nseiC/dds_waveform_generator/analog/simulation/pwl/LEIAME.txt

PWL dos 8 bits do DAC - DDS, seno de 1 kHz, 5 ciclos
=====================================================

Origem: simulação do VHDL do projeto (phase_accumulator + LUT, no GHDL), com
f = 1000 Hz, sel = "00" (seno, fpga/lut/sine_1024x8.mif) e clock do DDS de 10 MHz.
Os 50 001 códigos simulados são idênticos ao modelo do DDS:
    código[k] = seno[(k * FTW mod 2^32) >> 22]

    FTW = 429496            ->  f real = 999,9983 Hz
    1 amostra a cada 100 ns (10 MHz), 50 001 amostras = 5,0001 ms (5 ciclos)
    níveis 0 V e 3,3 V (LVTTL do GPIO da DE2-115), bordas de 2 ns
    código em offset binary: 128 = zero do sinal, faixa de 1 a 255

Arquivos
--------
    bit0.txt ... bit7.txt   PWL de cada bit, "tempo(s) tensão(V)" por linha
                            bit0 = LSB, bit7 = MSB
    dac_ideal.txt           referência: saída de um DAC ideal, 3,3 V * código / 256
    codigos.csv             código de 8 bits em cada amostra (t_s, codigo)

No LTspice
----------
    Fonte de tensão -> Advanced -> PWL File -> escolha o bitN.txt,
    ou escreva como valor da fonte:   PWL file=bit0.txt
    Salve o .asc nesta pasta: o caminho do arquivo é relativo ao esquemático.
    Simulação:   .tran 0 5m 0 50n   (passo máximo de 50 ns para ver os degraus)

Conferência
-----------
Com um R-2R ideal (R = 10 k, 2R = 20 k) ligado aos 8 bits, o LTspice 26 deu:
    máximo 3,287 V (código 255), mínimo 12,9 mV (código 1),
    diferença para dac_ideal.txt < 1 uV e frequência medida de 1000 Hz.
