nseiC/dds_waveform_generator/overleaf/preambulo/metadados.tex

%-----------------------------------------------------------------
% METADADOS DO TRABALHO
%-----------------------------------------------------------------

\author{Nicholas Seifert}
\title{Gerador de formas de onda por síntese digital direta em FPGA}
\engtitle{Direct digital synthesis waveform generator on FPGA}
\date{2026}
\advisor{André Luis Régis Monteiro, Prof.\ Dr.}
%---
% Deixe o comando \coadvisor comentado, caso não tenha co-orientador
\coadvisor{Márcio Rodrigues da Cunha, Prof.\ Dr.}
%---
% A DEFINIR: data da defesa
\approvaldate{A DEFINIR}
%---
% Membros da banca, titulação e instituição vinculada (A DEFINIR)
\boardst{MEMBRO DA BANCA A DEFINIR\\%
	Titulação\\%
	Instituição}
\boardnd{MEMBRO DA BANCA A DEFINIR\\%
	Titulação\\%
	Instituição}
\boardrd{MEMBRO DA BANCA A DEFINIR\\%
	Titulação\\%
	Instituição}
%---
