nseiC/dds_waveform_generator/overleaf/figuras/tb_dds_core_latencia.pdf

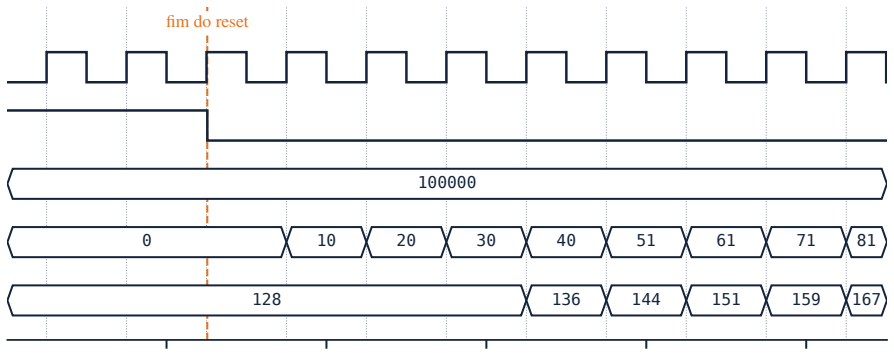
[picture p13: figure]
fim do reset

400 | 600 | 800 | 1000 | 1200

# tempo (ns)

## clk

## rst

## frequency

## endereço

## sample
