nseiC/dds_waveform_generator/overleaf/figuras/tb_DDS_pll.pdf

2000 | 2100 | 2200 | 2300 | 2400 | 2500 | 2600 | 2700
tempo (ns)

clk_50

clk10

led_locked

rst (interno)

dac | 80

PLL travado
