nseiC/dds_waveform_generator/overleaf/figuras/tb_reset_sync.pdf

200 | 400 | 600 | 800 | 1000 | 1200
tempo (ns)

clk

rst_in

chain

rst_out

111 | 110 | 100 | 000 | 111
rst_in cai | rst_in sobe
