nseiC/dds_waveform_generator/overleaf/main.tex

% TCC: Gerador de formas de onda por síntese digital direta em FPGA (Nicholas Seifert).
% Baseado no modelo canônico de TCC do curso de Engenharia Eletrônica da UTFPR campus Campo
% Mourão (prof. Osmar Tormena Júnior). Trechos em vermelho (\pendente) ainda dependem do autor.
%

%-----------------------------------------------------------------
% METADADOS PDF/A
%-----------------------------------------------------------------
\begin{filecontents*}{\jobname.xmpdata}
	\Author{Nicholas Seifert}
	\Title{Gerador de formas de onda por síntese digital direta em FPGA}
	\Language{pt-BR}
	\Keywords{síntese digital direta\sep FPGA\sep VHDL\sep gerador de funções\sep JTAG}
	\Publisher{RIUT}
	\Subject{Desenvolvimento de um gerador de formas de onda por síntese digital direta em FPGA, controlado por computador via Virtual JTAG, com placa analógica de saída.}
	\Copyright{Creative Commons}
	\CopyrightURL{https://creativecommons.org/licenses/by/4.0/deed.pt_BR}
	\Contributor{André Luis Régis Monteiro \sep Márcio Rodrigues da Cunha}
\end{filecontents*}

\documentclass[%
%---
% Escolha apenas uma das políticas de licenciamento
	by,				% licença CC-BY
%	by-sa,		% licença CC-BY-SA
%	by-nd,		% licença CC-BY-ND
%	by-nc,		% licença CC-BY-NC
%	by-nc-sa,	% licença CC-NC-SA
%	by-nc-nd,	% licença CC-BY-NC-ND
%---
%---
% Escolha apenas um formato de citação ABNT
%	alf	% citação (AUTOR, DATA), com referências em ordem alfabética
	num	% citação numérica, com referências na ordem de citação
%---
]{tcc-coele-cm}

%-----------------------------------------------------------------
% DADOS E CONFIGURAÇÕES PARTICULARES DO DOCUMENTO
%-----------------------------------------------------------------

\input{./preambulo/metadados}	% Metadados do trabalho
\input{./preambulo/preambulo}	% Pacotes adicionais e macros do autor

%-----------------------------------------------------------------
% ARQUIVO DE REFERÊNCIAS
%-----------------------------------------------------------------

\addbibresource{./postextual/refs.bib}

%-----------------------------------------------------------------
% INÍCIO DO DOCUMENTO
%-----------------------------------------------------------------

\begin{document}

%-----------------------------------------------------------------
% PARTE EXTERNA
%-----------------------------------------------------------------

\maketitle	% Capa

%-----------------------------------------------------------------
% PARTE INTERNA
%-----------------------------------------------------------------

%-----------------------------------------------------------------
% ELEMENTOS PRÉ-TEXTUAIS
%-----------------------------------------------------------------

\frontmatter
\maketitlepage		% Folha de rosto
\approval			% Folha de aprovação
\dedication			% Dedicatória (opcional)
\acknowledgment		% Agradecimentos (opcional)
\printepigraph		% Epígrafe (opcional)
\printabstract		% Resumo
\printengabstract	% Abstract
\printlof			% Lista de figuras (opcional)
\printlot			% Lista de tabelas (opcional)
\printloa			% Lista de acrônimos e siglas (opcional)
\printtoc			% Sumário

%-----------------------------------------------------------------
% ELEMENTOS TEXTUAIS
%-----------------------------------------------------------------

\mainmatter
\acresetall	% siglas por extenso de novo na primeira vez que aparecem no texto
\include{./textual/introducao}
\include{./textual/teoria}
\include{./textual/metodologia}
\include{./textual/resultados}
\include{./textual/conclusao}

%-----------------------------------------------------------------
% ELEMENTOS PÓS-TEXTUAIS
%-----------------------------------------------------------------

\backmatter
\printbibliography

%---
% Apêndices (opcional)
\appendix
\chapter{Organização do repositório}\label{ap:repositorio}
\input{./postextual/apendice}
\chapter{Visão RTL e simulação dos blocos menores}\label{ap:blocos}
\input{./postextual/apendice_blocos}
\chapter{Telas do osciloscópio}\label{ap:osciloscopio}
\input{./postextual/apendice_osciloscopio}
\chapter{Modelo SPICE do DAC0800}\label{ap:dac0800}
\input{./postextual/apendice_dac0800}
\chapter{Instrumentos utilizados}\label{ap:instrumentos}
\input{./postextual/apendice_instrumentos}
\chapter{Softwares utilizados}\label{ap:softwares}
\input{./postextual/apendice_softwares}
%---

%---
% Anexos (opcional)
%\attachment
%\chapter{Meu anexo}
%\input{./postextual/anexo}
%---

%-----------------------------------------------------------------
% FIM DO DOCUMENTO
%-----------------------------------------------------------------

\end{document}
