nseiC/dds_waveform_generator/overleaf/preambulo/preambulo.tex

%-----------------------------------------------------------------
% PACOTES DO AUTOR
%-----------------------------------------------------------------

\usepackage{multirow}	% célula em múltiplas linhas em uma tabela
\usepackage{listings}	% listagem de código (Apêndice D)
\lstset{basicstyle=\ttfamily\scriptsize, columns=fullflexible, keepspaces=true, breaklines=true,
	numbers=left, numberstyle=\tiny, xleftmargin=2em, framexleftmargin=2em, frame=tb,
	showstringspaces=false, upquote=true}

%-----------------------------------------------------------------
% DEFINIÇÕES DO AUTOR
%-----------------------------------------------------------------

% Trecho que ainda depende do autor (dados, ensaios em bancada): aparece em vermelho
% no PDF. Procure por \pendente antes da versão final.
\newcommand{\pendente}[1]{\textcolor{red}{[#1]}}

% Nomes de entidades, sinais e arquivos do projeto
\newcommand{\cod}[1]{\texttt{#1}}

% Epígrafe mais larga que o padrão do memoir (0,4), para os versos não quebrarem
\setlength{\epigraphwidth}{0.6\textwidth}

%-----------------------------------------------------------------
% DEFINIÇÕES DE SIGLAS, ACRÔNIMOS E ABREVIATURAS
%-----------------------------------------------------------------

\DeclareAcronym{csv}{%
	short=CSV,%
	long=Valores Separados por Vírgula,%
	foreign=\eng{Comma-Separated Values}%
}
\DeclareAcronym{dac}{%
	short=DAC,%
	long=Conversor Digital-Analógico,%
	foreign=\eng{Digital-to-Analog Converter}%
}
\DeclareAcronym{dds}{%
	short=DDS,%
	long=Síntese Digital Direta,%
	foreign=\eng{Direct Digital Synthesis}%
}
\DeclareAcronym{ecg}{%
	short=ECG,%
	long=Eletrocardiograma%
}
\DeclareAcronym{enob}{%
	short=ENOB,%
	long=Número Efetivo de Bits,%
	foreign=\eng{Effective Number of Bits}%
}
\DeclareAcronym{fft}{%
	short=FFT,%
	long=Transformada Rápida de Fourier,%
	foreign=\eng{Fast Fourier Transform}%
}
\DeclareAcronym{fpga}{%
	short=FPGA,%
	long=Arranjo de Portas Programável em Campo,%
	long-plural-form=Arranjos de Portas Programáveis em Campo,%
	foreign=\eng{Field-Programmable Gate Array}%
}
\DeclareAcronym{ftw}{%
	short=FTW,%
	long=Palavra de Sintonia de Frequência,%
	foreign=\eng{Frequency Tuning Word}%
}
\DeclareAcronym{gpio}{%
	short=GPIO,%
	long=Entrada e Saída de Uso Geral,%
	foreign=\eng{General-Purpose Input/Output}%
}
\DeclareAcronym{ip}{%
	short=IP,%
	long=Bloco de Propriedade Intelectual,%
	long-plural-form=Blocos de Propriedade Intelectual,%
	foreign=\eng{Intellectual Property}%
}
\DeclareAcronym{jtag}{%
	short=JTAG,%
	long=Grupo de Ação Conjunta de Teste,%
	foreign=\eng{Joint Test Action Group}%
}
\DeclareAcronym{le}{%
	short=LE,%
	long=Elemento Lógico,%
	long-plural-form=Elementos Lógicos,%
	foreign=\eng{Logic Element}%
}
\DeclareAcronym{lsb}{%
	short=LSB,%
	long=Bit Menos Significativo,%
	foreign=\eng{Least Significant Bit}%
}
\DeclareAcronym{lut}{%
	short=LUT,%
	long=Tabela de Consulta,%
	foreign=\eng{Look-Up Table}%
}
\DeclareAcronym{mif}{%
	short=MIF,%
	long=Arquivo de Inicialização de Memória,%
	foreign=\eng{Memory Initialization File}%
}
\DeclareAcronym{msb}{%
	short=MSB,%
	long=Bit Mais Significativo,%
	foreign=\eng{Most Significant Bit}%
}
\DeclareAcronym{pll}{%
	short=PLL,%
	long=Malha de Captura de Fase,%
	long-plural-form=Malhas de Captura de Fase,%
	foreign=\eng{Phase-Locked Loop}%
}
\DeclareAcronym{ram}{%
	short=RAM,%
	long=Memória de Acesso Aleatório,%
	long-plural-form=Memórias de Acesso Aleatório,%
	foreign=\eng{Random-Access Memory}%
}
\DeclareAcronym{rom}{%
	short=ROM,%
	long=Memória Somente de Leitura,%
	long-plural-form=Memórias Somente de Leitura,%
	foreign=\eng{Read-Only Memory}%
}
\DeclareAcronym{sdc}{%
	short=SDC,%
	long=Restrições de Projeto da Synopsys,%
	foreign=\eng{Synopsys Design Constraints}%
}
\DeclareAcronym{sfdr}{%
	short=SFDR,%
	long=Faixa Dinâmica Livre de Espúrios,%
	foreign=\eng{Spurious-Free Dynamic Range}%
}
\DeclareAcronym{sinad}{%
	short=SINAD,%
	long=Relação Sinal-Ruído e Distorção,%
	foreign=\eng{Signal-to-Noise and Distortion Ratio}%
}
\DeclareAcronym{snr}{%
	short=SNR,%
	long=Relação Sinal-Ruído,%
	foreign=\eng{Signal-to-Noise Ratio}%
}
\DeclareAcronym{tap}{%
	short=TAP,%
	long=Porta de Acesso de Teste,%
	foreign=\eng{Test Access Port}%
}
\DeclareAcronym{thd}{%
	short=THD,%
	long=Distorção Harmônica Total,%
	foreign=\eng{Total Harmonic Distortion}%
}
\DeclareAcronym{usb}{%
	short=USB,%
	long=Barramento Serial Universal,%
	foreign=\eng{Universal Serial Bus}%
}
\DeclareAcronym{utfpr}{%
	short=UTFPR-CM,%
	long=Universidade Tecnológica Federal do Paraná campus Campo Mourão%
}
\DeclareAcronym{vcd}{%
	short=VCD,%
	long=Arquivo de Mudança de Valores,%
	foreign=\eng{Value Change Dump}%
}
\DeclareAcronym{vhdl}{%
	short=VHDL,%
	long=Linguagem de Descrição de Hardware para Circuitos Integrados de Altíssima Velocidade,%
	foreign=\eng{VHSIC Hardware Description Language}%
}
\DeclareAcronym{zoh}{%
	short=ZOH,%
	long=Retentor de Ordem Zero,%
	foreign=\eng{Zero-Order Hold}%
}
