nseiC/dds_waveform_generator/overleaf/pretextual/agradecimentos.tex

Agradeço ao meu pai, exemplo de virtude em vida; à minha mãe, verdadeira guerreira apesar das dificuldades que a vida mostrou; à minha avó, pilar de sabedoria; ao corpo docente do DAELN-CM, pelo conhecimento compartilhado durante a graduação; ao prof.\ Dr.\ Lucas Ricken Garcia, pelo aconselhamento nas horas em que precisei; aos professores orientadores, pela oportunidade do projeto de ensino; ao prof.\ Dr.\ Francisco José Viglus, pela oportunidade de iniciação científica; e aos meus amigos, os verdadeiros, que não me julgaram diante das minhas dificuldades.
