nseiC/dds_waveform_generator/overleaf/pretextual/epigrafe.tex

% lista de epígrafes, o primeiro argumento é o texto, o segundo é a fonte
\qitem{Valeu a pena? Tudo vale a pena\\
Se a alma não é pequena.\\
Quem quer passar além do Bojador\\
Tem que passar além da dor.\\
Deus ao mar o perigo e o abismo deu,\\
Mas nele é que espelhou o céu.}%
{Fernando Pessoa, \enquote{Mar Português}, em \emph{Mensagem} (1934)}
