nseiC/dds_waveform_generator/overleaf/figuras/hierarquia.pdf

DDS | top-level: pinos da DE2-115
PLL | 50 MHz → 10 MHz (IP)
reset_sync | reset liberado em sincronia
jtag_interface | controle pelo PC
jtag | Virtual JTAG (IP)
jtag_control | lógica do controle
vjtag_dr | registrador DR (domínio do tck)
cmd_sync | travessia tck → 10 MHz
control_registers | frequência, forma, escrita na LUT
dds_core | núcleo do DDS (10 MHz)
phase_accumulator | acumulador de fase
frequency_translator | Hz → FTW
word_adder | FTW + fase
phase_register | registrador de 32 bits
truncator | fase(31..22)
LUT | fase → amplitude
sine/saw/sinc_LUT | ROMs 1024 × 8 (IP)
arbitrary_LUT | RAM de duas portas (IP)
out_mux | seleção da forma
output_register | amostra para o DAC
dac_clock | clock do DAC no GPIO[1]
