nseiC/dds_waveform_generator/overleaf/figuras/spice_fft.pdf

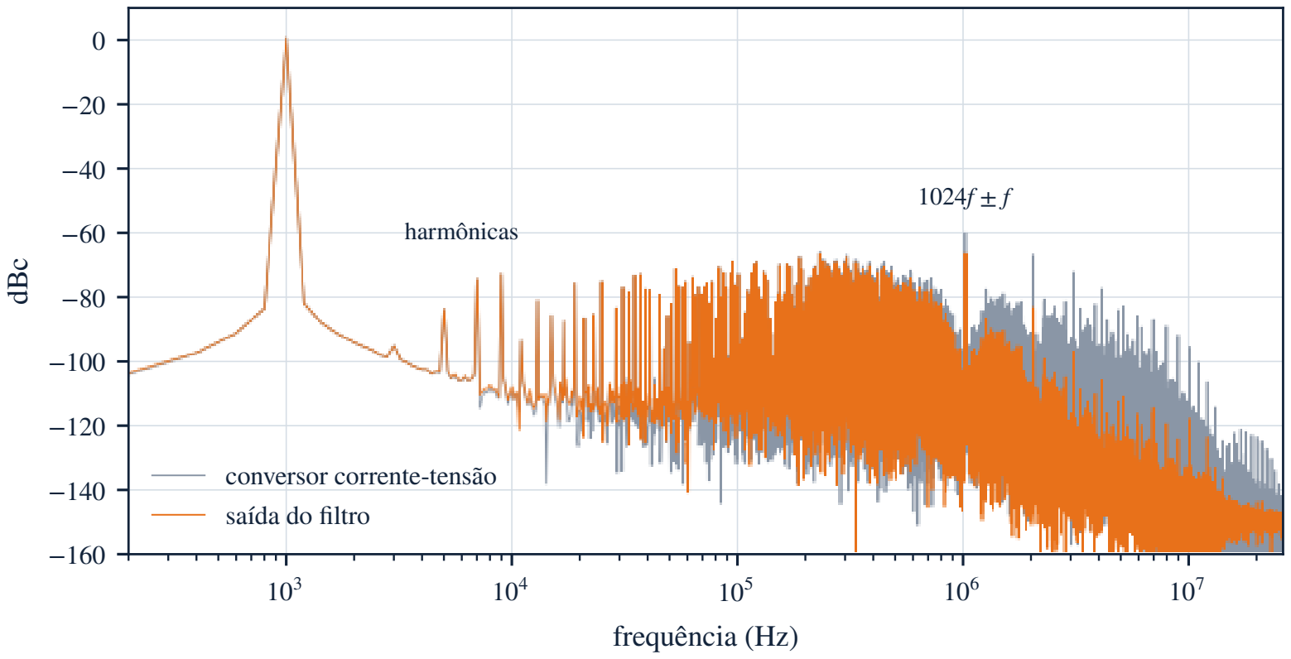
[picture p49: page 1]

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
frequência (Hz)

−160

−140

−120

−100

−80

−60

−40

−20

0

dBc

harmônicas

1024f ± f

conversor corrente-tensão
saída do filtro
