nseiC/dds_waveform_generator/overleaf/figuras/filtro.pdf

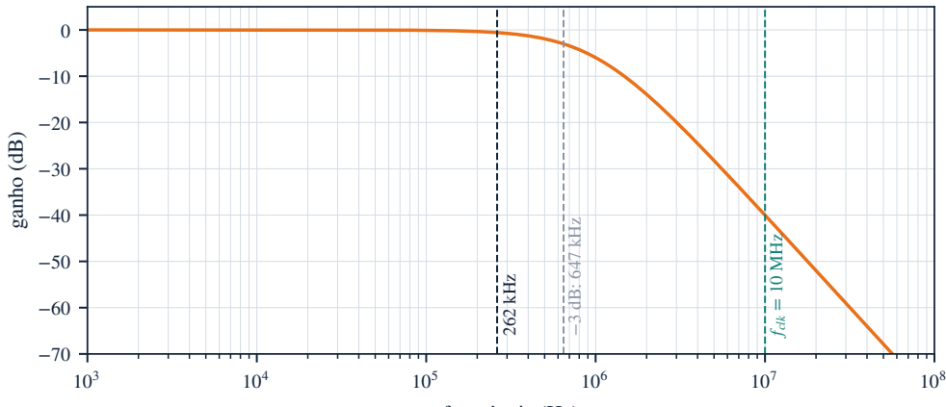
[picture p50: figure]
ganho (dB) −3 dB: 647 kHz 262 kHz; fclk = 10 MHz

8

# frequência (Hz)
