nseiC/dds_waveform_generator/overleaf/figuras/tb_cmd_sync.pdf

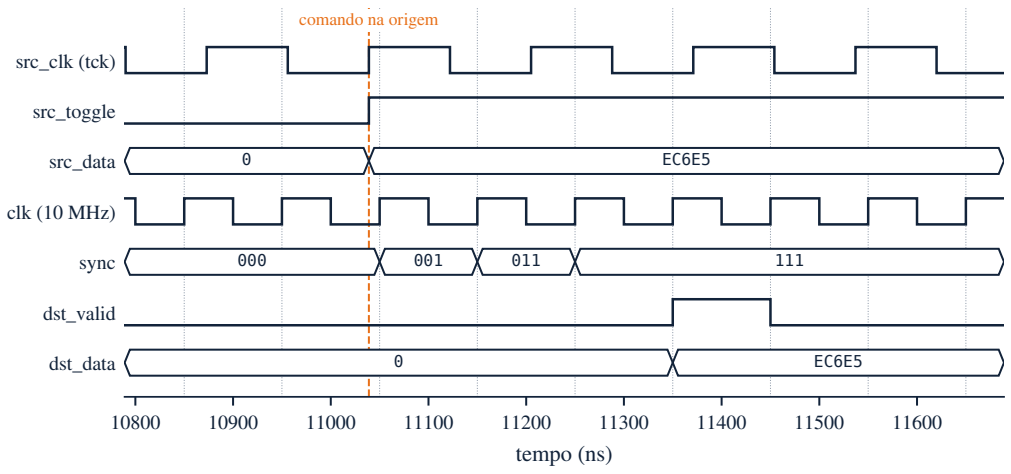
[picture p51: figure]
tempo (ns); src_clk (tck); src_toggle; src_data; clk (10 MHz); sync; dst_valid; dst_data; comando na origem
