nseiC/dds_waveform_generator/overleaf/figuras/tb_jtag_control.pdf

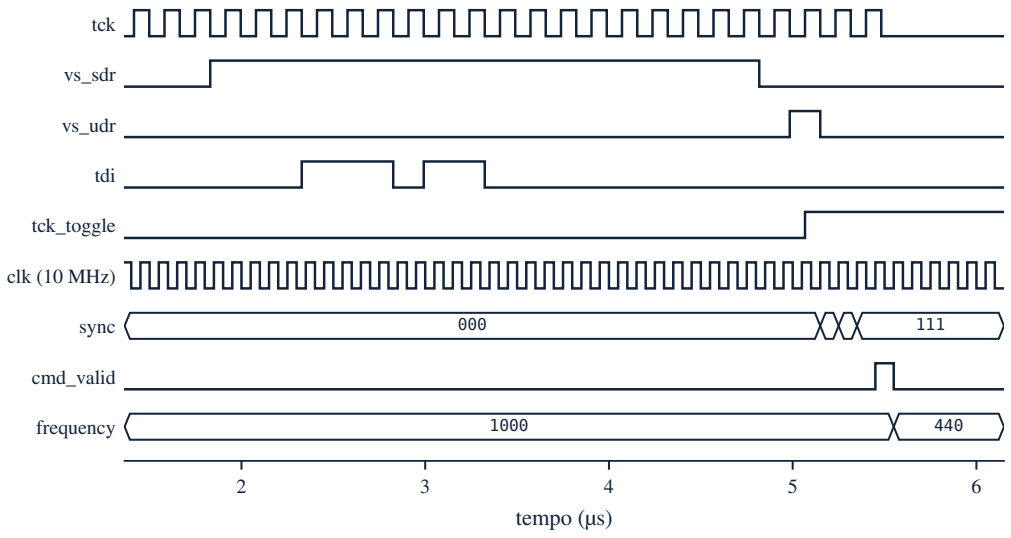
[picture p52: figure]
tempo (µs); tck; vs_sdr; vs_udr; tdi; tck_toggle; clk (10 MHz); sync; cmd_valid; frequency
