nseiC/dds_waveform_generator/overleaf/figuras/tb_LUT_latencia.pdf

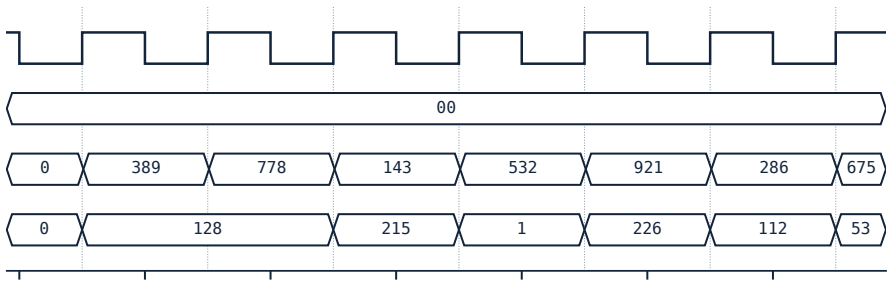
[picture p53: figure]

100 | 200 | 300 | 400 | 500 | 600 | 700

# tempo (ns)

## clk

## sel

## addr

## qOut
