nseiC/dds_waveform_generator/overleaf/figuras/tb_output_register.pdf

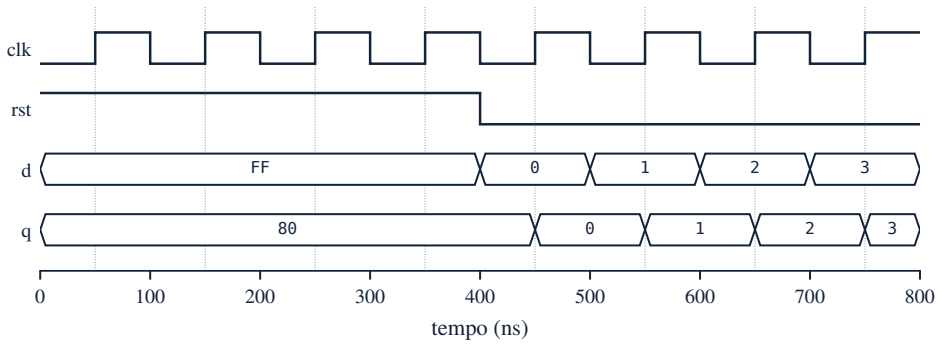
[picture p54: figure]
tempo (ns); clk; rst
