nseiC/dds_waveform_generator/overleaf/figuras/tb_phase_register.pdf

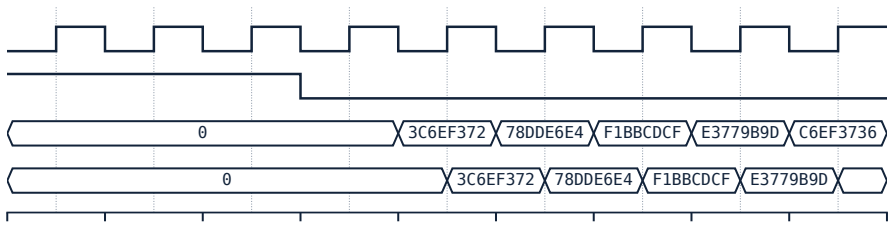
[picture p55: figure]
3C6EF372 78DDE6E4 F1BBCDCF E3779B9D C6EF3736; 78DDE6E4; F1BBCDCF

0 | 100 | 200 | 300 | 400 | 500 | 600 | 700 | 800 | 900

# tempo (ns)

## clk

## rst

## word

## wOut

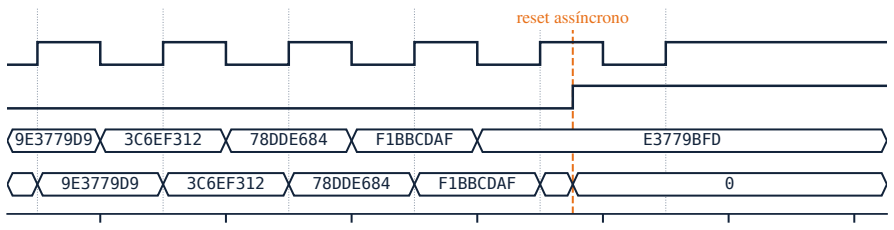
[picture p56: figure]
78DDE684; F1BBCDAF; E3779BFD; reset assíncrono

10000 | 10100 | 10200 | 10300 | 10400 | 10500 | 10600

# tempo (ns)

## clk rst word wOut
