nseiC/dds_waveform_generator/overleaf/figuras/tb_system_visao_geral.pdf

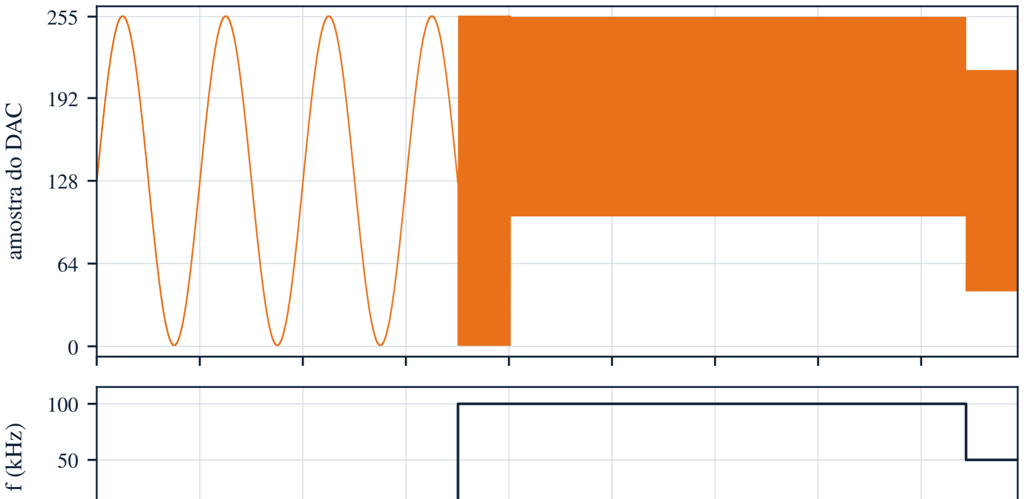
[picture p57: figure]
amostra do DAC; f (kHz)

0

0 | 1 | 2 | 3 | 4 | 5 | 6 | 7 | 8
tempo (ms)

JTAG

forma

1024 comandos de escrita na LUT

seno | sinc | arbitrária
