nseiC/dds_waveform_generator/overleaf/figuras/tb_word_adder.pdf

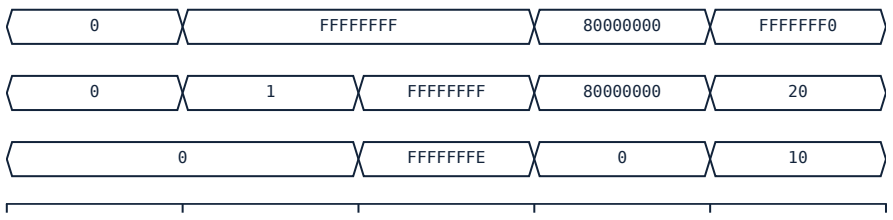
[picture p58: figure]
FFFFFFFF; FFFFFFF0; FFFFFFFE

0 | 1 | 2 | 3 | 4 | 5

# tempo (ns)

## ftw

## feedback

## wOut
