nseiC/dds_waveform_generator/overleaf/textual/resultados.tex

\chapter{Resultados e discussões}\label{cap:resultados}

Este capítulo apresenta os resultados da síntese do projeto digital no \ac{fpga}, da verificação por simulação, da simulação da placa analógica e dos ensaios em bancada, discutindo cada um.

\section{Síntese e análise de tempo}

O projeto foi compilado no Quartus Prime 18.1 Lite para o EP4CE115F29C7. A Tabela~\ref{tab:recursos} mostra os recursos usados. O gerador ocupa menos de 1\% dos elementos lógicos do \ac{fpga}. Os 32\,768~bits de memória correspondem às quatro tabelas de \(1024 \times 8\)~bits, e os quatro multiplicadores de \(9 \times 9\)~bits são os da conversão de frequência da Equação~(\ref{eq:ftw}). Os registradores de saída do barramento do \ac{dac} e o registrador de taxa dupla do seu clock foram efetivamente alocados nos elementos de entrada e saída, junto aos pinos.

\begin{table}
	\caption{Recursos do \acs{fpga} usados pelo projeto.}
	\label{tab:recursos}
	\begin{tabular}{l r r}\toprule
		Recurso & Usado & Disponível\\\midrule
		Elementos lógicos & 378 & 114\,480\\
		Registradores & 264 & ---\\
		Bits de memória & 32\,768 & 3\,981\,312\\
		Multiplicadores de \(9 \times 9\)~bits & 4 & 532\\
		\acp{pll} & 1 & 4\\
		Pinos & 14 & 529\\\bottomrule
	\end{tabular}
	\legend{Fonte~---~Autoria própria.}
\end{table}

A Tabela~\ref{tab:tempo} resume a análise de tempo, no modelo mais lento do dispositivo (1,2~V e 85~°C). O domínio de 10~MHz poderia operar a até 100,28~MHz, uma margem de dez vezes. O domínio do \ac{jtag} poderia operar a até 29,49~MHz, contra os 6~MHz máximos do USB-Blaster. Todas as folgas são positivas, e nenhum caminho ficou sem restrição de tempo.

\begin{table}
	\caption{Resultado da análise de tempo (modelo lento, 85~°C).}
	\label{tab:tempo}
	\begin{tabular}{l c c c}\toprule
		Domínio de clock & Frequência máxima & Folga de \eng{setup} & Folga de \eng{hold}\\\midrule
		10~MHz (\ac{pll}) & 100,28~MHz & 90,0~ns & 0,32~ns\\
		\cod{tck} (\ac{jtag}) & 29,49~MHz & 33,0~ns & 0,40~ns\\\bottomrule
	\end{tabular}
	\legend{Fonte~---~Autoria própria.}
\end{table}

A análise de metaestabilidade do Quartus identificou duas cadeias sincronizadoras de três registradores, a do \cod{cmd\_sync} e a do \cod{reset\_sync}, com tempo de acomodação disponível de pelo menos 293~ns, e estimou um tempo médio entre falhas típico superior a \(10^{9}\) anos para o projeto.

\section{Verificação do núcleo digital}

Os 16 \eng{testbenches} da Tabela~\ref{tab:testbenches} terminaram sem nenhum erro. A execução completa leva cerca de 2,5~min em um computador pessoal; os mais demorados são o \cod{tb\_frequency\_translator}, que percorre as \(2^{18}\) entradas, e o \cod{tb\_DDS}, que simula o modelo do \ac{pll}. As figuras de simulação desta seção e das seguintes foram desenhadas a partir dos sinais gravados nessas simulações. Antes de cada uma, uma figura mostra o bloco correspondente no RTL Viewer do Quartus, que desenha o circuito inferido a partir do \ac{vhdl}, depois da análise e elaboração do projeto. Os blocos menores, que não são discutidos aqui, têm a visão RTL e a simulação reunidas no Apêndice~\ref{ap:blocos}.

\subsection{Conversão de frequência}

No RTL, o conversor de frequência é um único multiplicador, \cod{Mult0}, entre a frequência de 18~bits e a constante \(K\) de 33~bits (\cod{33'h1ad7f29ac}), como mostra a Figura~\ref{fig:rtl_ftw}. Dos 51~bits do produto, os bits 50 a 24 formam a palavra de sintonia; o deslocamento da Equação~(\ref{eq:ftw}) não gera lógica.

\begin{figure}
	\caption{Visão RTL do conversor de frequência (\cod{frequency\_translator}).}
	\label{fig:rtl_ftw}
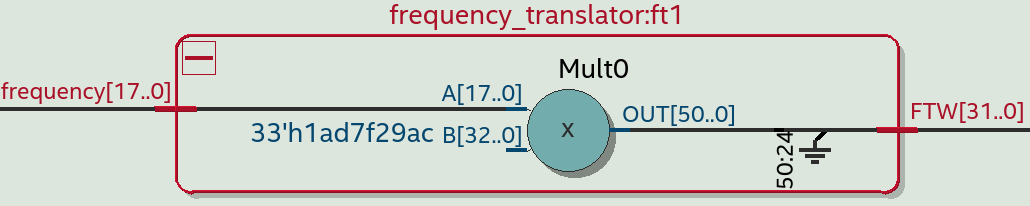
[picture p59: overleaf/figuras/rtl_frequency_translator.png]
	
	\legend{Fonte~---~Autoria própria.}
\end{figure}

O \eng{testbench} percorreu as \(2^{18}\) frequências possíveis, de 0 a 262\,143~Hz, e comparou a palavra de sintonia de cada uma com o valor exato \(f \cdot 2^{32}/f_{clk}\). Como a multiplicação descarta a parte fracionária, a palavra calculada fica sempre a menos de uma unidade do valor exato, como previsto no Capítulo~\ref{cap:metodologia}. O pior caso, em 2\,752~Hz, ficou 0,99986~\ac{lsb} abaixo. Uma unidade de \(M\) é o menor passo de frequência do gerador, 2,33~mHz: no relógio da Figura~\ref{fig:relogio_fase}, é uma marca a mais ou a menos no salto do ponteiro, entre os 4,3 bilhões do mostrador. No pior caso, portanto, a saída fica 2,3~mHz abaixo do pedido, menos de uma parte por milhão em 2\,752~Hz.

\subsection{Acumulador de fase}

A Figura~\ref{fig:rtl_acc} mostra o acumulador de fase no RTL: o conversor de frequência alimenta o somador, cuja saída é guardada no registrador de fase; a saída do registrador volta ao somador e segue para o truncador.

\begin{figure}
	\caption{Visão RTL do acumulador de fase (\cod{phase\_accumulator}).}
	\label{fig:rtl_acc}
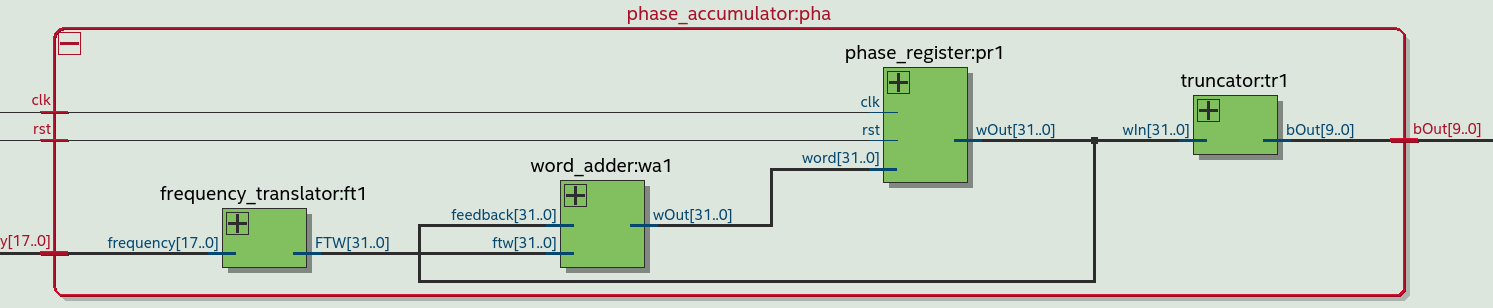
[picture p60: overleaf/figuras/rtl_phase_accumulator.png]
	
	\legend{Fonte~---~Autoria própria.}
\end{figure}

Para entender o que esse circuito faz, vale imaginar o acumulador como um relógio de um só ponteiro, com \(2^{32}\) marcas em volta do mostrador, cerca de 4,3 bilhões (Figura~\ref{fig:relogio_fase}). A cada clock, dez milhões de vezes por segundo, o ponteiro salta \(M\) marcas, e quando passa do topo continua a contagem do início, como um relógio de verdade. Cada volta completa é um período do sinal, e a frequência é o número de voltas por segundo. A tabela não enxerga as marcas uma a uma: o mostrador é dividido em 1024 setores, um por endereço, e a amostra só muda quando o ponteiro entra em outro setor. A roda de fase da Figura~\ref{fig:roda_fase} mostra a mesma ideia em escala reduzida.

\begin{figure}
	\caption{O acumulador de fase como um relógio de \(2^{32}\) marcas e 1024 setores, para três valores de \(M\). Ilustração fora de escala.}
	\label{fig:relogio_fase}
	
	\legend{Fonte~---~Autoria própria.}
\end{figure}

Com o menor salto possível, \(M = 1\), o ponteiro anda dez milhões de marcas por segundo, o que não chega a um grau, e leva 429,5~s, pouco mais de sete minutos, para dar uma volta. A frequência é de 2,33~mHz, o menor passo do gerador: cada unidade a mais em \(M\) acrescenta 2,33~mHz, e essa é a resolução \(\Delta f\). Para gerar 1~kHz, o ponteiro precisa dar uma volta a cada 10\,000 clocks, o que pede \(M = 2^{32}/10\,000 = 429\,496{,}7\). Como \(M\) é inteiro, o gerador usa 429\,496 e produz 999,9983~Hz, a 1,7~mHz do pedido, menos de um passo de resolução. Nesse caso, o ponteiro passa cerca de dez clocks em cada setor, e cada amostra da tabela se repete cerca de dez vezes. Na frequência máxima, de 262\,143~Hz, o salto é tão grande que a volta se completa em 38 clocks, e o ponteiro pula cerca de 27 setores de cada vez.

No \eng{testbench}, o endereço da tabela coincidiu com o do modelo de referência em todos os clocks, em 1~kHz e em trocas de frequência com o acumulador em operação. Em cada troca, o ponteiro continua do ponto em que estava e só passa a saltar com o novo \(M\). Por isso a troca de frequência não produz salto de fase. Com 0~Hz, o ponteiro fica parado.

\subsection{Tabelas de forma de onda}

A Figura~\ref{fig:rtl_lut} mostra a conversão de fase em amplitude no RTL: as três \acsp{rom} e a \acs{ram} recebem o mesmo endereço de leitura, a \acs{ram} tem também as entradas de escrita, e o multiplexador escolhe a saída pelo sinal \cod{sel}. As memórias aparecem como blocos fechados, pois são \acsp{ip}.

\begin{figure}
	\caption{Visão RTL das tabelas de forma de onda (\cod{LUT}).}
	\label{fig:rtl_lut}
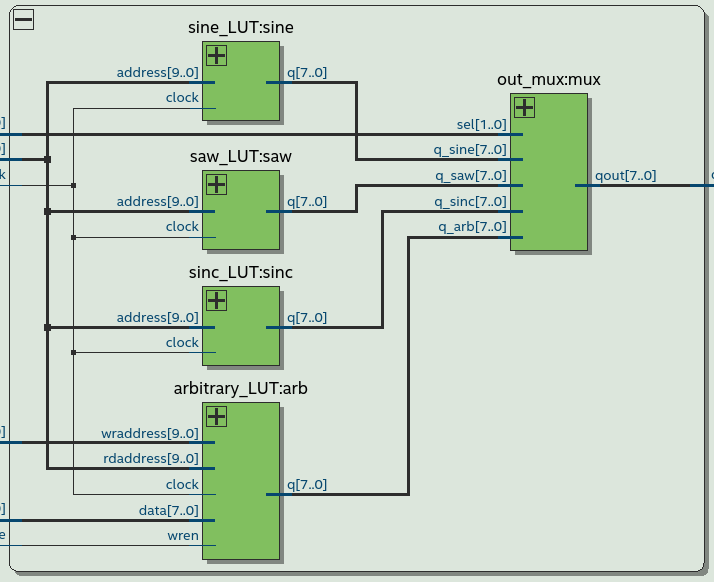
[picture p61: overleaf/figuras/rtl_LUT.png]
	
	\legend{Fonte~---~Autoria própria.}
\end{figure}

A Figura~\ref{fig:tb_lut} mostra, para cada memória, o valor lido em cada um dos 1024 endereços, percorridos em ordem embaralhada, sobre o conteúdo esperado dos arquivos \ac{mif}. As seis varreduras terminaram sem nenhuma diferença. A varredura (e) foi feita com a escrita de um novo padrão em toda a \ac{ram} ao mesmo tempo, e confirma que a escrita não perturba a leitura das outras tabelas; a varredura (f) confirma que a \ac{ram} devolve o padrão escrito, três períodos de uma senoide. A Figura~\ref{fig:tb_lut_lat} mostra a latência de dois clocks entre o endereço e a amostra.

\begin{figure}
	\caption{Leitura das quatro memórias, endereço a endereço, comparada com o conteúdo esperado.}
	\label{fig:tb_lut}
	
	\legend{Fonte~---~Autoria própria.}
\end{figure}

\begin{figure}
	\caption{Latência de dois clocks entre o endereço e a amostra nas memórias.}
	\label{fig:tb_lut_lat}
	
	\legend{Fonte~---~Autoria própria.}
\end{figure}

\subsection{Núcleo DDS}

A Figura~\ref{fig:rtl_core} mostra o núcleo no RTL, com os três blocos ligados em sequência: acumulador de fase, tabelas e registrador de saída.

\begin{figure}
	\caption{Visão RTL do núcleo \acs{dds} (\cod{dds\_core}).}
	\label{fig:rtl_core}
	
	\legend{Fonte~---~Autoria própria.}
\end{figure}

O \eng{testbench} do núcleo \cod{dds\_core} comparou 14\,034 amostras de saída com o modelo de referência, sem nenhuma diferença. A Figura~\ref{fig:tb_core} mostra trechos da saída em cada situação testada. Na Figura~\ref{fig:tb_core}(b), a frequência muda de 100~kHz para 262\,143~Hz no instante marcado pela linha tracejada, e o sinal continua sem descontinuidade. Na Figura~\ref{fig:tb_core}(f), a forma de onda é um dente de serra escrito na \ac{ram} enquanto o seno estava na saída.

\begin{figure}
	\caption{Saída do núcleo \acs{dds} para as quatro formas de onda, na troca de frequência e após a escrita da tabela arbitrária.}
	\label{fig:tb_core}
	
	\legend{Fonte~---~Autoria própria.}
\end{figure}

A Figura~\ref{fig:tb_core_lat} mostra a saída do \eng{reset} em 100~kHz. Durante o \eng{reset}, a amostra permanece em 128, o zero do sinal. Depois dele, o endereço avança 10 posições por clock (\(100~\text{kHz} \cdot 1024/10~\text{MHz} \approx 10{,}24\)), e cada endereço aparece na saída três clocks depois, como previsto.

\begin{figure}
	\caption{Saída do \eng{reset} no núcleo \acs{dds}: latência de três clocks entre o endereço e a amostra.}
	\label{fig:tb_core_lat}
	
	\legend{Fonte~---~Autoria própria.}
\end{figure}

\section{Verificação do controle pelo computador}

A Figura~\ref{fig:rtl_vjtag} mostra o \cod{vjtag\_dr} no RTL. À esquerda ficam o registrador de deslocamento \cod{dr}, de 18~bits, e o de \eng{bypass}, com os multiplexadores que escolhem entre carregar (Capture-DR) e deslocar (Shift-DR). À direita, os registradores do comando (\cod{ir\_reg}, \cod{data\_reg} e \cod{toggle}) são habilitados pela porta \cod{update}, que combina \cod{vs\_udr} com a comparação de \cod{ir\_in} com \cod{00} (\cod{Equal0}), de modo que a instrução de \eng{bypass} não gera comando. Os valores guardados para o Capture-DR (\cod{shadow}) foram inferidos como uma pequena memória síncrona, e o multiplexador \cod{tdo} escolhe entre o \eng{bypass} e o bit 0 de \cod{dr}.

\begin{figure}
	\caption{Visão RTL do registrador de dados do Virtual \acs{jtag} (\cod{vjtag\_dr}).}
	\label{fig:rtl_vjtag}
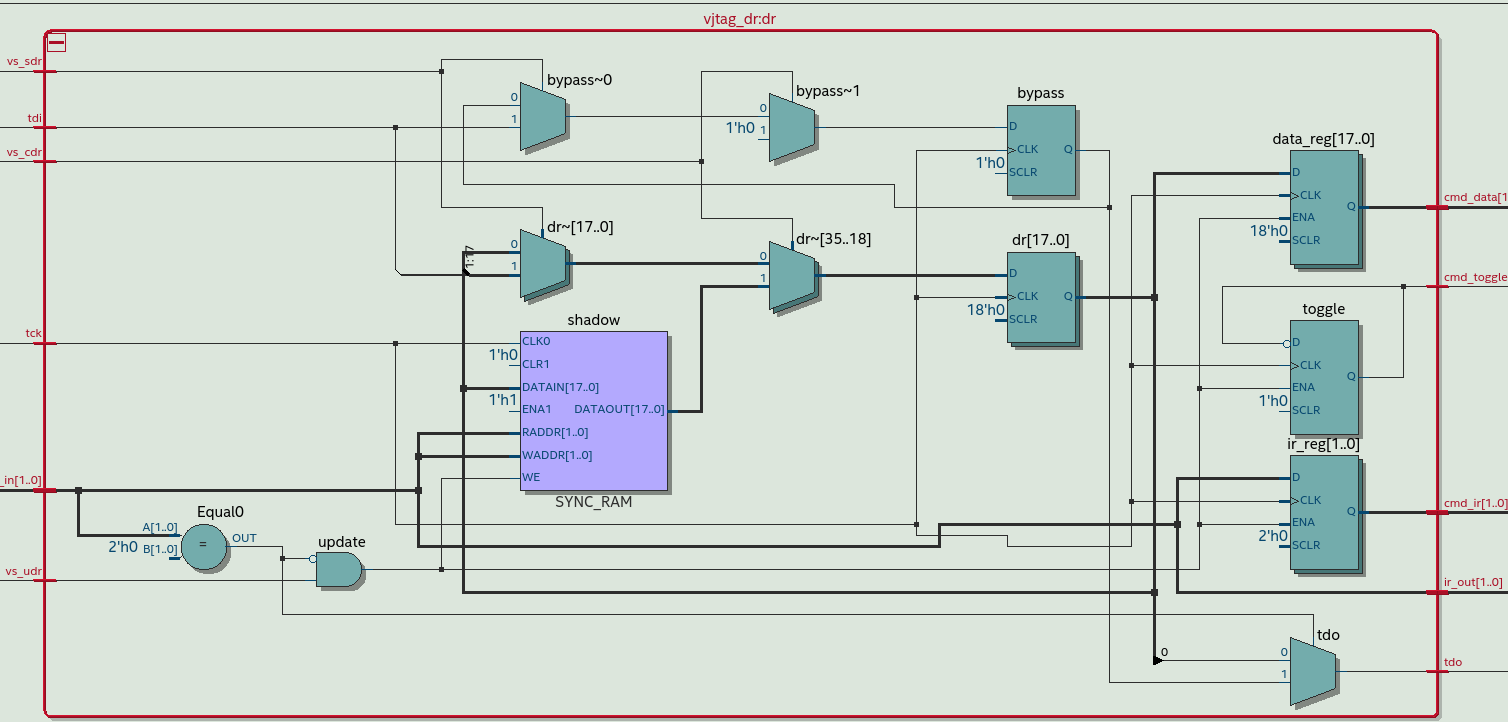
[picture p62: overleaf/figuras/rtl_vjtag_dr.png]
	
	\legend{Fonte~---~Autoria própria.}
\end{figure}

A Figura~\ref{fig:tb_vjtag} mostra dois comandos de frequência no bloco \cod{vjtag\_dr}. Em cada um, o Capture-DR é seguido de 18 ciclos de Shift-DR, em que os bits entram por \cod{tdi}, com o \ac{lsb} primeiro, e o registrador \cod{dr} se forma. No Update-DR, o valor é copiado para \cod{cmd\_data} e \cod{cmd\_toggle} muda de nível. Durante o segundo deslocamento, \cod{tdo} devolve o valor do primeiro comando (\cod{2A5A5}), carregado no Capture-DR, o que permite ler a configuração.

\begin{figure}
	\caption{Dois comandos de frequência no registrador de dados do Virtual \acs{jtag}.}
	\label{fig:tb_vjtag}
	
	\legend{Fonte~---~Autoria própria.}
\end{figure}

A Figura~\ref{fig:rtl_cmd_sync} mostra o \cod{cmd\_sync} no RTL: a cadeia de três \eng{flip-flops} do sincronizador (\cod{sync}), o registrador \cod{last}, que guarda o último nível visto, a comparação entre os dois e os registradores de saída \cod{valid} e \cod{data}.

\begin{figure}
	\caption{Visão RTL da passagem de comandos entre domínios de clock (\cod{cmd\_sync}).}
	\label{fig:rtl_cmd_sync}
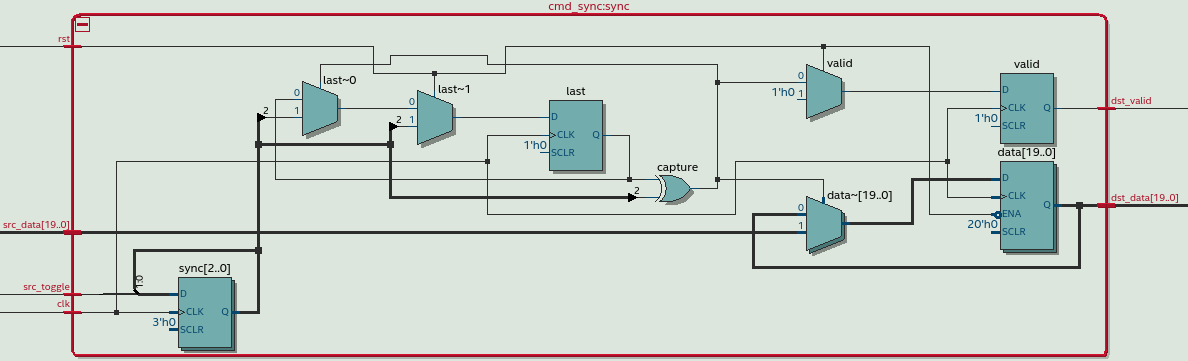
[picture p63: overleaf/figuras/rtl_cmd_sync.png]
	
	\legend{Fonte~---~Autoria própria.}
\end{figure}

A Figura~\ref{fig:tb_cmd_sync} mostra a passagem de um comando para o domínio de 10~MHz. A mudança de \cod{src\_toggle} percorre os três \eng{flip-flops} do sincronizador; quando chega ao último, o dado é copiado para \cod{dst\_data} e \cod{dst\_valid} pulsa por um clock. No \eng{testbench}, 300 comandos com dados e intervalos aleatórios, gerados por um clock de 6~MHz sem relação de fase com o de destino, foram entregues uma única vez, em ordem e com o dado correto, e um \eng{reset} no destino não repetiu nenhum comando.

\begin{figure}
	\caption{Passagem de um comando do domínio do \cod{tck} para o de 10~MHz.}
	\label{fig:tb_cmd_sync}
	
	\legend{Fonte~---~Autoria própria.}
\end{figure}

A Figura~\ref{fig:rtl_jtag} mostra o \cod{jtag\_control} no RTL, com os três blocos: \cod{vjtag\_dr}, \cod{cmd\_sync} e \cod{control\_registers}. O comando de 20~bits sai do \cod{vjtag\_dr}, atravessa o \cod{cmd\_sync} e é separado em instrução e dado na entrada dos registradores.

\begin{figure}
	\caption{Visão RTL do controle pelo computador (\cod{jtag\_control}).}
	\label{fig:rtl_jtag}
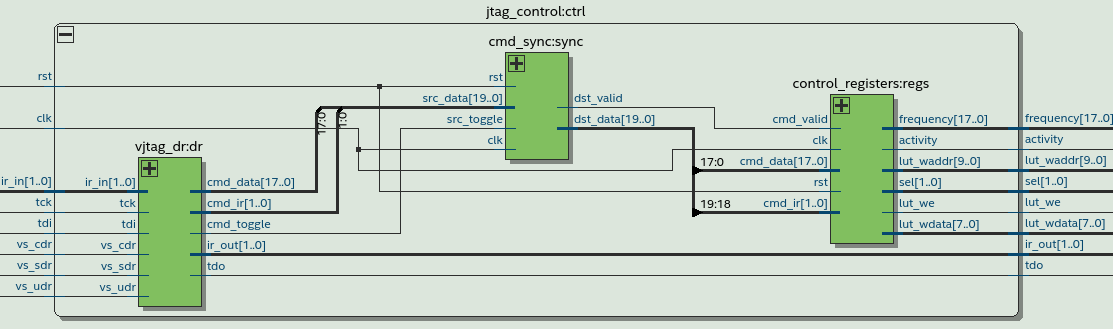
[picture p64: overleaf/figuras/rtl_jtag_control.png]
	
	\legend{Fonte~---~Autoria própria.}
\end{figure}

A Figura~\ref{fig:tb_jtag} mostra o caminho completo de um comando de 440~Hz no bloco \cod{jtag\_control}: do deslocamento no domínio do \cod{tck} até o registrador de frequência no domínio de 10~MHz. O registrador é atualizado 566~ns após o Update-DR, um tempo muito menor que o de um novo deslocamento. No mesmo \eng{testbench}, 64 escritas consecutivas na tabela geraram 64 pulsos de escrita, na ordem e com os endereços e dados corretos.

\begin{figure}
	\caption{Comando de frequência do registrador de dados do \acs{jtag} até o registrador de frequência.}
	\label{fig:tb_jtag}
	
	\legend{Fonte~---~Autoria própria.}
\end{figure}

\section{Verificação do sistema}

A Figura~\ref{fig:rtl_dds} mostra a entidade do topo no RTL. Ela contém apenas as ligações entre o \ac{pll}, o \cod{reset\_sync}, o \cod{jtag\_interface} e o \cod{dds\_core}, além da porta OU que combina o botão de \eng{reset} com a indicação de travamento do \ac{pll}.

\begin{figure}
	\caption{Visão RTL da entidade do topo (\cod{DDS}).}
	\label{fig:rtl_dds}
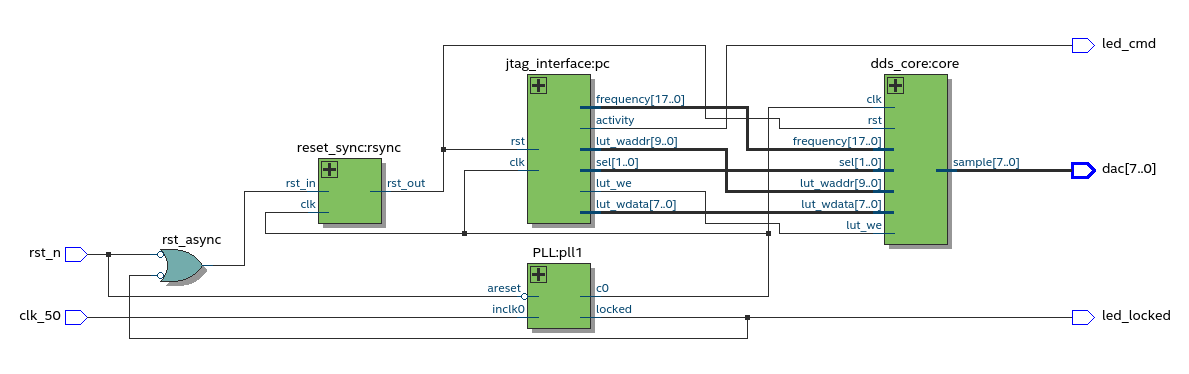
[picture p65: overleaf/figuras/rtl_DDS.png]
	
	\legend{Fonte~---~Autoria própria.}
\end{figure}

O \eng{testbench} \cod{tb\_system} reúne o controle e o núcleo e faz o papel do computador, enviando a mesma sequência de comandos que a interface gráfica enviaria. A Figura~\ref{fig:tb_sys} mostra a saída durante toda a simulação. Após o \eng{reset}, sem nenhum comando, o gerador produz o seno de 1~kHz. Em seguida, o computador pede 100~kHz e seno, depois sinc, envia uma tabela inteira, com 1024 escritas, e escolhe a forma arbitrária em 50~kHz. A Figura~\ref{fig:tb_sys_det}(a) mostra o momento em que o comando de frequência chega, e a Figura~\ref{fig:tb_sys_det}(b), a tabela enviada sendo reproduzida. Em cada trecho, cada amostra foi comparada com a tabela correspondente, e a frequência medida pelas voltas do endereço coincidiu com a pedida, dentro da tolerância de 0,1\% usada no \eng{testbench}.

\begin{figure}
	\caption{Saída do sistema durante a sequência de comandos do computador.}
	\label{fig:tb_sys}
	
	\legend{Fonte~---~Autoria própria.}
\end{figure}

\begin{figure}
	\caption{Detalhes da simulação do sistema: (a) chegada do comando de frequência; (b) tabela enviada pelo \acs{jtag} reproduzida na saída.}
	\label{fig:tb_sys_det}
	
	\legend{Fonte~---~Autoria própria.}
\end{figure}

Por fim, o \eng{testbench} \cod{tb\_DDS} simula a entidade do topo, com o \ac{pll} e as memórias pelos modelos da Intel. A Figura~\ref{fig:tb_pll} mostra o travamento do \ac{pll}: o clock de 10~MHz surge, o \eng{LED} de travamento acende e o \eng{reset} interno é liberado três clocks depois. Com o \ac{pll} travado, o \eng{testbench} também confere que o clock do \ac{dac} tem 10~MHz, que sua borda de subida ocorre com o clock interno em nível baixo e que os bits do \ac{dac} ficam estáveis de 45~ns antes a 45~ns depois de cada borda. A Figura~\ref{fig:tb_dds} mostra os pinos do \ac{dac}: o seno de 1~kHz após a liberação do botão e o retorno ao código 128 quando o botão é pressionado novamente. A frequência medida nos pinos ficou dentro de 1~Hz de 1~kHz, a tolerância usada no \eng{testbench}.

\begin{figure}
	\caption{Travamento do \acs{pll} e liberação do \eng{reset} interno na entidade do topo.}
	\label{fig:tb_pll}
	
	\legend{Fonte~---~Autoria própria.}
\end{figure}

\begin{figure}
	\caption{Código nos pinos do \acs{dac} na simulação da entidade do topo.}
	\label{fig:tb_dds}
	
	\legend{Fonte~---~Autoria própria.}
\end{figure}

\section{Simulação da placa analógica}\label{sec:spice}

A simulação no LTspice cobre 5~ms, ou cinco períodos do seno de 1~kHz produzido pelo \ac{vhdl}. A Figura~\ref{fig:spice_tempo}(a) mostra a tensão na saída do conversor corrente-tensão e na saída final, depois do ganho, do filtro e do \eng{buffer}; a inversão de fase entre as duas vem do amplificador inversor. A Tabela~\ref{tab:spice} compara os valores obtidos com os calculados no Capítulo~\ref{cap:metodologia}, e todos coincidem. A tensão correspondente ao código 128 não é exatamente zero: como \(I_{FS} = I_{REF} \cdot 255/256\), pela Equação~(\ref{eq:dac0800}), o código 128 dá \(I_{OUT} - \overline{I_{OUT}} = I_{REF}/256\), ou 7,81~mV na saída do conversor.

\begin{table}
	\caption{Valores obtidos na simulação do circuito analógico.}
	\label{tab:spice}
	\begin{tabular}{l c c}\toprule
		Grandeza & Simulado & Calculado\\\midrule
		Corrente de escala completa do \acs{dac} & 1,99~mA & 1,992~mA\\
		Excursão do conversor corrente-tensão & \(-1{,}976\) a \(+1{,}991\)~V & \(-1{,}977\) a \(+1{,}992\)~V\\
		Tensão do código 128 no conversor & 7,81~mV & 7,81~mV\\
		Ganho do estágio inversor & \(-1{,}19999\) & \(-1{,}2\)\\
		Excursão da saída & 4,760~V de pico a pico & 4,763~V de pico a pico\\
		Frequência & 1,000~kHz & 999,998~Hz\\
		Atraso do filtro em 1~kHz & 321~ns & 317~ns\\\bottomrule
	\end{tabular}
	\legend{Fonte~---~Autoria própria.}
\end{table}

A Figura~\ref{fig:spice_tempo}(b) mostra o efeito do filtro de reconstrução em uma subida do seno. Antes do filtro, a saída é uma escada: em 1~kHz, cada código dura cerca de 1~\(\mu\)s e cada degrau tem 18,75~mV, um \ac{lsb} multiplicado pelo ganho. Depois do filtro, as transições ficam suavizadas e atrasadas em 321~ns. Esse atraso concorda com o atraso de grupo de um filtro de segunda ordem em baixa frequência, \(1/(Q\,\omega_0) \approx 317\)~ns, e não depende da forma de onda.

\begin{figure}
	\caption{Simulação da placa analógica para o seno de 1~kHz: (a) saídas do conversor corrente-tensão e do circuito; (b) detalhe de uma subida, antes e depois do filtro.}
	\label{fig:spice_tempo}
	
	\legend{Fonte~---~Autoria própria.}
\end{figure}

A Figura~\ref{fig:spice_fft} mostra o espectro dos dois pontos, calculado pelo LTspice com resolução de 200~Hz e normalizado pela componente de 1~kHz. Aparecem três grupos de componentes, todos previstos no Capítulo~\ref{cap:teoria}:
\begin{description}
	\item[Harmônicas] --- principalmente ímpares, com a maior, a 9.ª, em \(-73{,}4\)~dBc, e distorção harmônica total, da 2.ª à 10.ª, de \(-70{,}9\)~dBc. Elas vêm da quantização em 8~bits: como o período tem exatamente 1024 amostras, o erro de quantização se repete a cada período e se concentra em harmônicas, em vez de se espalhar como ruído. O filtro não as altera, pois estão dentro da banda passante;
	\item[Imagens da tabela] --- em \(1024 f_{out} \pm f_{out}\) (1,023 e 1,025~MHz). Em 1~kHz, a saída é uma escada de 1024 degraus por período, atualizada a 1,024~MHz, e a Equação~(\ref{eq:zoh}) passa a valer com essa taxa no lugar de \(f_{clk}\). Essa é a maior componente indesejada: \(-60{,}5\)~dBc antes do filtro, em acordo com o limite de \(6{,}02\,P\) da Equação~(\ref{eq:sfdr}), e \(-67{,}0\)~dBc depois, pois o filtro atenua cerca de 6~dB em \(f_0\), como esperado para \(Q = 0{,}5\);
	\item[Imagens do clock] --- em \(f_{clk} \pm f_{out}\), em \(-96\)~dBc antes do filtro e \(-119\)~dBc depois, já próximas do piso numérico da simulação. Nesse ponto, a envoltória sinc da Equação~(\ref{eq:zoh}) vale cerca de \(f_{out}/f_{clk}\), ou \(-80\)~dB, e as transições do \acs{dac} e a banda limitada dos amplificadores atenuam um pouco mais.
\end{description}

\begin{figure}
	\caption{Espectro da simulação da placa analógica para o seno de 1~kHz, antes e depois do filtro de reconstrução.}
	\label{fig:spice_fft}
	
	\legend{Fonte~---~Autoria própria.}
\end{figure}

\section{Ensaios em bancada}\label{sec:bancada}

A Figura~\ref{fig:bancada} mostra a montagem de bancada: a DE2-115, a placa analógica ligada ao conector de expansão, as fontes de \(\pm15\)~V e +10~V e o osciloscópio. Uma medição preliminar da placa analógica, feita em 3 de setembro de 2026 com o código legado (Seção~\ref{sec:legado}), é mostrada na Figura~\ref{fig:medicao}: um seno de 100,0~Hz com 5,08~V de pico a pico.

\begin{figure}
	\caption{Montagem de bancada.}
	\label{fig:bancada}
	
	\legend{Fonte~---~Autoria própria.}
\end{figure}

\begin{figure}
	\caption{Medição preliminar na saída da placa analógica: seno de 100,0~Hz com 5,08~V de pico a pico.}
	\label{fig:medicao}
	
	\legend{Fonte~---~Autoria própria.}
\end{figure}

\subsection{Condições dos ensaios}

Os ensaios com o código final foram feitos em 5 de outubro de 2026, com a frequência e a forma de onda escolhidas pela interface gráfica. As medidas usaram um osciloscópio Tektronix TBS1102B, de 100~MHz, 2~GS/s e 8~bits, em modo de amostragem simples e com acoplamento AC. Em cada medida foram salvos a tela e os 2500 pontos do canal em um arquivo \ac{csv}; as formas de onda das figuras desta seção foram desenhadas a partir desses arquivos. As telas estão no Apêndice~\ref{ap:osciloscopio}, e os arquivos, na pasta \cod{analog/resultados/} do repositório.

Foram medidos dois pontos da placa:
\begin{description}
	\item[Saída] --- a saída do seguidor de tensão (U1D), onde antes ficava o estágio classe AB e que é hoje a saída do circuito, com o potenciômetro de ganho ajustado para cerca de 0,67~V de pico a pico;
	\item[Subtrator] --- a saída do amplificador de diferenças que converte as correntes do \acs{dac} em tensão (U1A), logo após o conversor.
\end{description}
Durante as medidas, o resistor de realimentação do subtrator (R6) tinha um capacitor de 460~pF em paralelo, acrescentado como teste para atenuar os picos de chaveamento do \acs{dac}. Ele põe um polo em 346~kHz nessa realimentação, sem efeito nas frequências medidas.

\subsection{Diagnóstico do barramento do \acs{dac}}

Nos primeiros ensaios, o seno apresentava um serrilhado que crescia com a frequência e se concentrava perto dos cruzamentos por zero. O mesmo efeito aparecia com o código legado, o que apontava para o \eng{hardware}. Para isolar a causa, foram criadas duas tabelas de teste, \cod{teste\_bits\_1a4.txt} e \cod{teste\_bits\_todos.txt} (em \cod{fpga/lut/}), carregadas na memória arbitrária pela interface gráfica. Cada trecho dessas tabelas alterna um único bit em torno do código 128, de modo que a saída mostra um pulso por bit, com altura proporcional ao peso do bit. Em um conversor correto, cada pulso tem o dobro da altura do anterior.

O pulso do bit~2 não apareceu. Com esse bit sem efeito, a saída percorre só quatro códigos a cada oito e depois salta, o que produz o serrilhado observado. Com o \acs{dac} fora do soquete, a linha desse bit não apresentava nível lógico, apenas o acoplamento das linhas vizinhas, o que indicou um circuito aberto entre o \ac{fpga} e a placa. A causa estava no cabo, junto ao pino 5 do conector de expansão (\acs{gpio}[4]), e foi corrigida.

As capturas a seguir foram feitas depois da correção. Para conferir, o desvio de cada amostra em relação ao seno ajustado foi agrupado pelo resto da divisão do código por oito: a diferença entre os códigos com o bit~2 em 1 e em 0 ficou abaixo de 0,1~\acs{lsb}, contra os 4~\acs{lsb} que o defeito produziria.

\subsection{Frequência e formas de onda}

A Tabela~\ref{tab:bancada} resume as medidas de seno nos dois pontos. A frequência gerada é a que o \ac{fpga} produz de fato, \(M f_{clk}/2^{32}\), com \(M\) calculado pela Equação~(\ref{eq:ftw}); a medida é a do contador do osciloscópio, de seis dígitos. A tabela traz também a amplitude de pico a pico, a \ac{sinad} e a \ac{thd}, calculadas a partir dos pontos de cada captura. Todas as medidas ficaram entre 0,7 e 12~ppm acima da frequência gerada, a maioria com cerca de 10~ppm. Esse desvio comum a todas as frequências é a diferença entre o oscilador de 50~MHz da DE2-115 e a base de tempo do osciloscópio, ambos com tolerância dessa ordem. A conversão de frequência, portanto, não acrescenta erro mensurável. Em 10~Hz o contador não mede, mas o ajuste de um seno aos pontos deu 9,99779~Hz, em acordo com os 9,99775~Hz previstos. Nessa frequência, o truncamento da palavra de sintonia, de até 2,33~mHz, fica visível: 225~ppm abaixo dos 10~Hz pedidos.

\begin{table}
	\caption{Medidas de seno em bancada, na saída e no subtrator.}
	\label{tab:bancada}
	\begin{tabular}{l r r r r r r}\toprule
		Ponto & Pedida & Gerada (Hz) & Medida (Hz) & \(V_{pp}\) (mV) & \acs{sinad} (dB) & \acs{thd} (dBc)\\\midrule
		Saída & 10~Hz & 9,99775 & --- & 549 & 35,6 & \(-50{,}4\)\\
		Saída & 100~Hz & 99,99843 & 99,9994 & 673 & 37,2 & \(-48{,}9\)\\
		Saída & 1~kHz & 999,99830 & 1\,000,01 & 677 & 34,1 & \(-43{,}0\)\\
		Saída & 10~kHz & 9\,999,9993 & 10\,000,1 & 667 & 15,6 & \(-17{,}3\)\\
		Subtrator & 10~kHz & 9\,999,9993 & 10\,000,1 & 2\,118 & 32,3 & \(-46{,}8\)\\
		Subtrator & 20~kHz & 19\,999,9986 & 20\,000,2 & 2\,105 & 31,7 & \(-42{,}8\)\\
		Subtrator & 30~kHz & 29\,999,9979 & 30\,000,3 & 2\,100 & 17,0 & \(-17{,}2\)\\\bottomrule
	\end{tabular}
	\legend{Fonte~---~Autoria própria.}
\end{table}

A Figura~\ref{fig:bancada_senos} mostra os senos medidos na saída, com o seno ajustado a cada captura. Até 1~kHz, a medida se sobrepõe ao seno ajustado; em 10~kHz, aparece a distorção nos cruzamentos por zero, discutida adiante. A amplitude ficou constante de 100~Hz a 10~kHz. Em 10~Hz, a amplitude menor, de 549~mV, vem do acoplamento AC do osciloscópio, cujo corte fica perto de 10~Hz, e não do gerador.

\begin{figure}
	\caption{Senos medidos na saída da placa, com o seno ajustado a cada captura.}
	\label{fig:bancada_senos}
	
	\legend{Fonte~---~Autoria própria.}
\end{figure}

A \acs{sinad}, que compara a fundamental com todo o restante (harmônicas, ruído e quantização), ficou entre 34,1 e 37,2~dB até 1~kHz, o que corresponde a um \ac{enob} de 5,4 a 5,9~bits. Esse valor é limitado pela própria medida. Na escala de 100~mV/div, o conversor de 8~bits do osciloscópio tem degraus de 4~mV, e o seu erro de quantização, somado ao do \acs{dac}, cujo \acs{lsb} vale 2,65~mV nesse ponto, já limita a \acs{sinad} a cerca de 45~dB; o restante vem de ruído e da ondulação de 10~MHz. Pelo mesmo motivo, a \acs{thd} medida, de \(-43\) a \(-50\)~dBc, não permite confirmar os \(-70{,}9\)~dBc da simulação, o que exigiria um instrumento de maior resolução.

No subtrator, a amplitude foi de 2,1~V de pico a pico, cerca de metade dos 3,97~V calculados para a corrente de escala completa de 1,99~mA em 1~k\(\Omega\) (Tabela~\ref{tab:spice}). Os resistores da referência, R1 e R2, são de 5~k\(\Omega\), como na simulação, o que mantém \(I_{REF}\) em 2~mA.

A Figura~\ref{fig:bancada_formas} mostra as demais formas de onda em 100~Hz: a rampa, a função sinc e a forma arbitrária, com a tabela do \ac{ecg} que a memória carrega ao ligar. Essa tabela tem dois batimentos por período, e por isso o contador mediu 199,998~Hz. Na rampa e na sinc, o contador mediu 99,9985 e 99,9993~Hz, também a menos de 10~ppm da frequência gerada.

\begin{figure}
	\caption{Demais formas de onda medidas na saída da placa, em 100~Hz.}
	\label{fig:bancada_formas}
	
	\legend{Fonte~---~Autoria própria.}
\end{figure}

\subsection{Espectro}

A Figura~\ref{fig:bancada_fft} mostra os espectros calculados pelo osciloscópio na saída, com 1024 pontos e janela retangular, normalizados pela maior componente:
\begin{description}
	\item[Até 2,5~kHz] --- (a), o seno de 100~Hz amostrado a 5~kS/s: a fundamental e o espalhamento da janela retangular, que encobre as harmônicas;
	\item[Até 50~MHz] --- (b), o mesmo seno amostrado a 100~MS/s. A faixa inclui as imagens em torno de \(f_{clk}\), mas nenhuma componente passou de \(-45{,}6\)~dBc (em 1,46~MHz), e as demais ficaram abaixo de \(-46\)~dBc, perto do piso do instrumento. As imagens em \(f_{clk} \pm f_{out}\), que a simulação previu em \(-119\)~dBc, ficam abaixo desse piso;
	\item[Seno de 10~kHz a 2,5~kS/s] --- (c), abaixo da taxa de Nyquist. A fundamental aparece dobrada em 101~Hz, \(|10\,000 - 4 \cdot 2\,525|\), e as harmônicas da distorção discutida a seguir aparecem em 303, 505 e 606~Hz e acima. É o mesmo fenômeno das imagens do \acs{dds}, causado aqui pela amostragem do instrumento.
\end{description}

\begin{figure}
	\caption{Espectros da saída da placa calculados pelo osciloscópio: (a) seno de 100~Hz, até 2,5~kHz; (b) seno de 100~Hz, até 50~MHz; (c) seno de 10~kHz amostrado a 2,5~kS/s.}
	\label{fig:bancada_fft}
	
	\legend{Fonte~---~Autoria própria.}
\end{figure}

\subsection{Distorção no cruzamento por zero}

Em 10~kHz, a saída se afasta do seno perto de cada passagem pelo código 128, com desvios de até 92~\acs{lsb}, e volta a ele logo depois (Figura~\ref{fig:bancada_cruzamento}(a)). Longe dela, o desvio médio fica abaixo de 10~\acs{lsb}. Essa distorção leva a \acs{thd} da saída a \(-17{,}3\)~dBc. Em 1~kHz, ela aparece apenas como marcas estreitas nos cruzamentos (Figura~\ref{fig:osc_ab_seno_1kHz}) e pesa pouco: a perturbação dura alguns microssegundos, e a fração do período que ela ocupa cresce com a frequência.

No mesmo seno de 10~kHz, a saída do subtrator segue o seno ajustado com desvio médio abaixo de 1~\acs{lsb} em todas as faixas de código, e a sua \acs{thd} é de \(-46{,}8\)~dBc (Figura~\ref{fig:bancada_cruzamento}(b)). No subtrator, outra distorção aparece só em 30~kHz, perto do vale do seno (Figura~\ref{fig:bancada_cruzamento}(c)). A simulação da Seção~\ref{sec:spice} não mostra nenhuma das duas; ela usa amplificadores operacionais genéricos e um modelo do DAC0800 sem picos de chaveamento próprios (Apêndice~\ref{ap:dac0800}).

\begin{figure}
	\caption{Um período do seno, com a amplitude normalizada, na saída e no subtrator.}
	\label{fig:bancada_cruzamento}
	
	\legend{Fonte~---~Autoria própria.}
\end{figure}
