nseiC/dds_waveform_generator/fpga/lut/teste_bits_1a4.txt

128
128
128
128
128
128
128
128
128
128
128
128
128
128
128
128
128
128
128
128
128
128
128
128
128
128
128
128
128
128
128
128
128
128
128
128
128
128
128
128
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
