nseiC/dds_waveform_generator/analog/resultados/AB/fft_10kHz_subamostrado/fft_10kHz_subamostrado.csv

Record Length | 1.024000e+03 | 0.00000 | -54.56910
Sample Interval | 1.233033e+00 | 1.23303 | -56.56910
Trigger Point | -0.000000000000e+00 | 2.46607 | -46.96910
 |  | 3.69910 | -53.36910
 |  | 4.93213 | -59.76910
 |  | 6.16517 | -58.96910
Source | FFT | 7.39820 | -69.76910
Vertical Units | dB | 8.63123 | -66.56910
Vertical Scale | 1.000000e+01 | 9.86427 | -73.76910
Vertical Offset | 0.000000e+00 | 11.09730 | -70.56910
Horizontal Units | Hz | 12.33033 | -64.96910
Horizontal Scale | 1.262626e+02 | 13.56337 | -66.16910
Pt Fmt | Y | 14.79640 | -80.56910
Yzero | -4.096910e+01 | 16.02943 | -70.96910
Probe Atten | 1.000000e+00 | 17.26247 | -70.16910
Model Number | TBS1102B | 18.49550 | -72.56910
Serial Number | C032210 | 19.72854 | -68.56910
Firmware Version | FV:v4.06 | 20.96157 | -70.96910
 |  | 22.19460 | -68.56910
 |  | 23.42763 | -70.56910
 |  | 24.66066 | -69.36910
 |  | 25.89369 | -67.76910
 |  | 27.12672 | -67.76910
 |  | 28.35975 | -68.16910
 |  | 29.59278 | -66.96910
 |  | 30.82581 | -70.16910
 |  | 32.05884 | -68.96910
 |  | 33.29187 | -69.36910
 |  | 34.52490 | -66.16910
 |  | 35.75793 | -66.16910
 |  | 36.99096 | -66.56910
 |  | 38.22399 | -65.76910
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
