nseiC/dds_waveform_generator/analog/resultados/AB/fft_aliasing/fft_aliasing.csv

Record Length | 1.024000e+03 | 0.00000 | -12.16910
Sample Interval | 4.882812e+04 | 48828.12500 | -62.96910
Trigger Point | -0.000000000000e+00 | 97656.25000 | -63.76910
 |  | 146484.37500 | -65.76910
 |  | 195312.50000 | -68.16910
 |  | 244140.62500 | -66.56910
Source | FFT | 292968.75000 | -77.36910
Vertical Units | dB | 341796.87500 | -74.96910
Vertical Scale | 1.000000e+01 | 390625.00000 | -73.76910
Vertical Offset | 0.000000e+00 | 439453.12500 | -80.96910
Horizontal Units | Hz | 488281.25000 | -80.96910
Horizontal Scale | 5.000000e+06 | 537109.37500 | -80.56910
Pt Fmt | Y | 585937.50000 | -77.36910
Yzero | -4.096910e+01 | 634765.62500 | -77.36910
Probe Atten | 1.000000e+00 | 683593.75000 | -76.96910
Model Number | TBS1102B | 732421.87500 | -80.56910
Serial Number | C032210 | 781250.00000 | -80.96910
Firmware Version | FV:v4.06 | 830078.12500 | -80.96910
 |  | 878906.25000 | -74.96910
 |  | 927734.37500 | -65.76910
 |  | 976562.50000 | -80.96910
 |  | 1025390.62500 | -80.96910
 |  | 1074218.75000 | -80.96910
 |  | 1123046.87500 | -80.96910
 |  | 1171875.00000 | -80.56910
 |  | 1220703.12500 | -77.36910
 |  | 1269531.25000 | -80.96910
 |  | 1318359.37500 | -73.76910
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
