nseiC/dds_waveform_generator/analog/resultados/AB/fft_pico_harmonico/fft_pico_harmonico.csv

Record Length | 1.024000e+03 | 0.00000 | -59.76910
Sample Interval | 2.466067e+00 | 2.46607 | -52.56910
Trigger Point | -0.000000000000e+00 | 4.93213 | -52.16910
 |  | 7.39820 | -52.16910
 |  | 9.86427 | -52.56910
 |  | 12.33033 | -52.56910
Source | FFT | 14.79640 | -52.56910
Vertical Units | dB | 17.26247 | -51.76910
Vertical Scale | 1.000000e+01 | 19.72854 | -51.76910
Vertical Offset | 0.000000e+00 | 22.19460 | -51.76910
Horizontal Units | Hz | 24.66067 | -51.36910
Horizontal Scale | 2.525253e+02 | 27.12674 | -50.96910
Pt Fmt | Y | 29.59280 | -51.36910
Yzero | -4.096910e+01 | 32.05887 | -51.36910
Probe Atten | 1.000000e+00 | 34.52494 | -50.96910
Model Number | TBS1102B | 36.99100 | -50.56910
Serial Number | C032210 | 39.45707 | -49.76910
Firmware Version | FV:v4.06 | 41.92314 | -49.76910
 |  | 44.38921 | -49.76910
 |  | 46.85528 | -49.36910
 |  | 49.32135 | -48.56910
 |  | 51.78742 | -48.56910
 |  | 54.25349 | -48.16910
 |  | 56.71956 | -47.36910
 |  | 59.18563 | -46.96910
 |  | 61.65170 | -46.56910
 |  | 64.11777 | -46.16910
 |  | 66.58384 | -45.36910
 |  | 69.04991 | -44.56910
 |  | 71.51598 | -43.76910
 |  | 73.98205 | -42.96910
 |  | 76.44812 | -42.16910
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
