nseiC/dds_waveform_generator/analog/resultados/AB/seno_100Hz/seno_100Hz.csv

Record Length | 2.500000e+03 | -0.012700000000 | -0.25600
Sample Interval | 1.000000e-05 | -0.012690000000 | -0.25200
Trigger Point | 1.270000000000e+03 | -0.012680000000 | -0.25200
 |  | -0.012670000000 | -0.25200
 |  | -0.012660000000 | -0.24400
 |  | -0.012650000000 | -0.24400
Source | CH1 | -0.012640000000 | -0.24800
Vertical Units | V | -0.012630000000 | -0.24400
Vertical Scale | 1.000000e-01 | -0.012620000000 | -0.24000
Vertical Offset | -4.000000e-03 | -0.012610000000 | -0.24400
Horizontal Units | s | -0.012600000000 | -0.24000
Horizontal Scale | 2.500000e-03 | -0.012590000000 | -0.24400
Pt Fmt | Y | -0.012580000000 | -0.23600
Yzero | 0.000000e+00 | -0.012570000000 | -0.23600
Probe Atten | 1.000000e+00 | -0.012560000000 | -0.23600
Model Number | TBS1102B | -0.012550000000 | -0.23600
Serial Number | C032210 | -0.012540000000 | -0.22400
Firmware Version | FV:v4.06 | -0.012530000000 | -0.22800
 |  | -00.012520000000 | -0.23200
 |  | -00.012510000000 | -0.22800
 |  | -00.012500000000 | -0.22400
 |  | -00.012490000000 | -0.22400
 |  | -00.012480000000 | -0.22000
 |  | -00.012470000000 | -0.21200
 |  | -00.012460000000 | -0.21600
 |  | -00.012450000000 | -0.21600
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
