nseiC/dds_waveform_generator/analog/resultados/AB/seno_10Hz/seno_10Hz.csv

Record Length | 2.500000e+03 | -0.125200000000 | -0.12400
Sample Interval | 1.000000e-04 | -0.125100000000 | -0.12400
Trigger Point | 1.252000000000e+03 | -0.125000000000 | -0.12400
 |  | -0.124900000000 | -0.12000
 |  | -0.124800000000 | -0.11600
 |  | -0.124700000000 | -0.11600
Source | CH1 | -0.124600000000 | -0.11200
Vertical Units | V | -0.124500000000 | -0.11600
Vertical Scale | 1.000000e-01 | -0.124400000000 | -0.10800
Vertical Offset | -4.000000e-03 | -0.124300000000 | -0.10800
Horizontal Units | s | -0.124200000000 | -0.10800
Horizontal Scale | 2.500000e-02 | -0.124100000000 | -0.10400
Pt Fmt | Y | -0.124000000000 | -0.10000
Yzero | 0.000000e+00 | -0.123900000000 | -0.10400
Probe Atten | 1.000000e+00 | -0.123800000000 | -0.10400
Model Number | TBS1102B | -0.123700000000 | -0.09600
Serial Number | C032210 | -0.123600000000 | -0.09600
Firmware Version | FV:v4.06 | -0.123500000000 | -0.09200
 |  | -00.123400000000 | -0.09600
 |  | -00.123300000000 | -0.09600
 |  | -00.123200000000 | -0.09200
 |  | -00.123100000000 | -0.08800
 |  | -00.123000000000 | -0.08400
 |  | -00.122900000000 | -0.08400
 |  | -00.122800000000 | -0.08400
 |  | -00.122700000000 | -0.08400
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
