nseiC/dds_waveform_generator/analog/resultados/AB/seno_10kHz/seno_10kHz.csv

Record Length | 2.500000e+03 | -0.000450000000 | -0.24000
Sample Interval | 2.000000e-07 | -0.000449800000 | -0.24400
Trigger Point | 2.250000000000e+03 | -0.000449600000 | -0.24800
 |  | -0.000449400000 | -0.24400
 |  | -0.000449200000 | -0.24800
 |  | -0.000449000000 | -0.26000
Source | CH1 | -0.000448800000 | -0.25600
Vertical Units | V | -0.000448600000 | -0.26000
Vertical Scale | 1.000000e-01 | -0.000448400000 | -0.26000
Vertical Offset | -4.000000e-03 | -0.000448200000 | -0.26000
Horizontal Units | s | -0.000448000000 | -0.26000
Horizontal Scale | 5.000000e-05 | -0.000447800000 | -0.26800
Pt Fmt | Y | -0.000447600000 | -0.26800
Yzero | 0.000000e+00 | -0.000447400000 | -0.26800
Probe Atten | 1.000000e+00 | -0.000447200000 | -0.28000
Model Number | TBS1102B | -0.000447000000 | -0.28000
Serial Number | C032210 | -0.000446800000 | -0.28000
Firmware Version | FV:v4.06 | -0.000446600000 | -0.29200
 |  | -00.000446400000 | -0.28800
 |  | -00.000446200000 | -0.29200
 |  | -00.000446000000 | -0.29200
 |  | -00.000445800000 | -0.29600
 |  | -00.000445600000 | -0.28400
 |  | -00.000445400000 | -0.28800
 |  | -00.000445200000 | -0.30000
 |  | -00.000445000000 | -0.29600
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
