nseiC/dds_waveform_generator/analog/resultados/AB/seno_1kHz/seno_1kHz.csv

Record Length | 2.500000e+03 | -0.002700000000 | 0.13200
Sample Interval | 2.000000e-06 | -0.002698000000 | 0.13200
Trigger Point | 1.350000000000e+03 | -0.002696000000 | 0.13200
 |  | -0.002694000000 | 0.13200
 |  | -0.002692000000 | 0.12400
 |  | -0.002690000000 | 0.12400
Source | CH1 | -0.002688000000 | 0.11200
Vertical Units | V | -0.002686000000 | 0.10800
Vertical Scale | 1.000000e-01 | -0.002684000000 | 0.10800
Vertical Offset | -4.000000e-03 | -0.002682000000 | 0.10000
Horizontal Units | s | -0.002680000000 | 0.09600
Horizontal Scale | 5.000000e-04 | -0.002678000000 | 0.09200
Pt Fmt | Y | -0.002676000000 | 0.08800
Yzero | 0.000000e+00 | -0.002674000000 | 0.08800
Probe Atten | 1.000000e+00 | -0.002672000000 | 0.08400
Model Number | TBS1102B | -0.002670000000 | 0.07600
Serial Number | C032210 | -0.002668000000 | 0.07200
Firmware Version | FV:v4.06 | -0.002666000000 | 0.07200
 |  | -00.002664000000 | 0.06400
 |  | -00.002662000000 | 0.06000
 |  | -00.002660000000 | 0.05600
 |  | -00.002658000000 | 0.05200
 |  | -00.002656000000 | 0.04800
 |  | -00.002654000000 | 0.04800
 |  | -00.002652000000 | 0.04000
 |  | -00.002650000000 | 0.04000
 |  | -00.002648000000 | 0.04000
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
