nseiC/dds_waveform_generator/analog/resultados/AB/sinc_100Hz/sinc_100Hz.csv

Record Length | 2.500000e+03 | -0.012700000000 | 0.00000
Sample Interval | 1.000000e-05 | -0.012690000000 | 0.00400
Trigger Point | 1.270000000000e+03 | -0.012680000000 | 0.00800
 |  | -0.012670000000 | 0.00800
 |  | -0.012660000000 | 0.00800
 |  | -0.012650000000 | 0.00400
Source | CH1 | -0.012640000000 | 0.00800
Vertical Units | V | -0.012630000000 | 0.00800
Vertical Scale | 1.000000e-01 | -0.012620000000 | 0.00000
Vertical Offset | -4.000000e-03 | -0.012610000000 | 0.00800
Horizontal Units | s | -0.012600000000 | 0.00400
Horizontal Scale | 2.500000e-03 | -0.012590000000 | 0.00800
Pt Fmt | Y | -0.012580000000 | 0.00400
Yzero | 0.000000e+00 | -0.012570000000 | 0.00800
Probe Atten | 1.000000e+00 | -0.012560000000 | 0.00800
Model Number | TBS1102B | -0.012550000000 | 0.00800
Serial Number | C032210 | -0.012540000000 | 0.01200
Firmware Version | FV:v4.06 | -0.012530000000 | 0.00000
 |  | -00.012520000000 | 0.01200
 |  | -00.012510000000 | 0.00400
 |  | -00.012500000000 | 0.00400
 |  | -00.012490000000 | 0.00800
 |  | -00.012480000000 | 0.00000
 |  | -00.012470000000 | 0.00400
 |  | -00.012460000000 | 0.00400
 |  | -00.012450000000 | 0.00000
 |  | -00.012440000000 | 0.00000
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
