nseiC/dds_waveform_generator/analog/resultados/subtrator/seno_10kHz/seno_10kHz.csv

Record Length | 2.500000e+03 | -0.000450000000 | -0.24000
Sample Interval | 2.000000e-07 | -0.000449800000 | -0.26000
Trigger Point | 2.250000000000e+03 | -0.000449600000 | -0.28000
 |  | -0.000449400000 | -0.32000
 |  | -0.000449200000 | -0.32000
 |  | -0.000449000000 | -0.34000
Source | CH1 | -0.000448800000 | -0.34000
Vertical Units | V | -0.000448600000 | -0.34000
Vertical Scale | 5.000000e-01 | -0.000448400000 | -0.38000
Vertical Offset | -2.000000e-02 | -0.000448200000 | -0.40000
Horizontal Units | s | -0.000448000000 | -0.38000
Horizontal Scale | 5.000000e-05 | -0.000447800000 | -0.38000
Pt Fmt | Y | -0.000447600000 | -0.42000
Yzero | 0.000000e+00 | -0.000447400000 | -0.42000
Probe Atten | 1.000000e+00 | -0.000447200000 | -0.44000
Model Number | TBS1102B | -0.000447000000 | -0.44000
Serial Number | C032210 | -0.000446800000 | -0.48000
Firmware Version | FV:v4.06 | -0.000446600000 | -0.48000
 |  | -00.000446400000 | -0.50000
 |  | -00.000446200000 | -0.52000
 |  | -00.000446000000 | -0.52000
 |  | -00.000445800000 | -0.52000
 |  | -00.000445600000 | -0.54000
 |  | -00.000445400000 | -0.52000
 |  | -00.000445200000 | -0.54000
 |  | -00.000445000000 | -0.60000
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
