nseiC/dds_waveform_generator/analog/resultados/subtrator/seno_30kHz/seno_30kHz.csv

Record Length | 2.500000e+03 | -0.000225000000 | 1.00000
Sample Interval | 1.000000e-07 | -0.000224900000 | 1.00000
Trigger Point | 2.250000000000e+03 | -0.000224800000 | 1.02000
 |  | -0.000224700000 | 1.00000
 |  | -0.000224600000 | 0.96000
 |  | -0.000224500000 | 1.00000
Source | CH1 | -0.000224400000 | 0.96000
Vertical Units | V | -0.000224300000 | 0.98000
Vertical Scale | 5.000000e-01 | -0.000224200000 | 0.98000
Vertical Offset | -2.000000e-02 | -0.000224100000 | 0.98000
Horizontal Units | s | -0.000224000000 | 0.96000
Horizontal Scale | 2.500000e-05 | -0.000223900000 | 0.94000
Pt Fmt | Y | -0.000223800000 | 0.94000
Yzero | 0.000000e+00 | -0.000223700000 | 0.96000
Probe Atten | 1.000000e+00 | -0.000223600000 | 0.92000
Model Number | TBS1102B | -0.000223500000 | 0.92000
Serial Number | C032210 | -0.000223400000 | 0.92000
Firmware Version | FV:v4.06 | -0.000223300000 | 0.90000
 |  | -00.000223200000 | 0.84000
 |  | -00.000223100000 | 0.86000
 |  | -00.000223000000 | 0.86000
 |  | -00.000222900000 | 0.86000
 |  | -00.000222800000 | 0.84000
 |  | -00.000222700000 | 0.82000
 |  | -00.000222600000 | 0.84000
 |  | -00.000222500000 | 0.80000
 |  | -00.000222400000 | 0.80000
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
