nseiC/dds_waveform_generator/fpga/testbenches/figuras/tb_cmd_sync.png

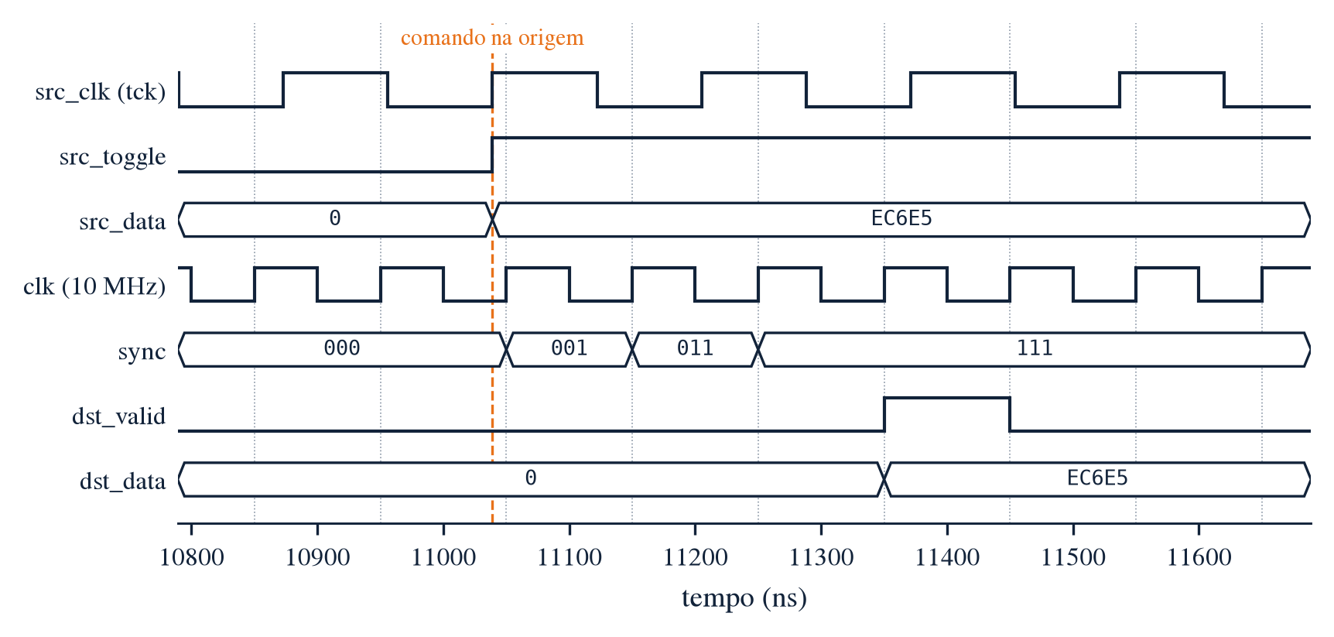
fpga/testbenches/figuras/tb_cmd_sync.png
