nseiC/dds_waveform_generator/fpga/testbenches/figuras/tb_control_registers.png

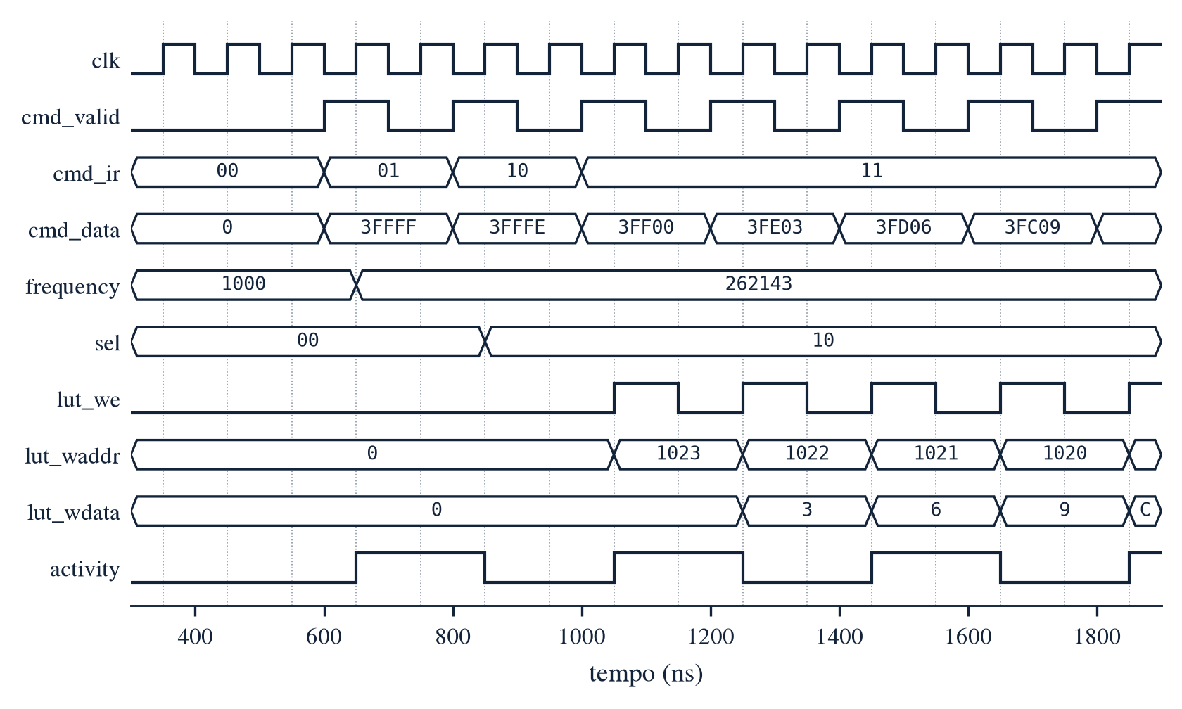
fpga/testbenches/figuras/tb_control_registers.png
