nseiC/dds_waveform_generator/fpga/testbenches/figuras/tb_dds_core_latencia.png

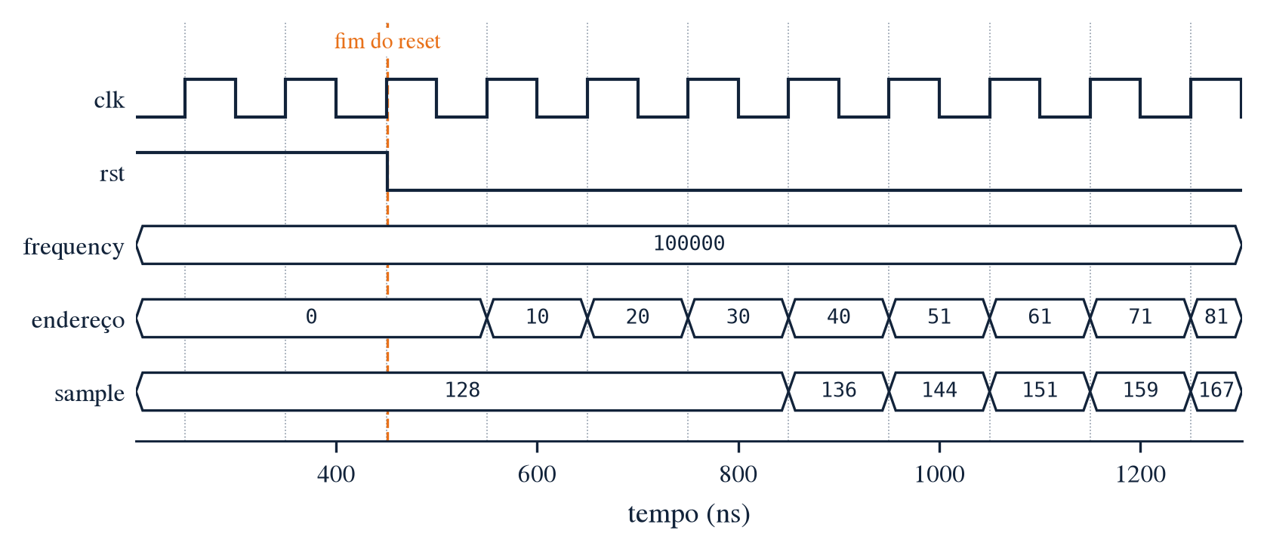
fpga/testbenches/figuras/tb_dds_core_latencia.png
