nseiC/dds_waveform_generator/fpga/testbenches/figuras/tb_DDS_pll.png

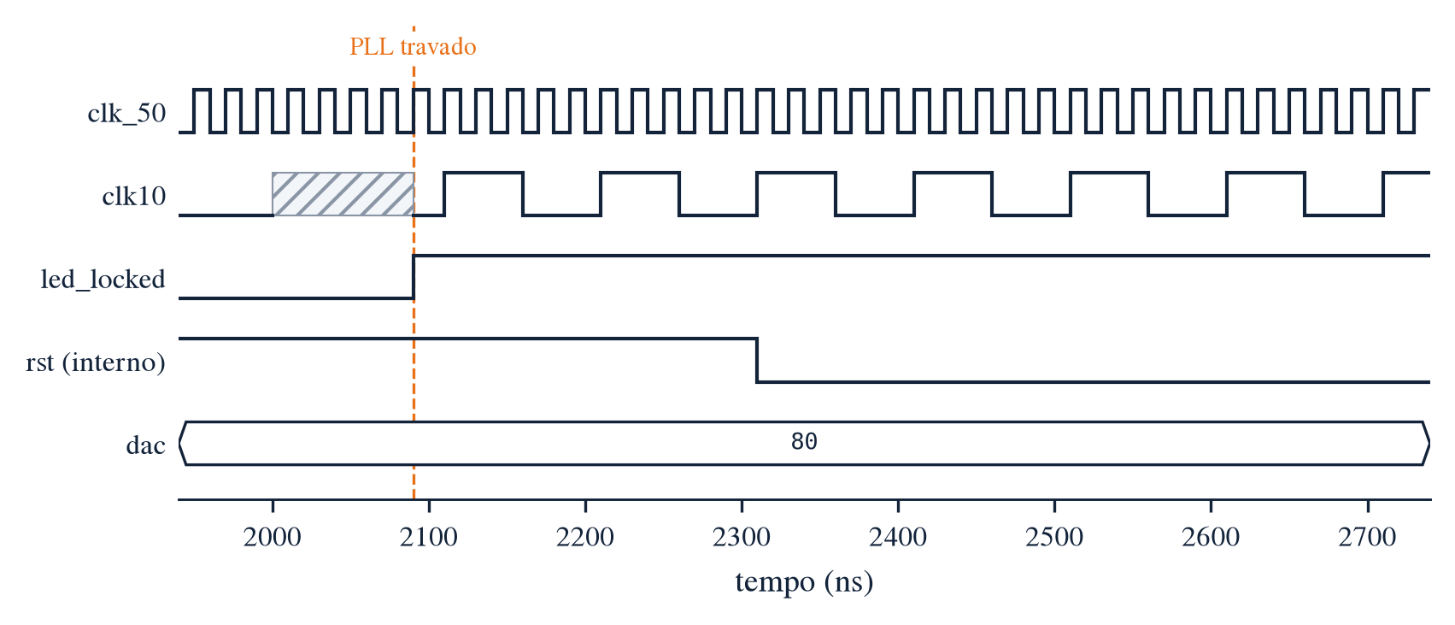
fpga/testbenches/figuras/tb_DDS_pll.png
