nseiC/dds_waveform_generator/fpga/testbenches/figuras/tb_DDS_saida.png

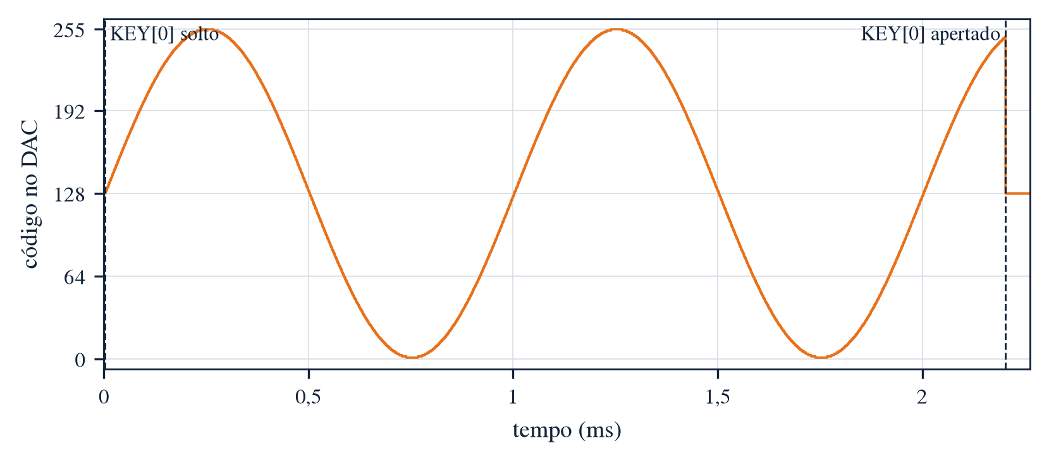
fpga/testbenches/figuras/tb_DDS_saida.png
