nseiC/dds_waveform_generator/fpga/testbenches/figuras/tb_frequency_translator.png

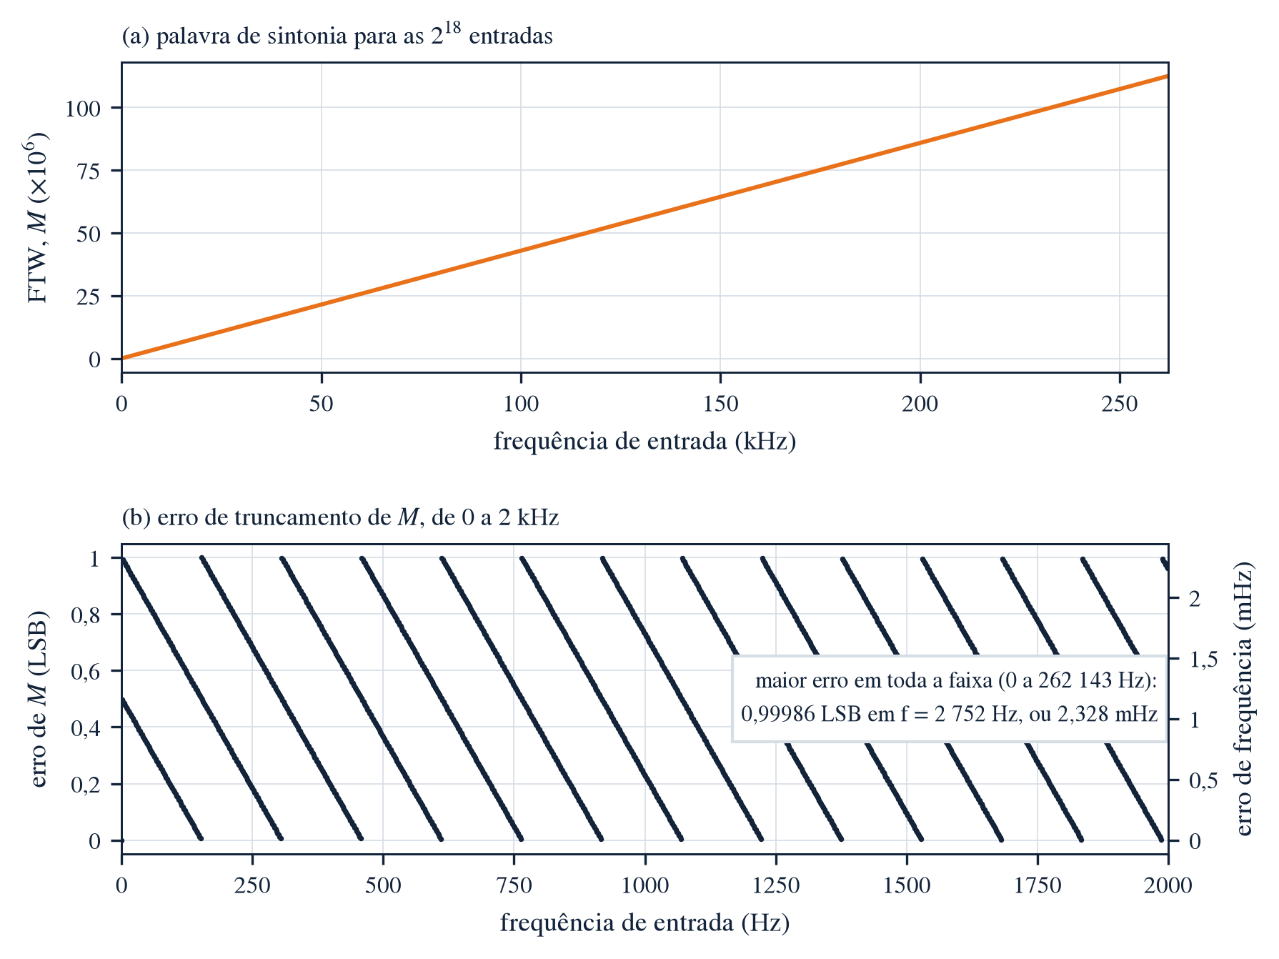
fpga/testbenches/figuras/tb_frequency_translator.png
