nseiC/dds_waveform_generator/fpga/testbenches/figuras/tb_jtag_control.png

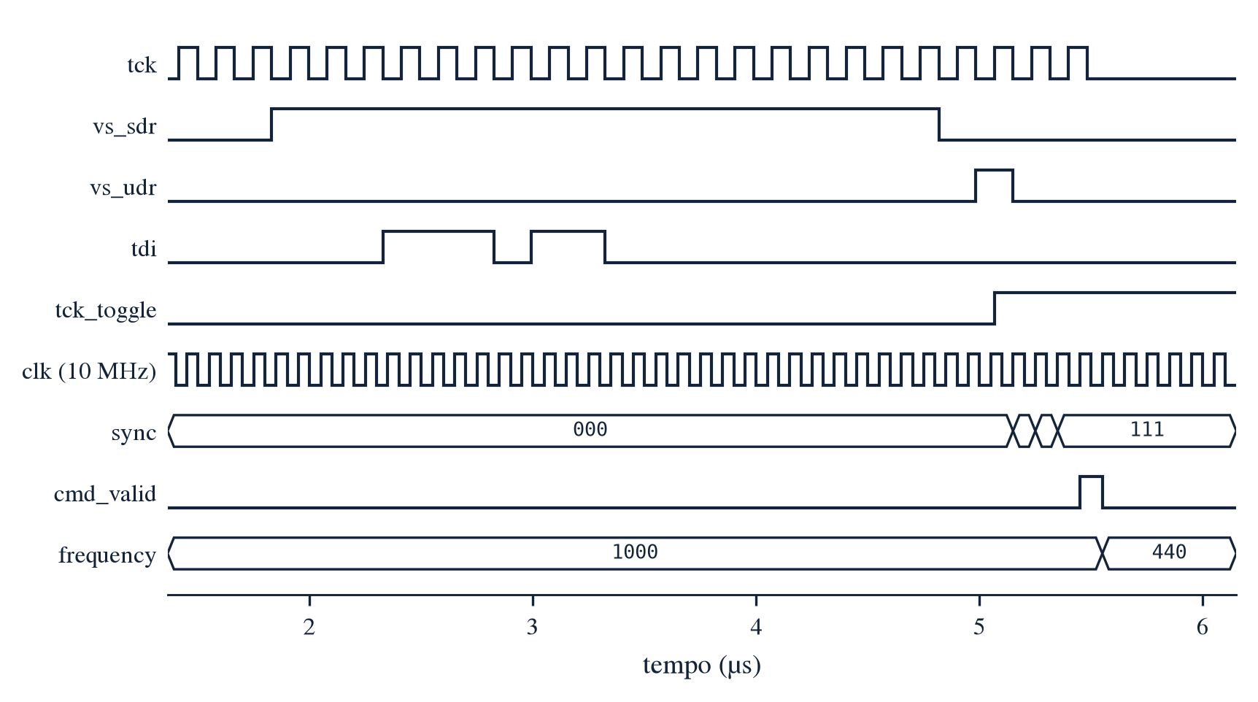
fpga/testbenches/figuras/tb_jtag_control.png
