nseiC/dds_waveform_generator/fpga/testbenches/figuras/tb_LUT_latencia.png

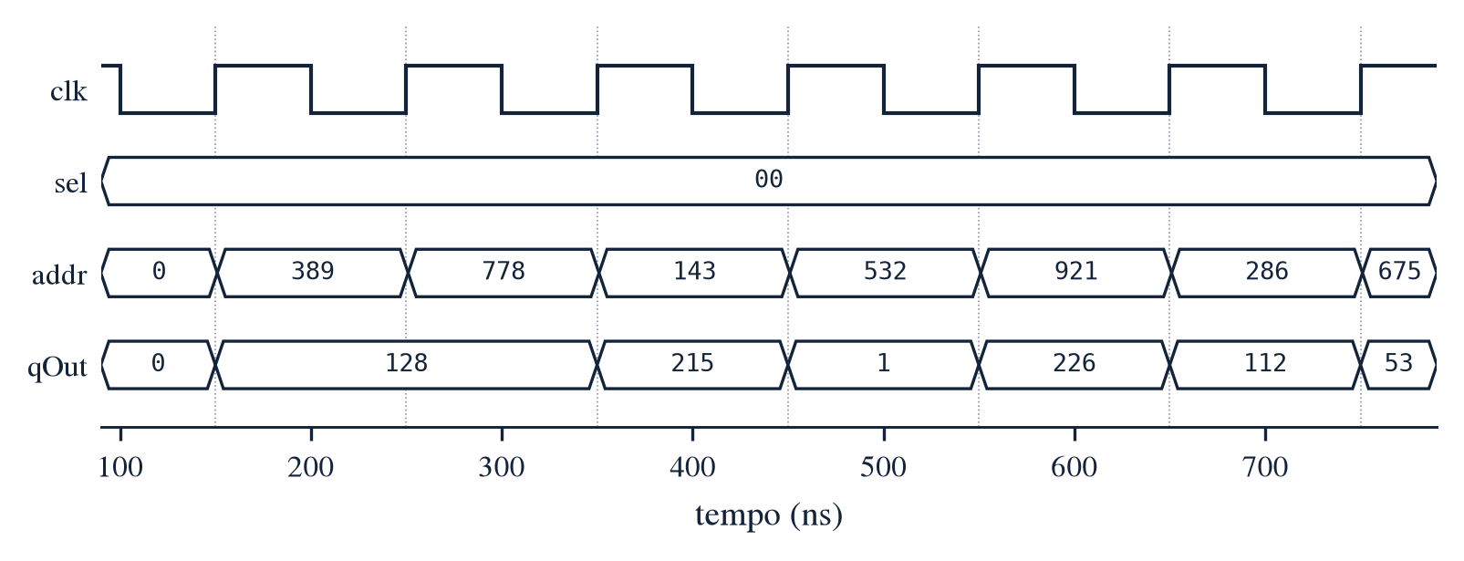
fpga/testbenches/figuras/tb_LUT_latencia.png
