nseiC/dds_waveform_generator/fpga/testbenches/figuras/tb_LUT_tabelas.png

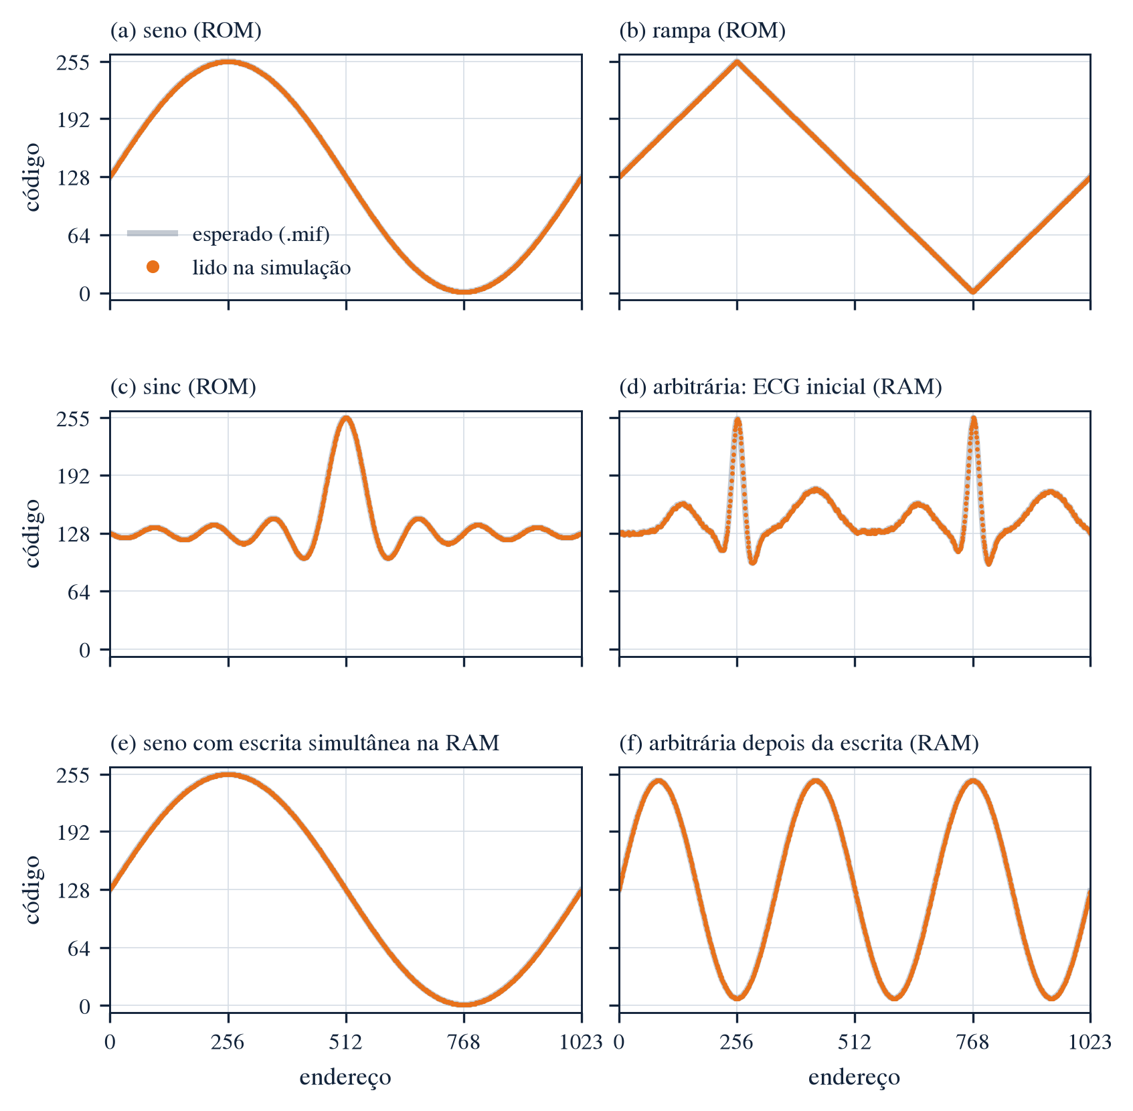
fpga/testbenches/figuras/tb_LUT_tabelas.png
