nseiC/dds_waveform_generator/fpga/testbenches/figuras/tb_out_mux.png

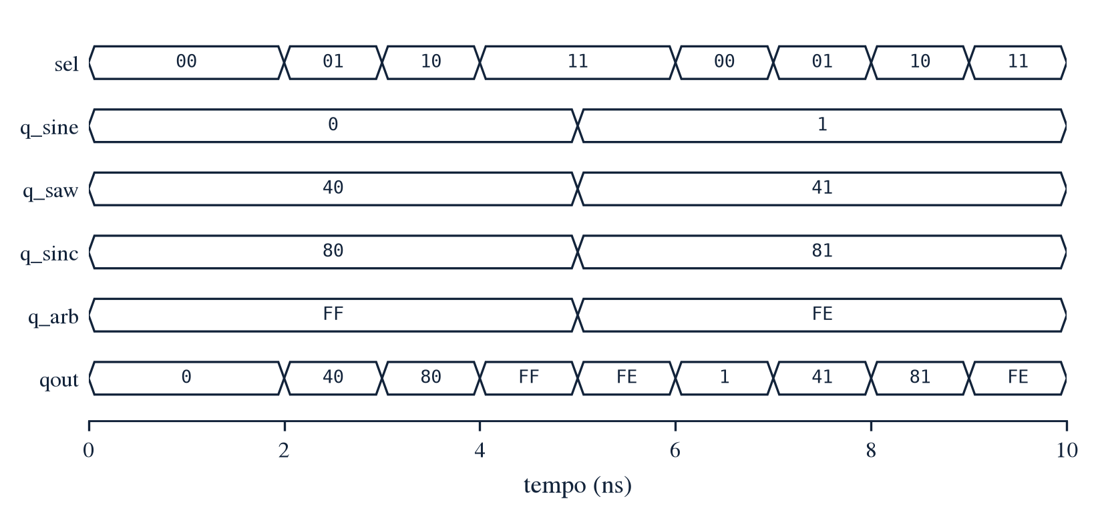
fpga/testbenches/figuras/tb_out_mux.png
