nseiC/dds_waveform_generator/fpga/testbenches/figuras/tb_output_register.png

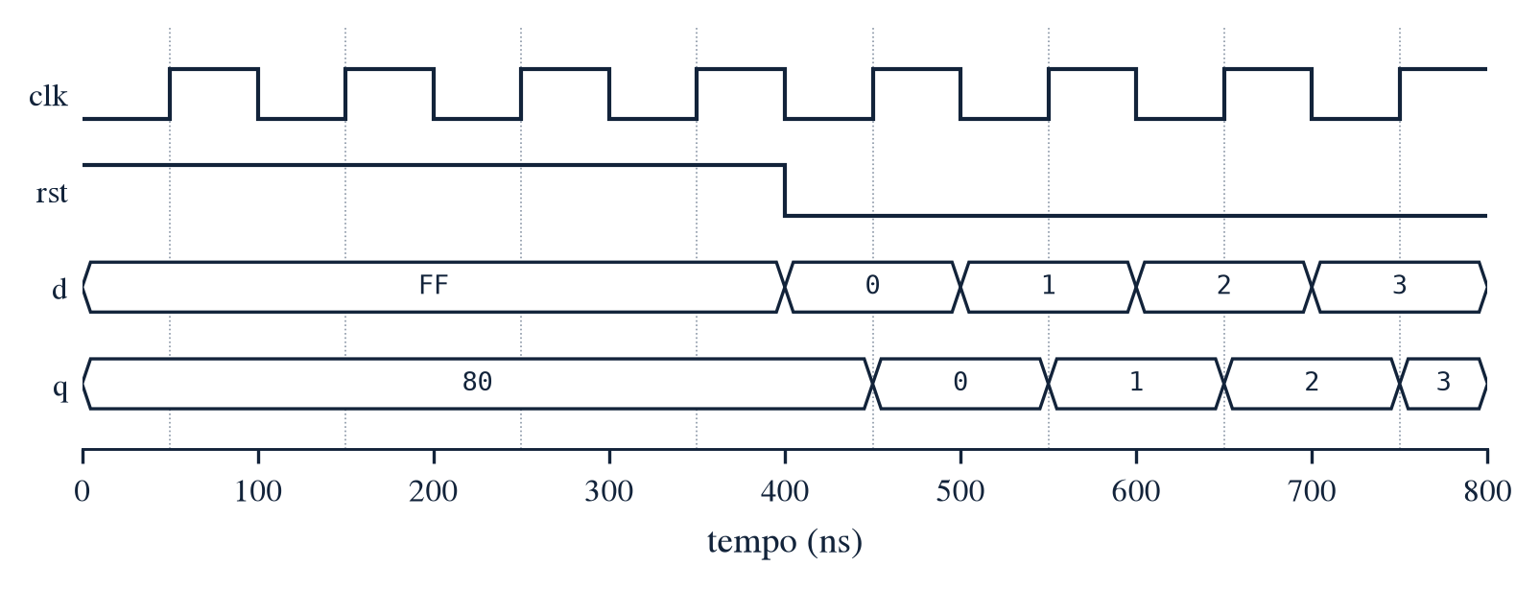
fpga/testbenches/figuras/tb_output_register.png
