nseiC/dds_waveform_generator/fpga/testbenches/figuras/tb_phase_accumulator.png

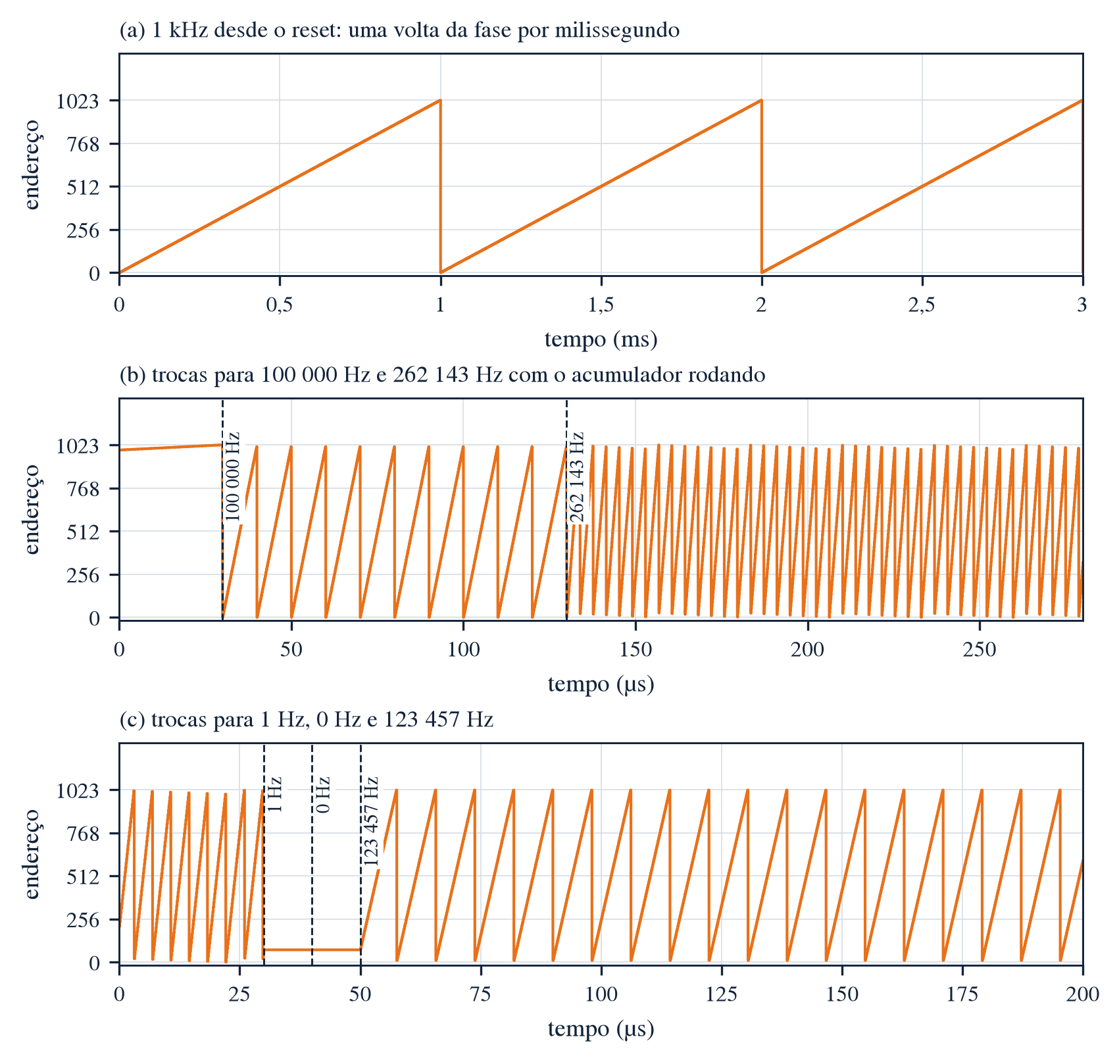
fpga/testbenches/figuras/tb_phase_accumulator.png
