nseiC/dds_waveform_generator/fpga/testbenches/figuras/tb_phase_register.png

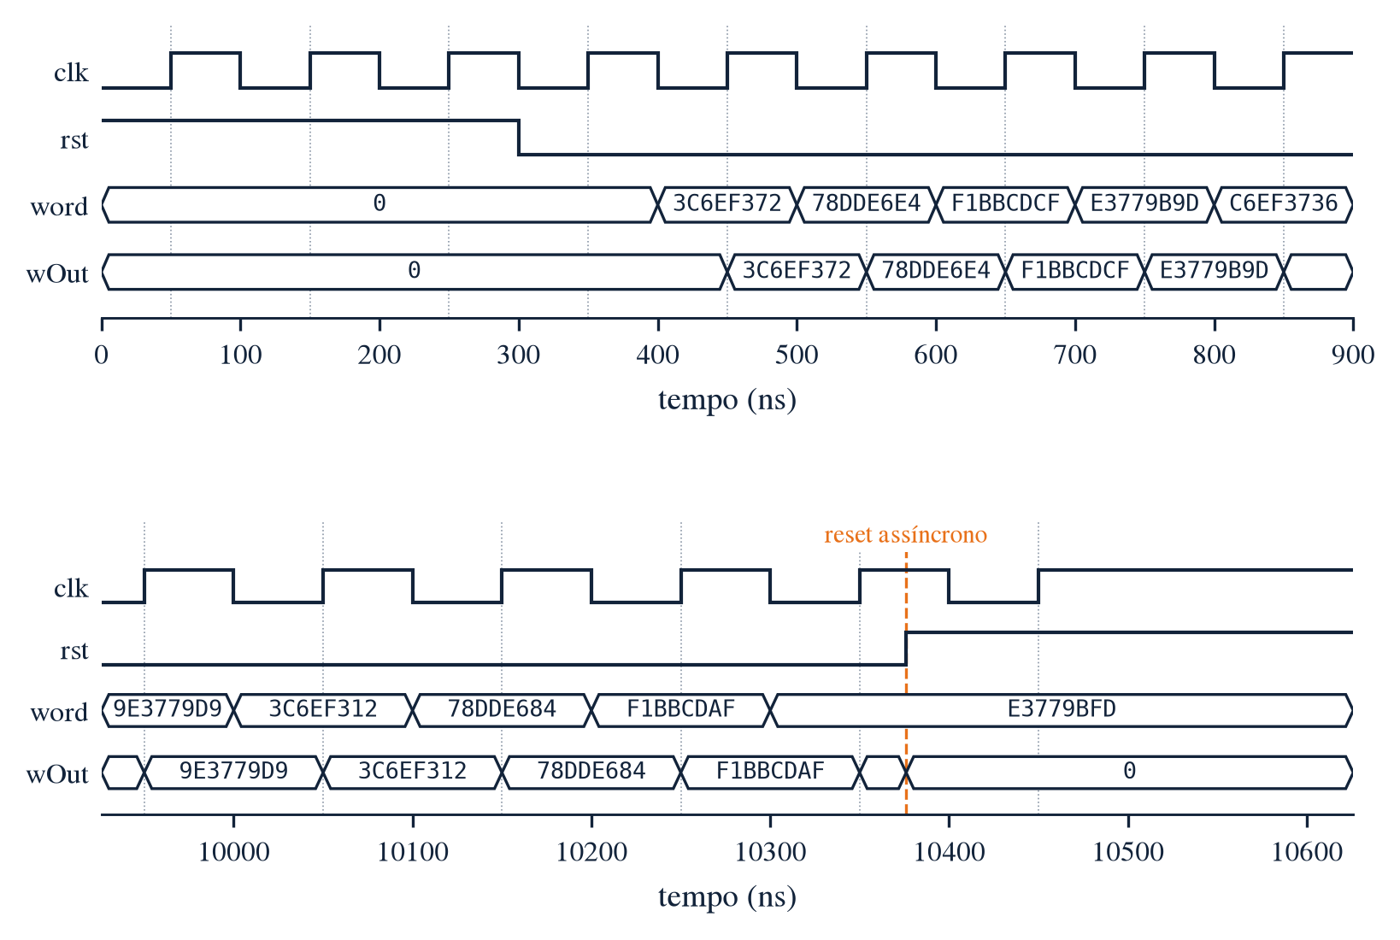
fpga/testbenches/figuras/tb_phase_register.png
