nseiC/dds_waveform_generator/fpga/testbenches/figuras/tb_reset_sync.png

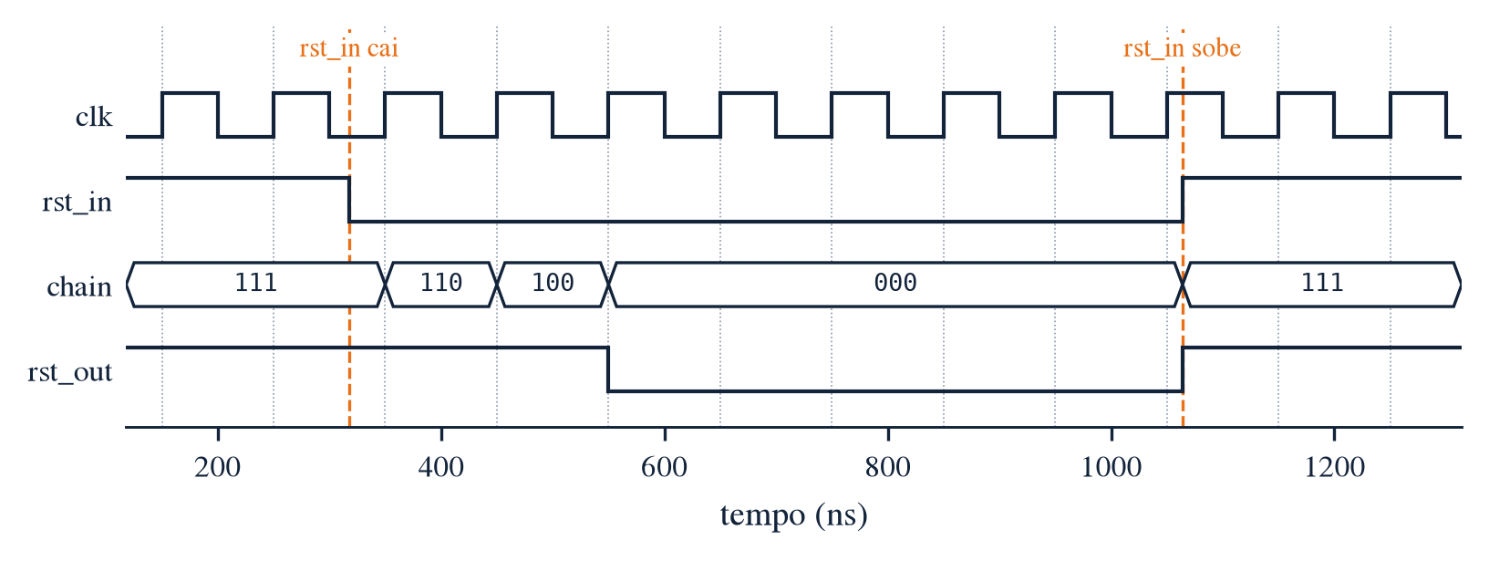
fpga/testbenches/figuras/tb_reset_sync.png
