nseiC/dds_waveform_generator/fpga/testbenches/figuras/tb_system_detalhes.png

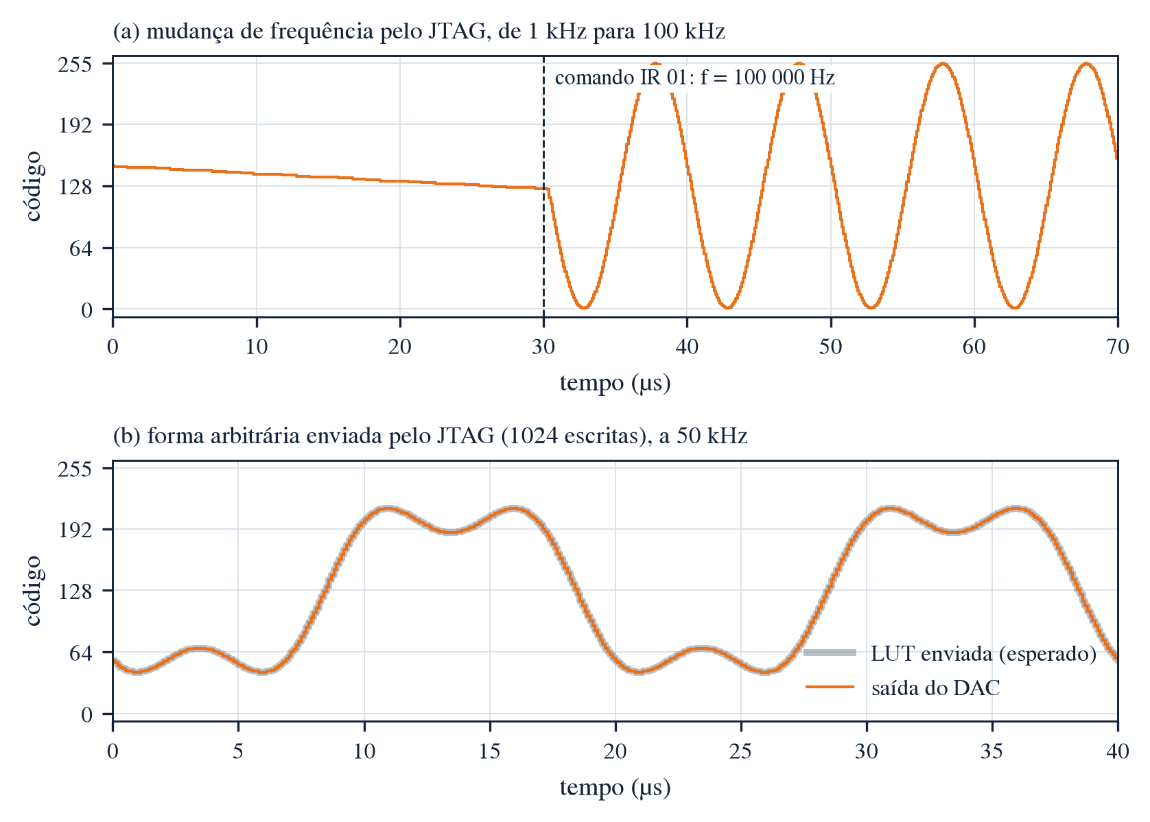
fpga/testbenches/figuras/tb_system_detalhes.png
