nseiC/dds_waveform_generator/fpga/testbenches/figuras/tb_system_visao_geral.png

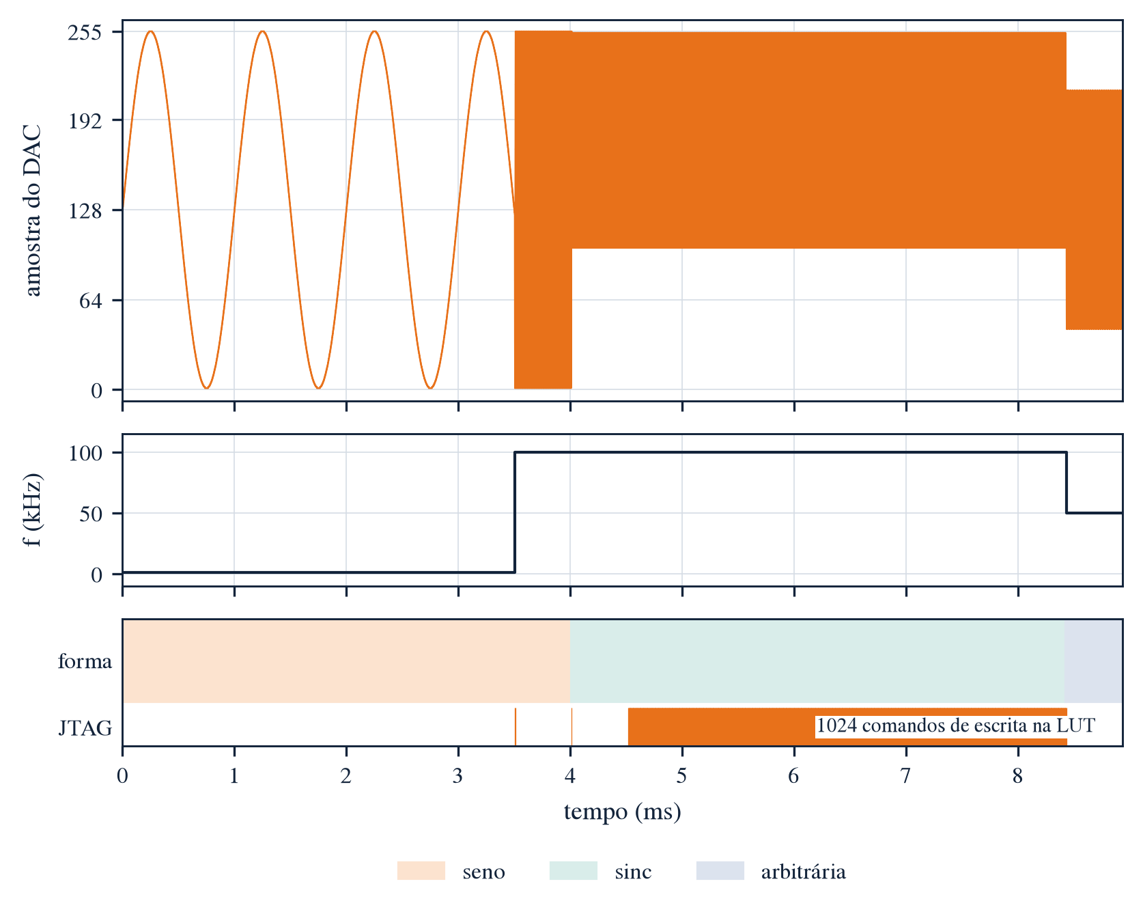
fpga/testbenches/figuras/tb_system_visao_geral.png
