nseiC/dds_waveform_generator/fpga/testbenches/figuras/tb_truncator.png

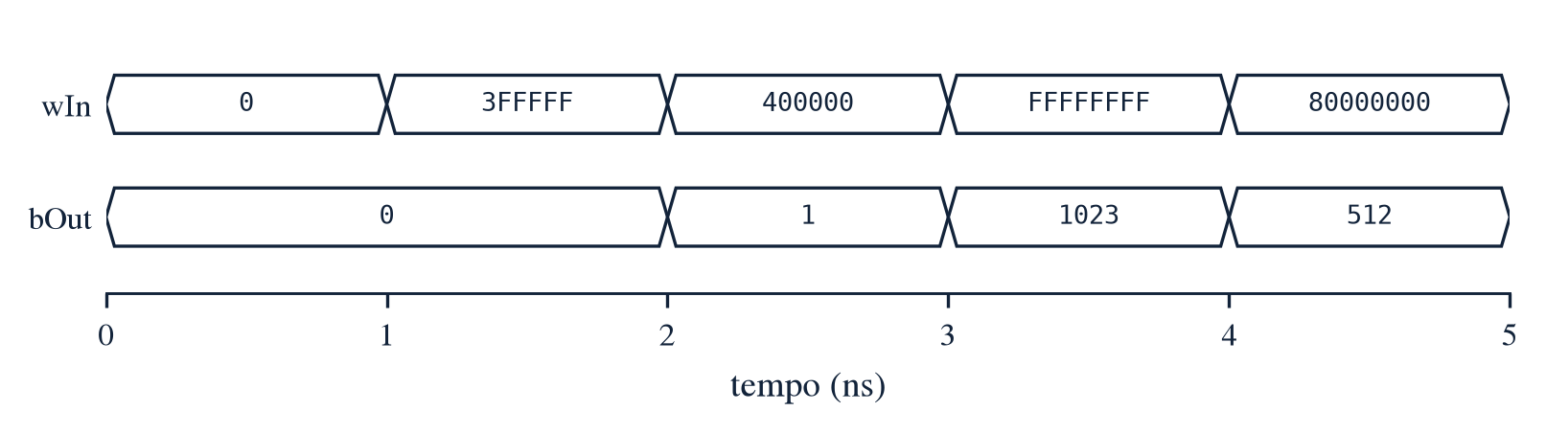
fpga/testbenches/figuras/tb_truncator.png
