nseiC/dds_waveform_generator/fpga/testbenches/figuras/tb_word_adder.png

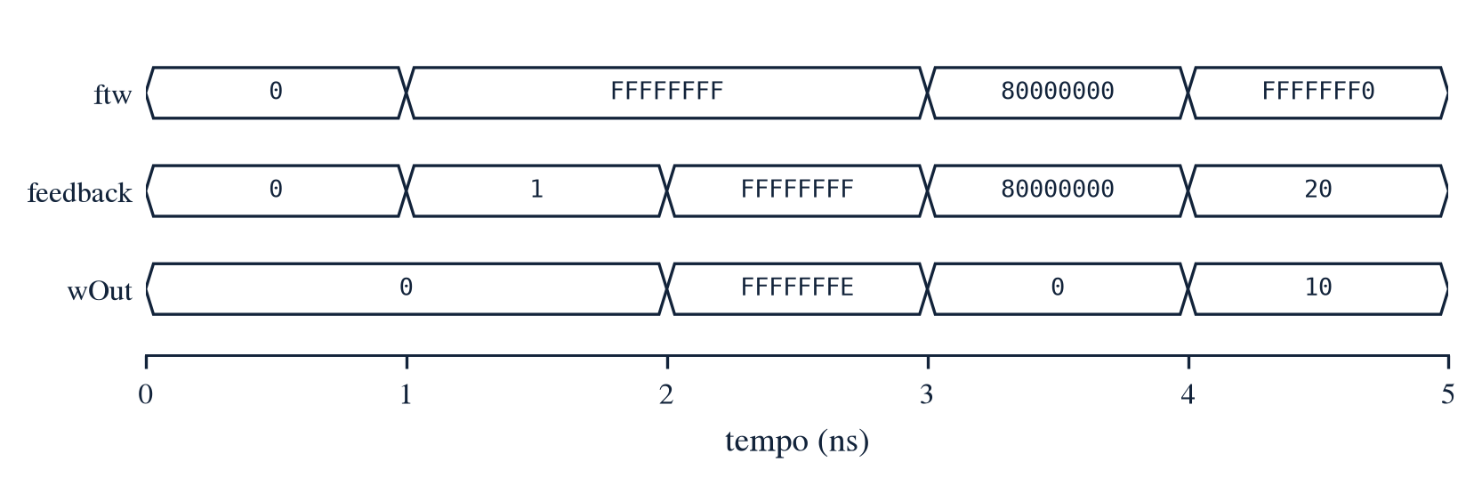
fpga/testbenches/figuras/tb_word_adder.png
