nseiC/dds_waveform_generator/fpga/testbenches/rtl/rtl_virtual_jtag_ip.png

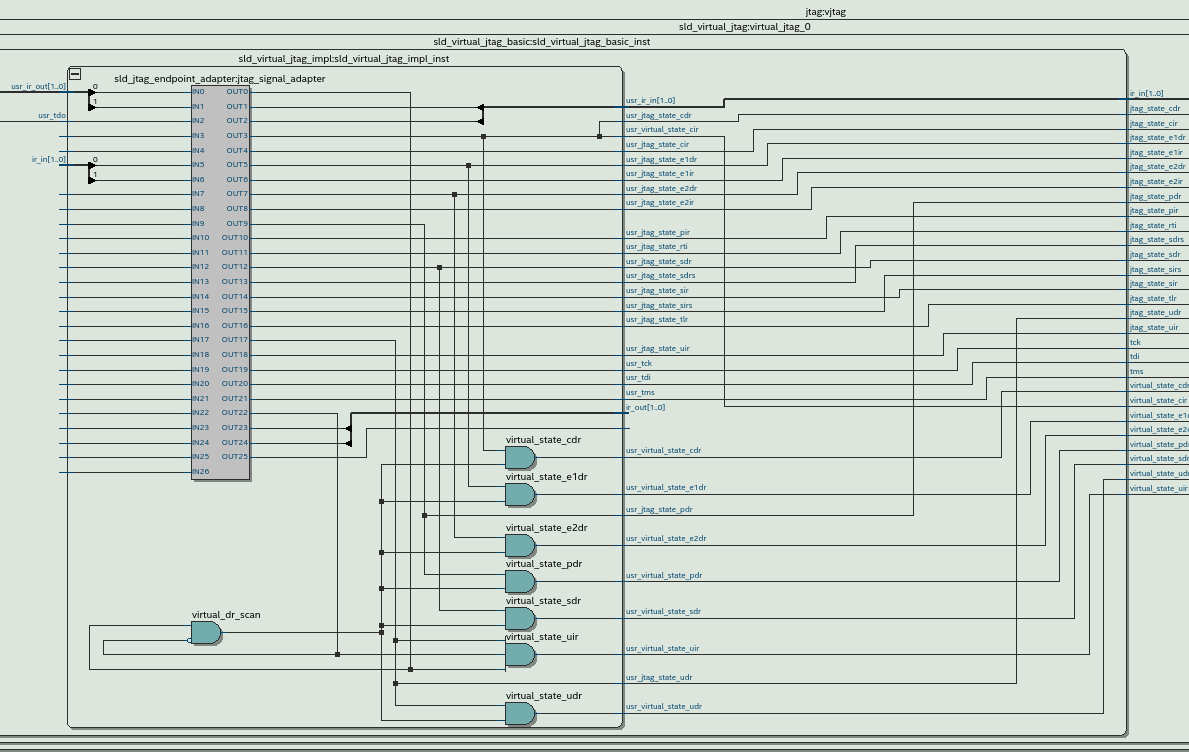
fpga/testbenches/rtl/rtl_virtual_jtag_ip.png
