nseiC/dds_waveform_generator/overleaf/figuras/modelo_dac0800.pdf

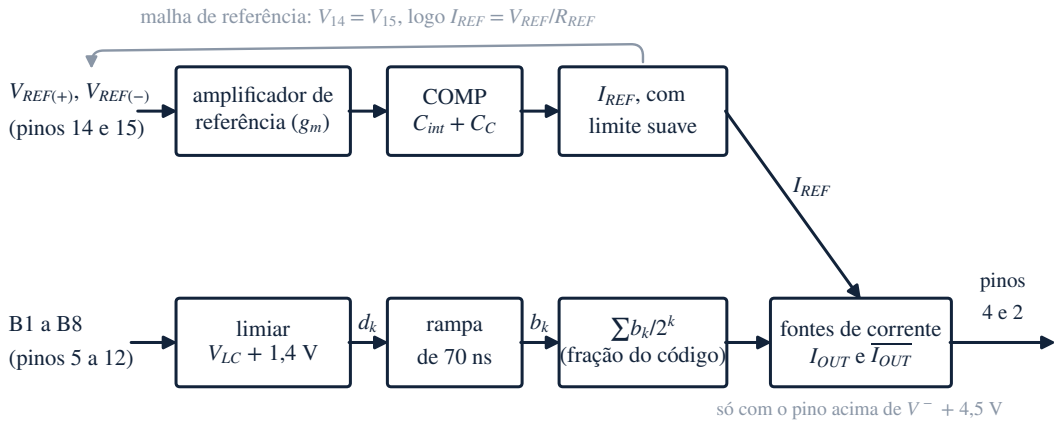
[picture p85: page 1]
VREF(+); , VREF(−) (pinos 14 e 15); amplificador de referência (gm); COMP Cint + CC; IREF, com limite suave; B1 a B8 (pinos 5 a 12); limiar VLC + 1,4 V; rampa de 70 ns; k (fração do código); IREF; pinos 4 e 2

malha de referência: V14 = V15, logo IREF = VREF/RREF

fontes de corrente
IOUT e IOUT

só com o pino acima de V
