nseiC/dds_waveform_generator/overleaf/figuras/relogio_fase.pdf

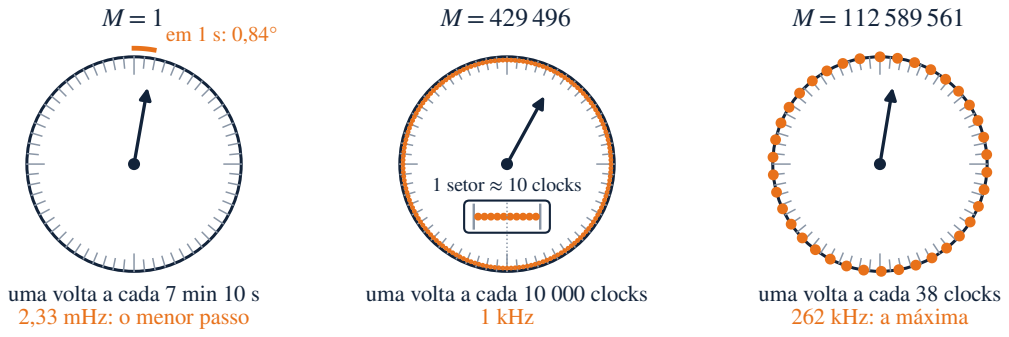
[picture p86: page 1]
1 setor ≈ 10 clocks; 1 kHz

uma volta a cada 7 min 10 s
2,33 mHz: o menor passo

uma volta a cada 10 000 clocks

uma volta a cada 38 clocks
262 kHz: a máxima
