nseiC/dds_waveform_generator/overleaf/figuras/bancada_fft.pdf

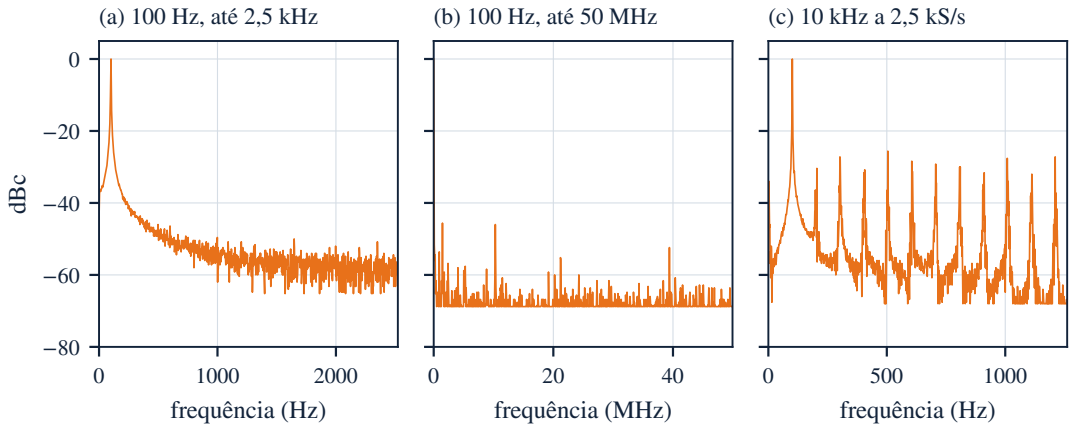
[picture p87: page 1]
frequência (Hz); dBc; frequência (MHz); (c) 10 kHz a 2,5 kS/s

(a) 100 Hz, até 2,5 kHz

(b) 100 Hz, até 50 MHz
