nseiC/dds_waveform_generator/overleaf/figuras/tb_dds_core_formas.pdf

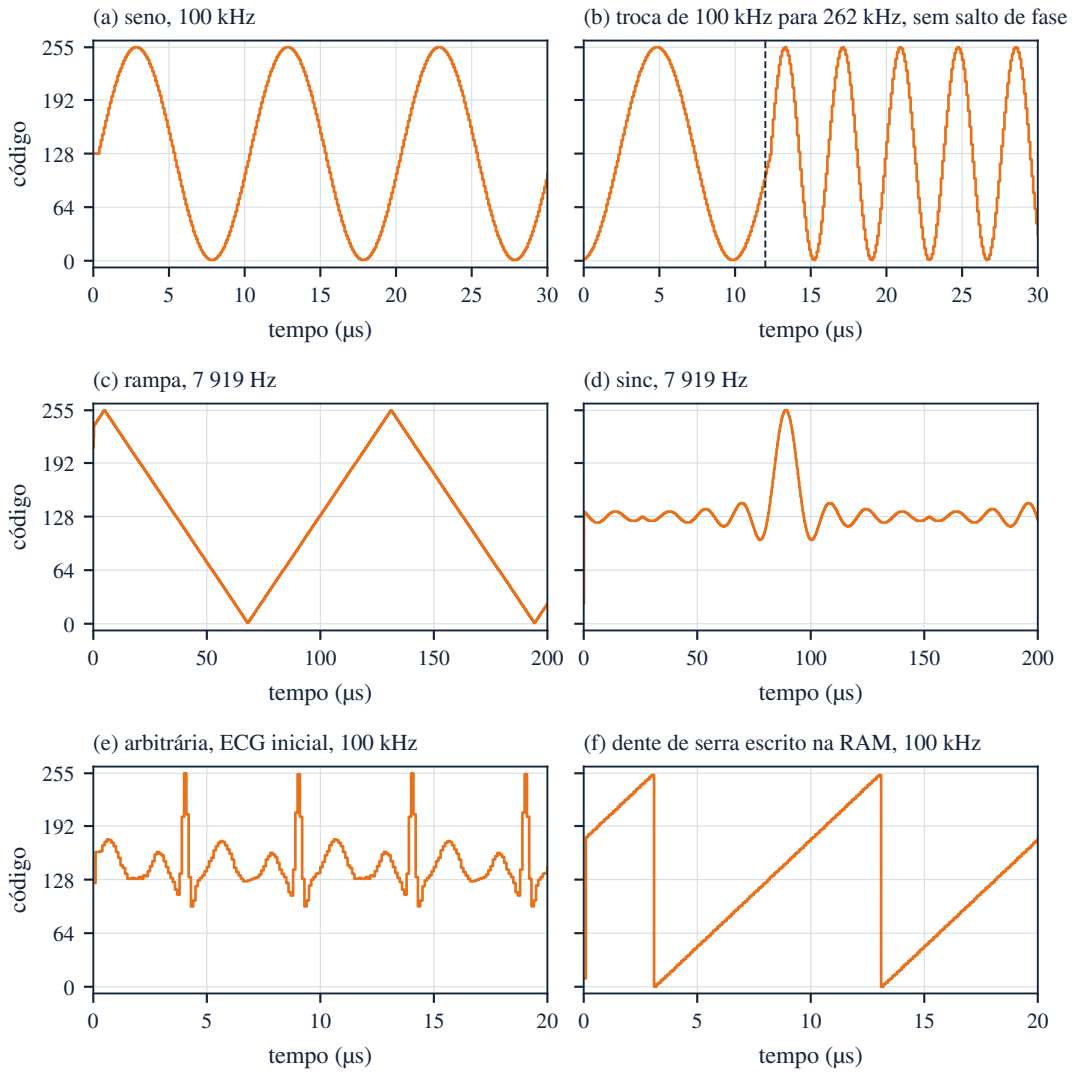
[picture p88: page 1]
tempo (µs); código; (a) seno, 100 kHz; (c) rampa, 7 919 Hz; (d) sinc, 7 919 Hz; (e) arbitrária, ECG inicial, 100 kHz

(b) troca de 100 kHz para 262 kHz, sem salto de fase

(f) dente de serra escrito na RAM, 100 kHz
