nseiC/dds_waveform_generator/overleaf/figuras/tb_system_detalhes.pdf

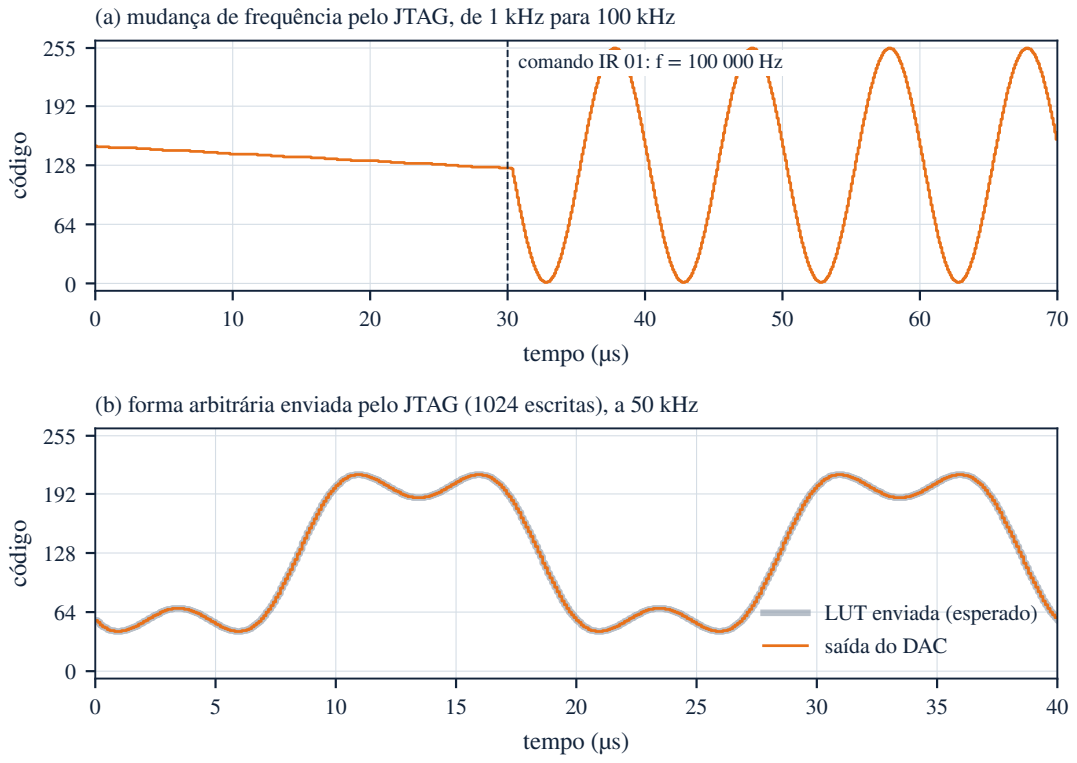
[picture p89: page 1]
tempo (µs); código; (b) forma arbitrária enviada pelo JTAG (1024 escritas), a 50 kHz

(a) mudança de frequência pelo JTAG, de 1 kHz para 100 kHz

comando IR 01: f = 100 000 Hz

LUT enviada (esperado)
saída do DAC
