nseiC/dds_waveform_generator/overleaf/figuras/bancada_cruzamento.pdf

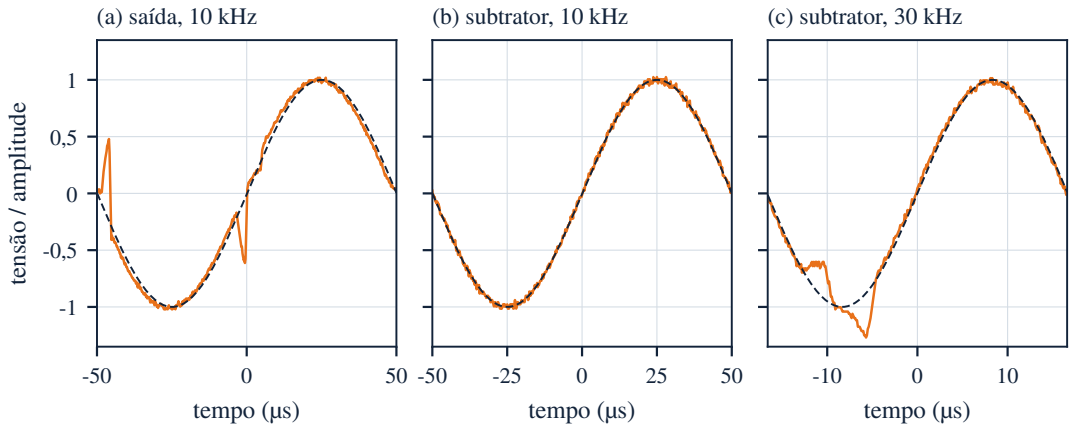
[picture p90: page 1]
tempo (µs); tensão / amplitude; (a) saída, 10 kHz; (b) subtrator, 10 kHz; (c) subtrator, 30 kHz
