nseiC/dds_waveform_generator/overleaf/figuras/bancada_formas.pdf

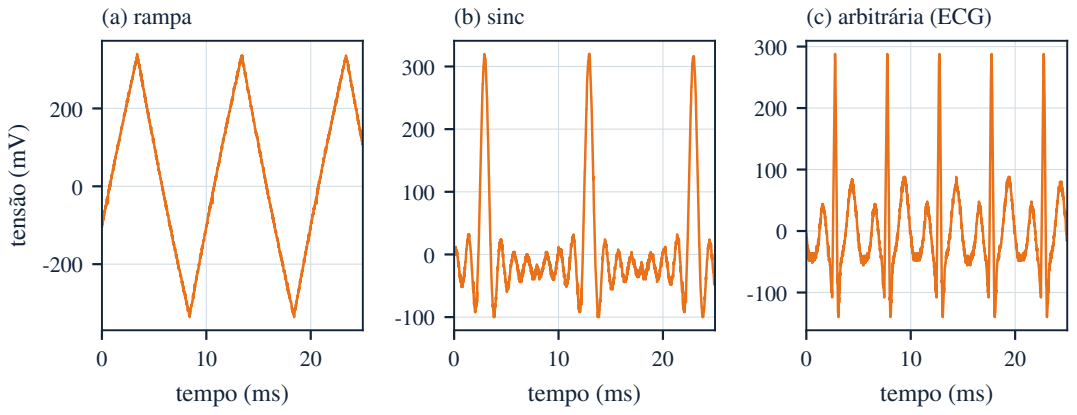
[picture p91: page 1]
tempo (ms); tensão (mV); (a) rampa; (b) sinc; (c) arbitrária (ECG)
