nseiC/dds_waveform_generator/overleaf/figuras/bancada_senos.pdf

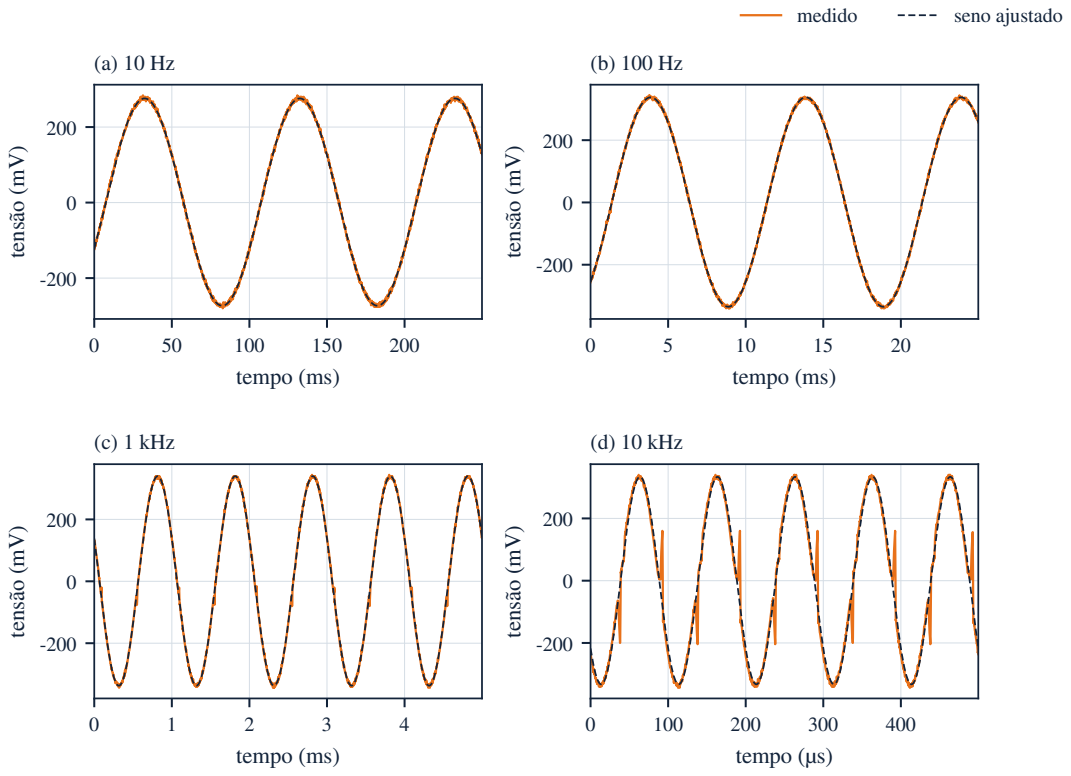
[picture p92: page 1]
tempo (ms); tensão (mV); (c) 1 kHz; tempo (µs); (d) 10 kHz; medido; seno ajustado
