nseiC/dds_waveform_generator/overleaf/figuras/sistema.pdf

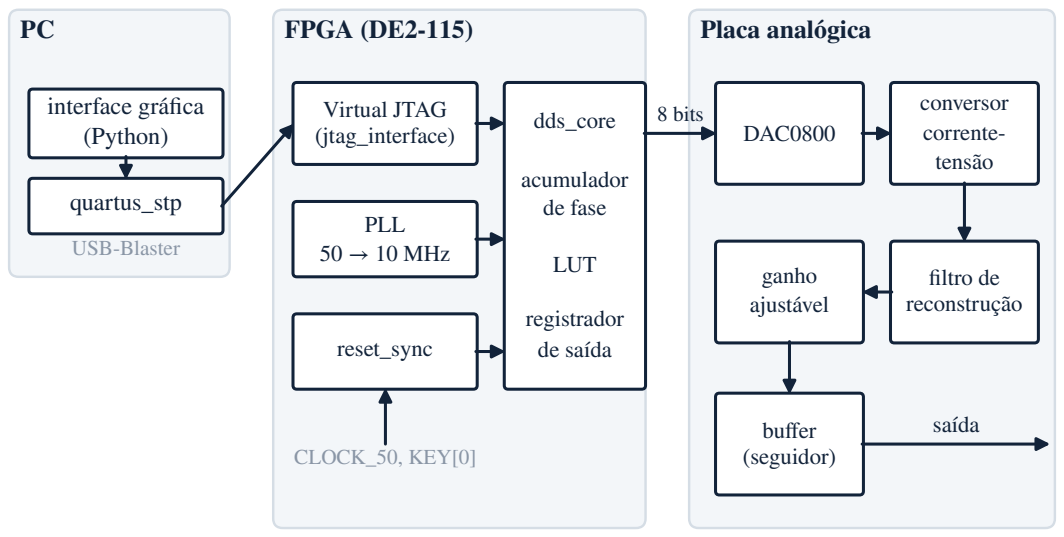
[picture p93: page 1]
FPGA (DE2-115); Placa analógica; interface gráfica (Python); quartus_stp USB-Blaster; Virtual JTAG (jtag_interface); PLL 50 → 10 MHz; reset_sync; dds_core; acumulador de fase; LUT; registrador de saída; CLOCK_50, KEY[0]; DAC0800; conversor corrente- tensão; filtro de reconstrução; ganho ajustável; buffer (seguidor); 8 bits; saída
