nseiC/dds_waveform_generator/overleaf/figuras/spice_tempo.pdf

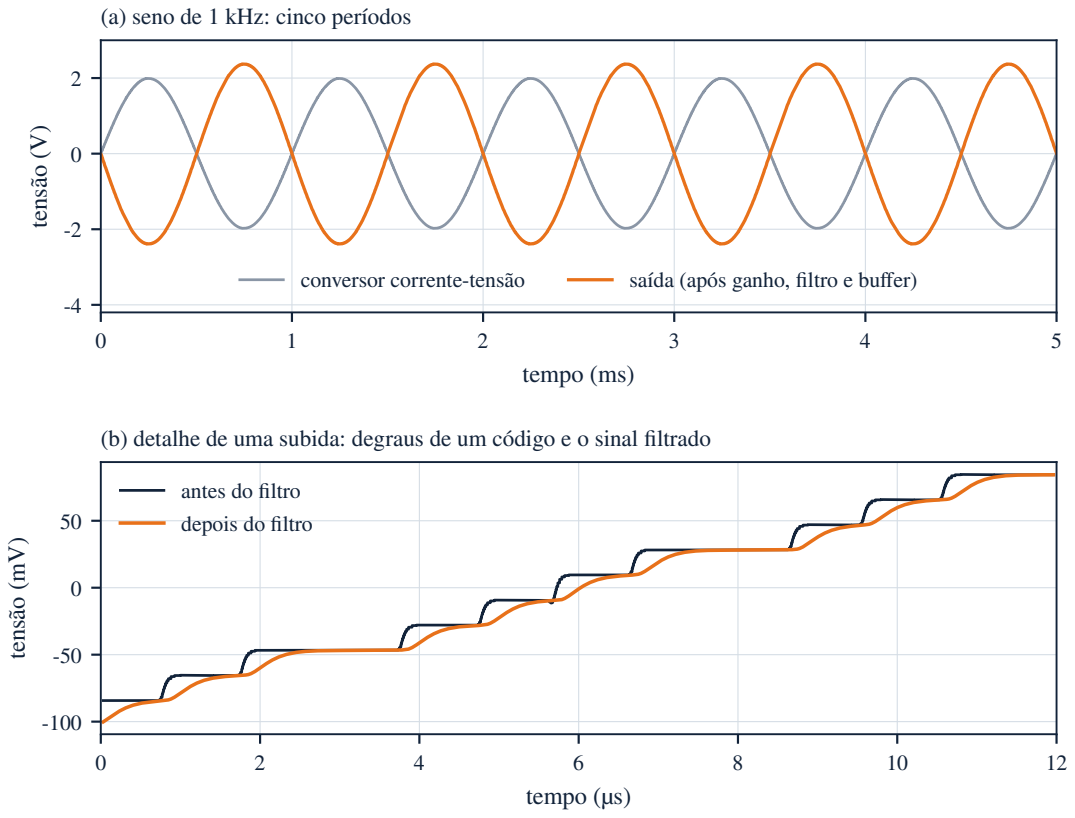
[picture p94: page 1]
tempo (ms); tensão (V); conversor corrente-tensão; saída (após ganho, filtro e buffer); tempo (µs); tensão (mV)

(a) seno de 1 kHz: cinco períodos

(b) detalhe de uma subida: degraus de um código e o sinal filtrado
antes do filtro
depois do filtro
