nseiC/dds_waveform_generator/overleaf/figuras/dds_blocos.pdf

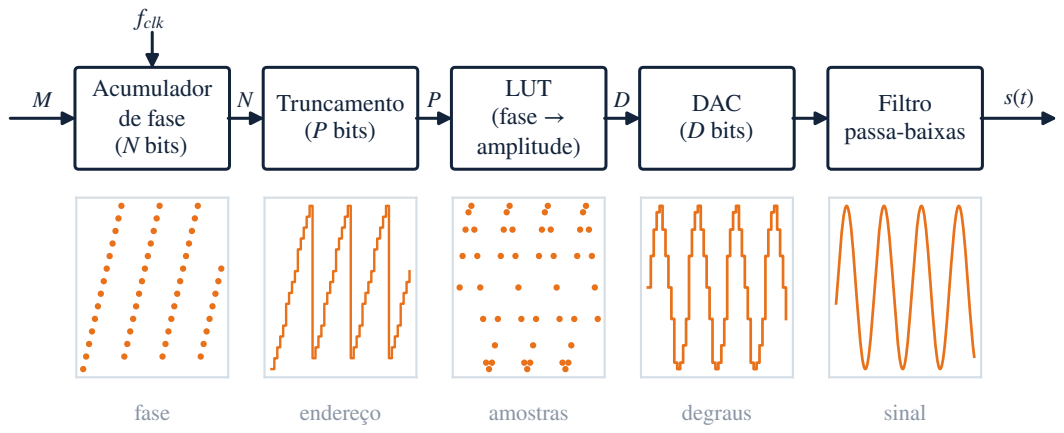
[picture p95: page 1]
Acumulador de fase (N bits); Truncamento (P bits); LUT (fase → amplitude); DAC (D bits); Filtro passa-baixas; fclk; fase; endereço; amostras; degraus; sinal
