nseiC/dds_waveform_generator/overleaf/figuras/espectros.pdf

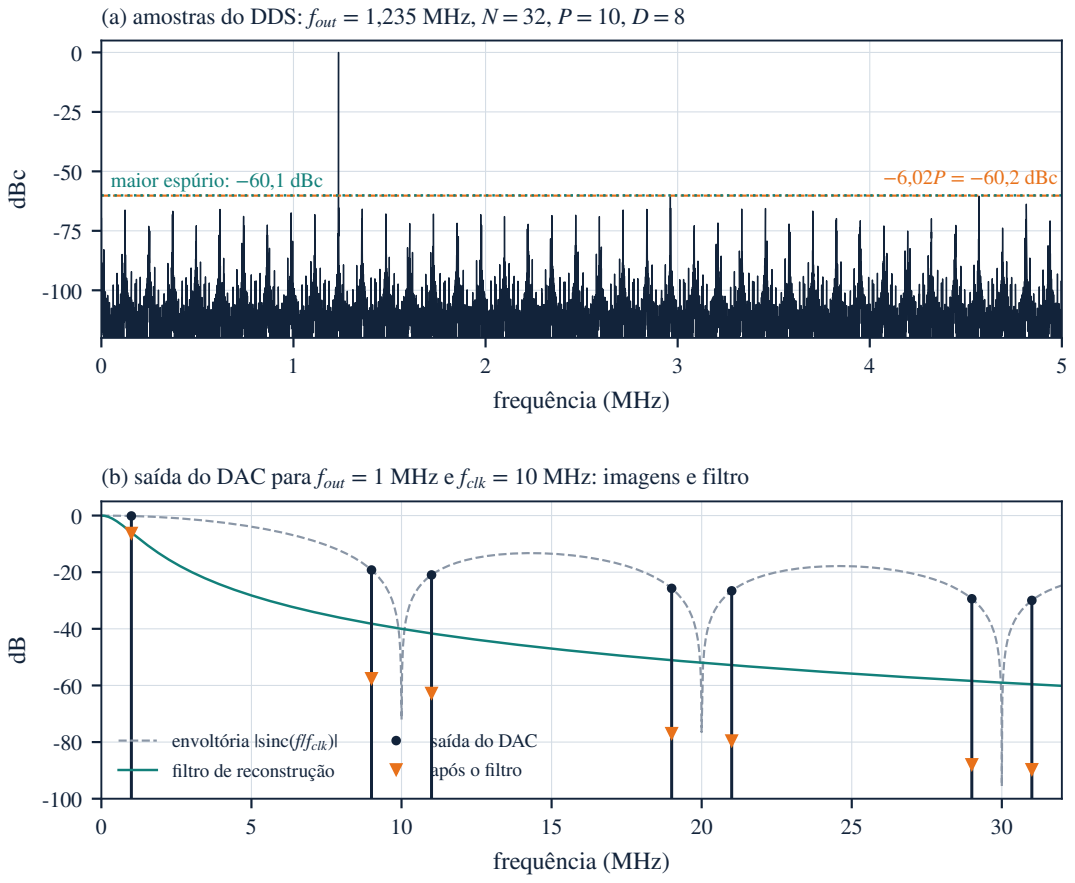
[picture p96: page 1]
frequência (MHz); dBc; maior espúrio: −60,1 dBc; −6,02P = −60,2 dBc; (a) amostras do DDS: fout = 1,235 MHz, N = 32, P = 10, D = 8; (b) saída do DAC para fout = 1 MHz e fclk = 10 MHz: imagens e filtro

envoltória |sinc(f/fclk)| | saída do DAC
filtro de reconstrução | após o filtro
