nseiC/dds_waveform_generator/overleaf/figuras/luts.pdf

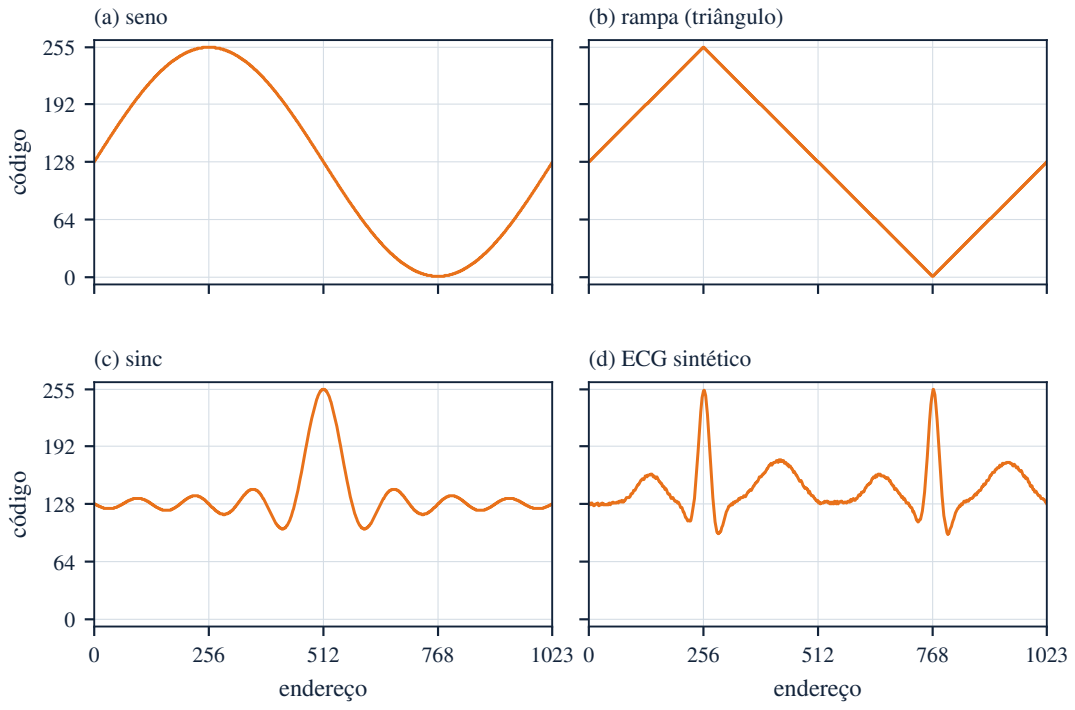
[picture p97: page 1]
código; (a) seno; (b) rampa (triângulo); endereço; (c) sinc; (d) ECG sintético
