nseiC/dds_waveform_generator/overleaf/figuras/roda_fase.pdf

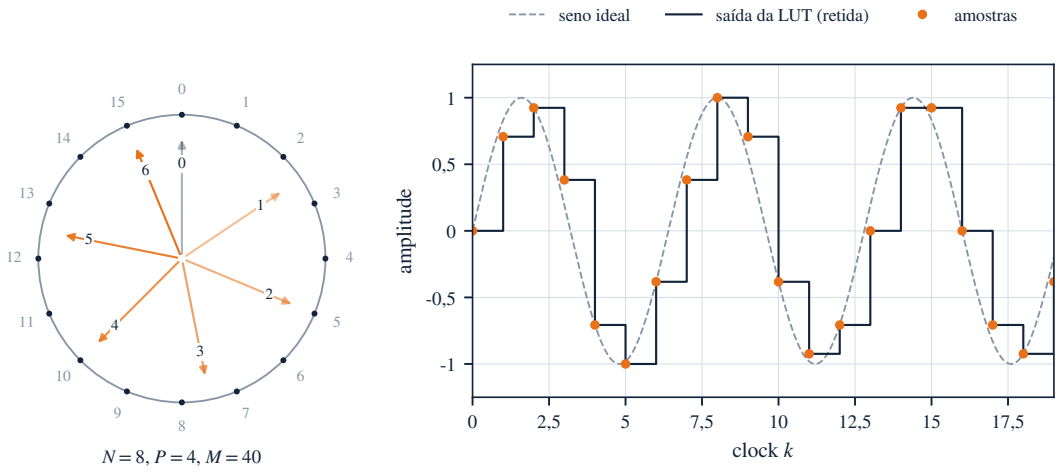
[picture p98: page 1]
clock k; amplitude; seno ideal; saída da LUT (retida); amostras
