nseiC/dds_waveform_generator/overleaf/figuras/tb_control_registers.pdf

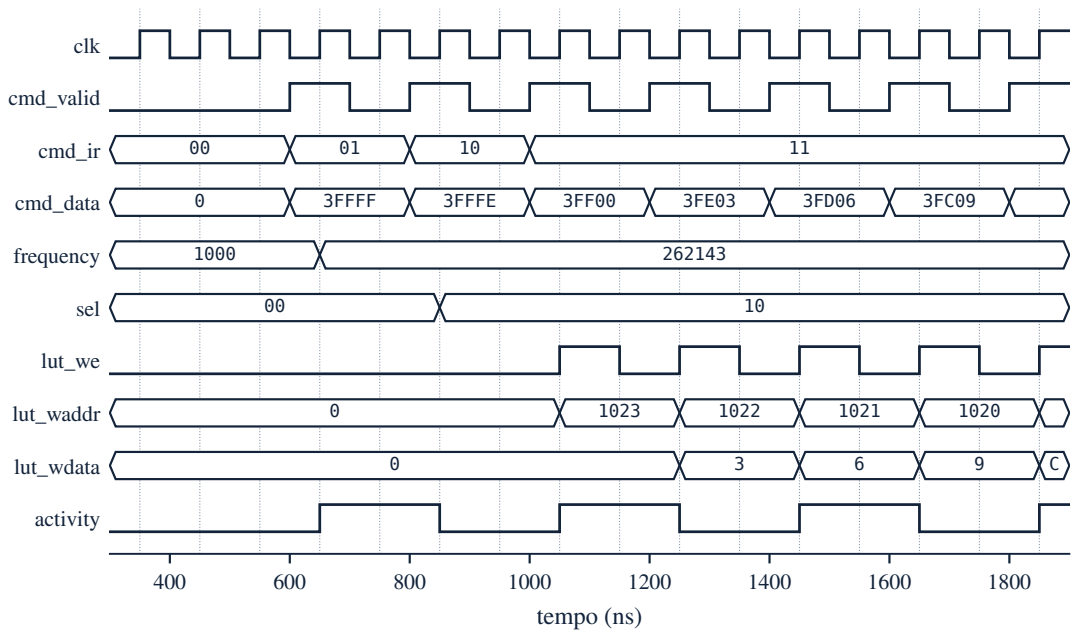
[picture p99: page 1]
tempo (ns); clk; cmd_valid; cmd_ir; cmd_data; frequency; sel; lut_we; lut_waddr; lut_wdata; activity; 3FFFF; 3FFFE
