nseiC/dds_waveform_generator/overleaf/figuras/tb_DDS_saida.pdf

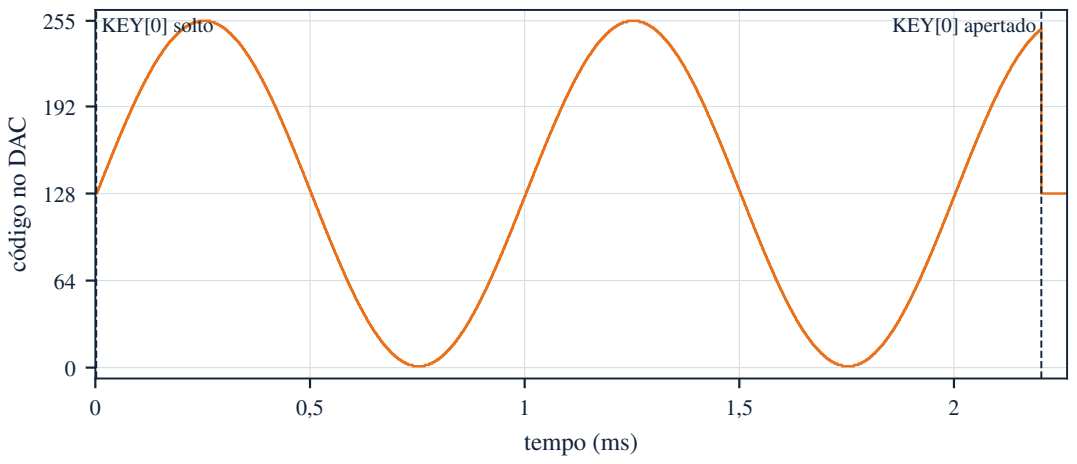
[picture p100: page 1]
tempo (ms); KEY[0] solto; KEY[0] apertado

código no DAC
