nseiC/dds_waveform_generator/overleaf/figuras/tb_LUT_tabelas.pdf

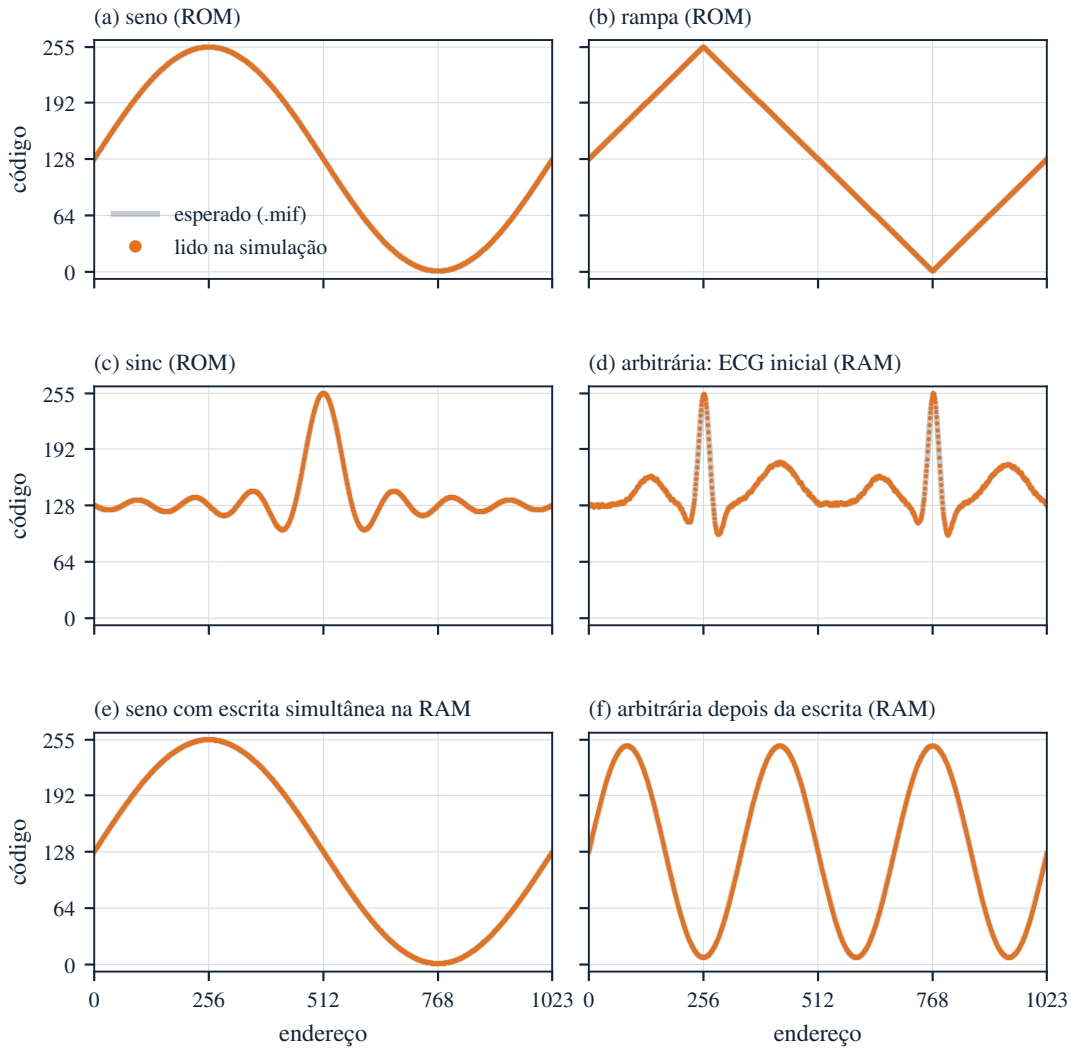
[picture p101: page 1]
código; (a) seno (ROM); (b) rampa (ROM); (c) sinc (ROM); (d) arbitrária: ECG inicial (RAM); endereço; (e) seno com escrita simultânea na RAM

esperado (.mif)
lido na simulação

(f) arbitrária depois da escrita (RAM)
