nseiC/dds_waveform_generator/overleaf/figuras/tb_out_mux.pdf

## sel

## q_sine

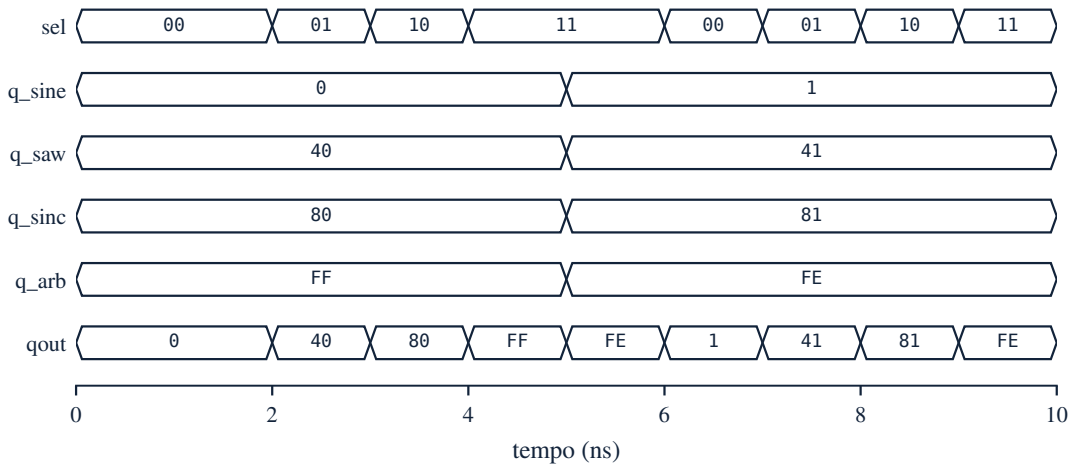
[picture p102: page 1]
tempo (ns); q_saw; q_sinc; q_arb; qout
