nseiC/dds_waveform_generator/overleaf/figuras/tb_vjtag_dr.pdf

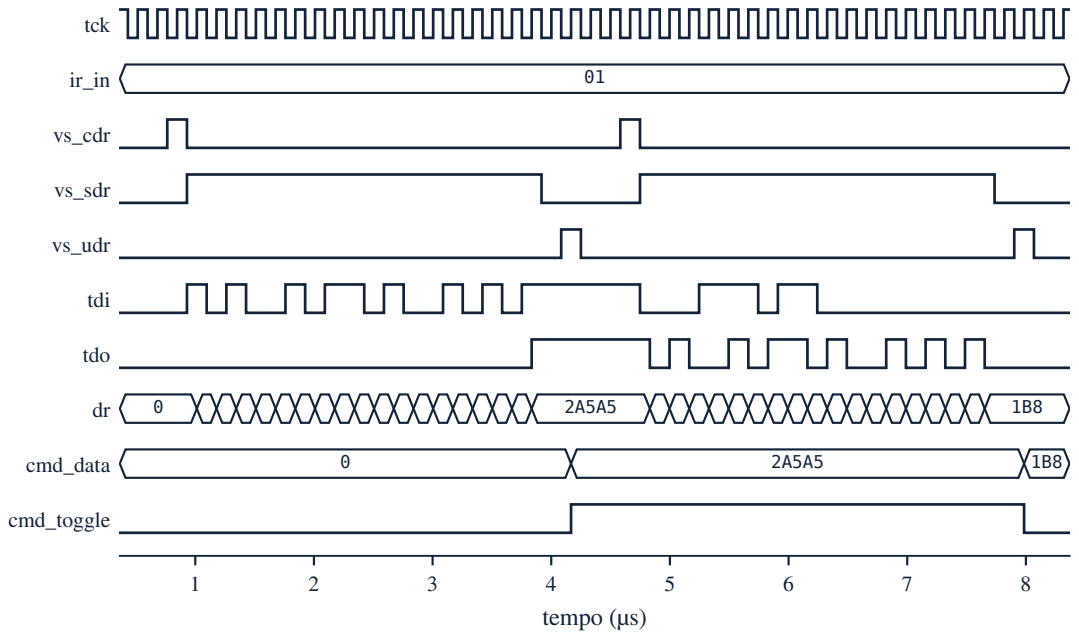
[picture p103: page 1]
tempo (µs); tck; vs_cdr; vs_sdr; vs_udr; tdi; tdo; cmd_data; cmd_toggle
