nseiC/dds_waveform_generator/analog/modelos/DAC0800/tests/02_all_codes.cir

* DAC0800 test 02 - all 256 codes and Table 3 (symmetrical offset binary)
*  a) unipolar, IOUT into an ideal transimpedance stage: monotonic, every
*     step 1 LSB +-1/2 LSB, IOUT + IOUTB = IFS = 255/256 IREF for every code
*  b) Figure 23 (op amp, RL = RL' = 5k, VREF = 10 V): EO = VREF*(-255/256 +
*     2X/256) - +9.960 / +0.040 / -0.040 / -9.960 V at 255 / 128 / 127 / 0
.include dac0800_ng.lib
Vp vp 0 15
Vm vm 0 -15
Vr vr 0 10
Vb1 b1 0 PWL(0 0 1e-06 0 1.005e-06 0 2e-06 0 2.005e-06 0 3e-06 0 3.005e-06 0 4e-06 0 4.005e-06 0 5e-06 0 5.005e-06 0 6e-06 0 6.005e-06 0 7e-06 0 7.005e-06 0 8e-06 0 8.005e-06 0 9e-06 0 9.005e-06 0 1e-05 0 1.0005e-05 0 1.1e-05 0 1.1005e-05 0 1.2e-05 0 1.2005e-05 0 1.3e-05 0 1.3005e-05 0 1.4e-05 0 1.4005e-05 0 1.5e-05 0 1.5005e-05 0 1.6e-05 0 1.6005e-05 0 1.7e-05 0 1.7005e-05 0 1.8e-05 0 1.8005e-05 0 1.9e-05 0 1.9005e-05 0 2e-05 0 2.0005e-05 0 2.1e-05 0 2.1005e-05 0 2.2e-05 0 2.2005e-05 0 2.3e-05 0 2.3005e-05 0 2.4e-05 0 2.4005e-05 0 2.5e-05 0 2.5005e-05 0 2.6e-05 0 2.6005e-05 0 2.7e-05 0 2.7005e-05 0 2.8e-05 0 2.8005e-05 0 2.9e-05 0 2.9005e-05 0 3e-05 0 3.0005e-05 0 3.1e-05 0 3.1005e-05 0 3.2e-05 0 3.2005e-05 0 3.3e-05 0 3.3005e-05 0 3.4e-05 0 3.4005e-05 0 3.5e-05 0 3.5005e-05 0 3.6e-05 0 3.6005e-05 0 3.7e-05 0 3.7005e-05 0 3.8e-05 0 3.8005e-05 0 3.9e-05 0 3.9005e-05 0 4e-05 0 4.0005e-05 0 4.1e-05 0 4.1005e-05 0 4.2e-05 0 4.2005e-05 0 4.3e-05 0 4.3005e-05 0 4.4e-05 0 4.4005e-05 0 4.5e-05 0 4.5005e-05 0 4.6e-05 0 4.6005e-05 0 4.7e-05 0 4.7005e-05 0 4.8e-05 0 4.8005e-05 0 4.9e-05 0 4.9005e-05 0 5e-05 0 5.0005e-05 0 5.1e-05 0 5.1005e-05 0 5.2e-05 0 5.2005e-05 0 5.3e-05 0 5.3005e-05 0 5.4e-05 0 5.4005e-05 0 5.5e-05 0 5.5005e-05 0 5.6e-05 0 5.6005e-05 0 5.7e-05 0 5.7005e-05 0 5.8e-05 0 5.8005e-05 0 5.9e-05 0 5.9005e-05 0 6e-05 0 6.0005e-05 0 6.1e-05 0 6.1005e-05 0 6.2e-05 0 6.2005e-05 0 6.3e-05 0 6.3005e-05 0 6.4e-05 0 6.4005e-05 0 6.5e-05 0 6.5005e-05 0 6.6e-05 0 6.6005e-05 0 6.7e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
005 5 0.000251 5 0.000251005 5 0.000252 5 0.000252005 5 0.000253 5 0.000253005 5 0.000254 5 0.000254005 5 0.000255 5 0.000255005 5)
Vb2 b2 0 PWL(0 0 1e-06 0 1.005e-06 0 2e-06 0 2.005e-06 0 3e-06 0 3.005e-06 0 4e-06 0 4.005e-06 0 5e-06 0 5.005e-06 0 6e-06 0 6.005e-06 0 7e-06 0 7.005e-06 0 8e-06 0 8.005e-06 0 9e-06 0 9.005e-06 0 1e-05 0 1.0005e-05 0 1.1e-05 0 1.1005e-05 0 1.2e-05 0 1.2005e-05 0 1.3e-05 0 1.3005e-05 0 1.4e-05 0 1.4005e-05 0 1.5e-05 0 1.5005e-05 0 1.6e-05 0 1.6005e-05 0 1.7e-05 0 1.7005e-05 0 1.8e-05 0 1.8005e-05 0 1.9e-05 0 1.9005e-05 0 2e-05 0 2.0005e-05 0 2.1e-05 0 2.1005e-05 0 2.2e-05 0 2.2005e-05 0 2.3e-05 0 2.3005e-05 0 2.4e-05 0 2.4005e-05 0 2.5e-05 0 2.5005e-05 0 2.6e-05 0 2.6005e-05 0 2.7e-05 0 2.7005e-05 0 2.8e-05 0 2.8005e-05 0 2.9e-05 0 2.9005e-05 0 3e-05 0 3.0005e-05 0 3.1e-05 0 3.1005e-05 0 3.2e-05 0 3.2005e-05 0 3.3e-05 0 3.3005e-05 0 3.4e-05 0 3.4005e-05 0 3.5e-05 0 3.5005e-05 0 3.6e-05 0 3.6005e-05 0 3.7e-05 0 3.7005e-05 0 3.8e-05 0 3.8005e-05 0 3.9e-05 0 3.9005e-05 0 4e-05 0 4.0005e-05 0 4.1e-05 0 4.1005e-05 0 4.2e-05 0 4.2005e-05 0 4.3e-05 0 4.3005e-05 0 4.4e-05 0 4.4005e-05 0 4.5e-05 0 4.5005e-05 0 4.6e-05 0 4.6005e-05 0 4.7e-05 0 4.7005e-05 0 4.8e-05 0 4.8005e-05 0 4.9e-05 0 4.9005e-05 0 5e-05 0 5.0005e-05 0 5.1e-05 0 5.1005e-05 0 5.2e-05 0 5.2005e-05 0 5.3e-05 0 5.3005e-05 0 5.4e-05 0 5.4005e-05 0 5.5e-05 0 5.5005e-05 0 5.6e-05 0 5.6005e-05 0 5.7e-05 0 5.7005e-05 0 5.8e-05 0 5.8005e-05 0 5.9e-05 0 5.9005e-05 0 6e-05 0 6.0005e-05 0 6.1e-05 0 6.1005e-05 0 6.2e-05 0 6.2005e-05 0 6.3e-05 0 6.3005e-05 0 6.4e-05 0 6.4005e-05 5 6.5e-05 5 6.5005e-05 5 6.6e-05 5 6.6005e-05 5 6.7e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
005 5 0.000251 5 0.000251005 5 0.000252 5 0.000252005 5 0.000253 5 0.000253005 5 0.000254 5 0.000254005 5 0.000255 5 0.000255005 5)
Vb3 b3 0 PWL(0 0 1e-06 0 1.005e-06 0 2e-06 0 2.005e-06 0 3e-06 0 3.005e-06 0 4e-06 0 4.005e-06 0 5e-06 0 5.005e-06 0 6e-06 0 6.005e-06 0 7e-06 0 7.005e-06 0 8e-06 0 8.005e-06 0 9e-06 0 9.005e-06 0 1e-05 0 1.0005e-05 0 1.1e-05 0 1.1005e-05 0 1.2e-05 0 1.2005e-05 0 1.3e-05 0 1.3005e-05 0 1.4e-05 0 1.4005e-05 0 1.5e-05 0 1.5005e-05 0 1.6e-05 0 1.6005e-05 0 1.7e-05 0 1.7005e-05 0 1.8e-05 0 1.8005e-05 0 1.9e-05 0 1.9005e-05 0 2e-05 0 2.0005e-05 0 2.1e-05 0 2.1005e-05 0 2.2e-05 0 2.2005e-05 0 2.3e-05 0 2.3005e-05 0 2.4e-05 0 2.4005e-05 0 2.5e-05 0 2.5005e-05 0 2.6e-05 0 2.6005e-05 0 2.7e-05 0 2.7005e-05 0 2.8e-05 0 2.8005e-05 0 2.9e-05 0 2.9005e-05 0 3e-05 0 3.0005e-05 0 3.1e-05 0 3.1005e-05 0 3.2e-05 0 3.2005e-05 5 3.3e-05 5 3.3005e-05 5 3.4e-05 5 3.4005e-05 5 3.5e-05 5 3.5005e-05 5 3.6e-05 5 3.6005e-05 5 3.7e-05 5 3.7005e-05 5 3.8e-05 5 3.8005e-05 5 3.9e-05 5 3.9005e-05 5 4e-05 5 4.0005e-05 5 4.1e-05 5 4.1005e-05 5 4.2e-05 5 4.2005e-05 5 4.3e-05 5 4.3005e-05 5 4.4e-05 5 4.4005e-05 5 4.5e-05 5 4.5005e-05 5 4.6e-05 5 4.6005e-05 5 4.7e-05 5 4.7005e-05 5 4.8e-05 5 4.8005e-05 5 4.9e-05 5 4.9005e-05 5 5e-05 5 5.0005e-05 5 5.1e-05 5 5.1005e-05 5 5.2e-05 5 5.2005e-05 5 5.3e-05 5 5.3005e-05 5 5.4e-05 5 5.4005e-05 5 5.5e-05 5 5.5005e-05 5 5.6e-05 5 5.6005e-05 5 5.7e-05 5 5.7005e-05 5 5.8e-05 5 5.8005e-05 5 5.9e-05 5 5.9005e-05 5 6e-05 5 6.0005e-05 5 6.1e-05 5 6.1005e-05 5 6.2e-05 5 6.2005e-05 5 6.3e-05 5 6.3005e-05 5 6.4e-05 5 6.4005e-05 0 6.5e-05 0 6.5005e-05 0 6.6e-05 0 6.6005e-05 0 6.7e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
005 5 0.000251 5 0.000251005 5 0.000252 5 0.000252005 5 0.000253 5 0.000253005 5 0.000254 5 0.000254005 5 0.000255 5 0.000255005 5)
Vb4 b4 0 PWL(0 0 1e-06 0 1.005e-06 0 2e-06 0 2.005e-06 0 3e-06 0 3.005e-06 0 4e-06 0 4.005e-06 0 5e-06 0 5.005e-06 0 6e-06 0 6.005e-06 0 7e-06 0 7.005e-06 0 8e-06 0 8.005e-06 0 9e-06 0 9.005e-06 0 1e-05 0 1.0005e-05 0 1.1e-05 0 1.1005e-05 0 1.2e-05 0 1.2005e-05 0 1.3e-05 0 1.3005e-05 0 1.4e-05 0 1.4005e-05 0 1.5e-05 0 1.5005e-05 0 1.6e-05 0 1.6005e-05 5 1.7e-05 5 1.7005e-05 5 1.8e-05 5 1.8005e-05 5 1.9e-05 5 1.9005e-05 5 2e-05 5 2.0005e-05 5 2.1e-05 5 2.1005e-05 5 2.2e-05 5 2.2005e-05 5 2.3e-05 5 2.3005e-05 5 2.4e-05 5 2.4005e-05 5 2.5e-05 5 2.5005e-05 5 2.6e-05 5 2.6005e-05 5 2.7e-05 5 2.7005e-05 5 2.8e-05 5 2.8005e-05 5 2.9e-05 5 2.9005e-05 5 3e-05 5 3.0005e-05 5 3.1e-05 5 3.1005e-05 5 3.2e-05 5 3.2005e-05 0 3.3e-05 0 3.3005e-05 0 3.4e-05 0 3.4005e-05 0 3.5e-05 0 3.5005e-05 0 3.6e-05 0 3.6005e-05 0 3.7e-05 0 3.7005e-05 0 3.8e-05 0 3.8005e-05 0 3.9e-05 0 3.9005e-05 0 4e-05 0 4.0005e-05 0 4.1e-05 0 4.1005e-05 0 4.2e-05 0 4.2005e-05 0 4.3e-05 0 4.3005e-05 0 4.4e-05 0 4.4005e-05 0 4.5e-05 0 4.5005e-05 0 4.6e-05 0 4.6005e-05 0 4.7e-05 0 4.7005e-05 0 4.8e-05 0 4.8005e-05 5 4.9e-05 5 4.9005e-05 5 5e-05 5 5.0005e-05 5 5.1e-05 5 5.1005e-05 5 5.2e-05 5 5.2005e-05 5 5.3e-05 5 5.3005e-05 5 5.4e-05 5 5.4005e-05 5 5.5e-05 5 5.5005e-05 5 5.6e-05 5 5.6005e-05 5 5.7e-05 5 5.7005e-05 5 5.8e-05 5 5.8005e-05 5 5.9e-05 5 5.9005e-05 5 6e-05 5 6.0005e-05 5 6.1e-05 5 6.1005e-05 5 6.2e-05 5 6.2005e-05 5 6.3e-05 5 6.3005e-05 5 6.4e-05 5 6.4005e-05 0 6.5e-05 0 6.5005e-05 0 6.6e-05 0 6.6005e-05 0 6.7e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
005 5 0.000251 5 0.000251005 5 0.000252 5 0.000252005 5 0.000253 5 0.000253005 5 0.000254 5 0.000254005 5 0.000255 5 0.000255005 5)
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
