nseiC/dds_waveform_generator/analog/simulation/TCC.asc

C1: cap; 100n
C2: cap; 100n
C3: cap; 3.3n
C4: cap; 3.3n
R4: res; 1K
R5: res; 1K
R6: res; 1K
R7: res; 1K
R8: res; 5K
R9: res; 5K
R10: res; 10k
R11: res; 48
R12: res; 48
U1: DAC0800
U2: UniversalOpAmp2
U3: UniversalOpAmp2
U4: UniversalOpAmp2
U5: UniversalOpAmp2
U6: POTENTIOMETER; R=10k Angle = 30
U7: sources
Named nets: A1, A2, A3, A4, A5, A6, A7, A8, A, B, 0, 15N, CMP, 15P, 10P, DIFFERENTIAL, INVERTER, FILTERED, BUFFERED
DDS Analog Front-end
Nicholas Seifert - rev 1 oct 2026
.tran 5M
