nseiC/dds_waveform_generator/analog/simulation/FONTES.asc

V1: voltage
V2: voltage
V3: voltage
V4: voltage
V5: voltage
V6: voltage
V7: voltage
V8: voltage
V9: voltage; 15
V10: voltage; 15
V11: voltage; 10
Named nets: 0, A1, A2, A3, A4, A5, A6, A7, A8, 15P, 15N, 10P
