nseiC/dds_waveform_generator/(list of files, drawings)

Other design files:
analog/layout/esquematico.SchDoc
analog/layout/OUTPUT_GEN.SchDoc
analog/layout/PCB1.PcbDoc
analog/layout/PCB.PcbDoc
analog/layout/TCC.PrjPcb
