nseiC/dds_waveform_generator/(commit log)

2026-10-01 Adiciona LUT de seno 1024x8 (offset binary)
2026-10-01 Interface míínima
    Foram introduzidos :
    PLL @ 10 MHz
    Acumulador de fase @ 32 bits
    LUT com 3 Roms (Seno, Saw e Sinc) e 1 RAM para dados arbitrários.
2026-10-02 Adiciona interface Python do DDS via Virtual JTAG
    Biblioteca dds_jtag (quartus_stp) e GUI em Tkinter para enviar
    frequência, forma de onda e LUT arbitrária. Ignora arquivos do
    ambiente Python e o estado do editor do Platform Designer.
2026-10-02 Adiciona LUT de ECG sintético estocástico (ECGSYN, PhysioNet)
2026-10-02 Adiciona Virtual JTAG ao top-level DDS
    [jtag.csv]
2026-10-02 Adiciona README com o logo do projeto
    - docs/logo/: logo em fundo claro, fundo escuro e ícone, em SVG
    (texto convertido em contornos) e PNG 2x
    - README.md: logo (troca automática claro/escuro no GitHub),
    descrição da arquitetura DDS, tabelas de forma de onda e
    lista dos arquivos do logo
    Claude-Session: https://claude.ai/code/session_01PL6aLehwSCiw3YTUNfqCEi
2026-10-02 Aplica a identidade visual do projeto na interface Python
    - theme.py: paletas escura e clara com as cores do logo, fontes da
    marca (Space Grotesk, JetBrains Mono) com fallback para as do sistema,
    estilos ttk e o símbolo do logo desenhado em Canvas
    - gui.py: layout de ferramenta de engenharia — cabeçalho com a marca,
    barra de ferramentas em grupos (Conexão JTAG, LUT arbitrária), painel
    de propriedades (frequência, FTW, forma de onda com código sel,
    parâmetros do sistema), gráfico da LUT com grade e eixos, console com
    prompt Tcl, barra de status com estado da conexão e progresso;
    painéis redimensionáveis, menu Arquivo/Exibir e troca de tema
    - A lógica de conexão, e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
2026-10-02 Corrige ligações do DDS: endereço, realimentação, LUT e clocks
    - truncator: endereço da LUT pelos 10 bits mais significativos da fase
    - phase_accumulator: realimentação do somador pela saída do registrador
    - LUT: sinc_LUT em qsinc (havia dois drivers em qsaw) e out_mux com
    mapeamento nomeado (qout estava desconectado)
    - DDS: PLL alimentado por clk, acumulador em clk10MHz, sel e wren
    como portas de entrada
    [DDS.vhd, LUT.vhd, phase_accumulator.vhd, truncator.vhd]
2026-10-02 Adiciona testbench do DDS e script de simulação no GHDL
2026-10-02 Organiza o projeto Quartus e os fontes VHDL em fpga/
    Move o projeto (DDS.qpf/.qsf), os fontes VHDL, os IPs, o Virtual JTAG,
    as tabelas .mif e a simulação para fpga/. Os caminhos internos do
    Quartus continuam relativos ao projeto. A GUI passa a abrir as LUTs em
    fpga/lut/.
    README: nova estrutura, seção de simulação e estado atual com as
    correções de ligação do DDS.
    [jtag.csv]
2026-10-02 Adicionada a simulação aalógica - LTSpice;
    [codigos.csv]
2026-10-02 Ramo analógico
    [OUTPUT_GEN.SchDoc, PCB.PcbDoc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]
2026-10-02 Adiciona a simulação analógica do LTspice (analog/simulation)
    Esquemático do front-end (DAC0800, amplificadores e filtro), modelos do
    DAC0800 e do bloco de fontes, e os PWL dos 8 bits gerados a partir da
    simulação do VHDL (seno de 1 kHz). Os resultados do LTspice (.raw, .fft,
    .log) ficam fora do Git: são refeitos a cada simulação.
    [codigos.csv]
2026-10-02 Documenta as partes digital, analógica e da interface; README principal vira menu
    - README principal com menu para as três partes, diagrama do sistema,
    fotos da bancada e a animação da roda de fase
    - fpga/README.md: arquitetura, blocos, LUTs, JTAG, simulação e estado
    - analog/README.md: cadeia de sinal, cálculos de cada bloco, simulação no
    LTspice (com os resultados e a ordem dos bits invertida no TCC.asc) e a placa
    - GUI/README.md reorganizado, com o fluxo do JTAG e problemas comuns
    - docs/jogo/: roda de fase interativa (acumulador, LUT, filtro, aliasing e
    o desafio "descubra o M"), para publicar pelo GitHub Pages
    - docs/gerar_figuras.py gera a animação, as LUTs e a respost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
    [gerar_figuras.py]
2026-10-02 Implementa o controle pelo JTAG, encapsula o DDS e adiciona os testbenches
    FPGA
    - Controle pelo PC: vjtag_dr (DR no domínio do tck), cmd_sync (travessia
    tck -> 10 MHz) e control_registers, agrupados em jtag_control e
    jtag_interface. Frequência, forma e LUT deixam de ser portas do top-level;
    depois do reset a saída é um seno de 1 kHz.
    - arbitrary_LUT vira RAM de duas portas (escrita pelo PC, leitura pela
    fase), começando com o ECG.
    - dds_core reúne acumulador, LUT e o novo output_register; reset_sync
    sincroniza o reset; dds_pkg concentra as constantes; phase_register passa
    para a borda de subida. Cada função numa entidade, o top-level só liga.
    - Pinos da DE2-115 (os mesmo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
    [DDS.vhd, LUT.vhd, arbitrary_LUT.vhd, cmd_sync.vhd, control_registers.vhd, dds_core.vhd, dds_pkg.vhd]
2026-10-02 Adiciona o texto do TCC em LaTeX (modelo da COELE-CM, UTFPR Campo Mourão)
    Modelo de TCC do prof. Osmar Tormena Júnior para Engenharia Eletrônica da
    UTFPR Campo Mourão (licença CC0), na pasta overleaf/.
2026-10-02 Escreve a primeira versão do texto do TCC
    - Capítulos seguindo o modelo da COELE-CM: introdução (objetivos e
    justificativa), fundamentação teórica (DDS, FPGA e JTAG, circuitos de
    saída), metodologia, resultados e discussões e conclusão
    - Resumo, abstract, agradecimentos, dedicatória, epígrafe, metadados,
    siglas, referências e apêndice com a organização do repositório
    - Figuras de fundamentação e de sistema geradas por docs/gerar_figuras_tcc.py,
    mais as figuras dos testbenches e as fotos da bancada
    - O que ainda depende do autor aparece em vermelho (\pendente): banca,
    data da defesa, captura de tela da interface e ensaios de bancada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
2026-10-02 Adiciona os resultados da simulação analógica e retira o estágio classe AB
    - analog/simulation: TCC.asc com os nós nomeados e o .tran ativo; formas de
    onda e FFT exportadas do LTspice em resultados/ (compactadas)
    - TCC: seção 4.5 reescrita com as figuras de tempo e espectro; ganho, excursão,
    frequência e atraso conferem com o cálculo; THD de -70,9 dBc e maior
    componente indesejada em -67 dBc (imagem da tabela, limite de 6,02P)
    - A ordem dos bits na simulação estava correta: o aviso anterior vinha de uma
    leitura errada da netlist e foi retirado do TCC e dos READMEs
    - Estágio de saída classe AB retirado por distorção: a saída passa a ser o
    seguidor de tensão (texto,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
2026-10-02 Adiciona o projeto da placa (esquemático, layout e vista 3D) ao README e ao TCC
    - analog/figuras: esquemático, layout e vista 3D da placa (projeto do Altium
    aberto no KiCad); seção da placa no README da parte analógica com as figuras
    - analog/layout/TCC: início da importação do projeto no KiCad
    - TCC: figuras do esquemático e do layout, e a vista 3D junto da foto da
    placa montada; o texto registra que o estágio classe AB ainda aparece no
    projeto, mas foi retirado da montagem
    - .gitignore: travas e cópias de segurança do KiCad
2026-10-02 Adiciona as visões RTL do Quartus aos testbenches e ao TCC
    - fpga/testbenches/rtl: prints do RTL Viewer de cada entidade testada
    (a print do interior do IP do Virtual JTAG ficou como rtl_virtual_jtag_ip.png)
    - TCC: visão RTL antes da simulação de cada bloco nos resultados; Apêndice B
    com a visão RTL e a simulação dos blocos menores; esquemático do LTspice na
    metodologia da placa. Falta a visão RTL do vjtag_dr (marcada em vermelho)
    - READMEs: visões RTL no do FPGA e esquemático do LTspice no da parte analógica
2026-10-02 Adiciona a visão RTL do vjtag_dr ao TCC e aos testbenches
    - fpga/testbenches/rtl/rtl_vjtag_dr.png: o bloco do DR do Virtual JTAG no RTL
    - TCC: figura no lugar do aviso pendente, com a descrição do circuito
    (deslocamento, bypass, registradores do comando, shadow inferido como
    memória síncrona e o multiplexador de tdo)
    - .gitignore: preferências locais do KiCad (*.kicad_prl)
2026-10-02 Torna a interface executável e coloca a captura dela no TCC
    - GUI/build_exe.sh: empacota a interface com o PyInstaller num arquivo único
    (Python, Tkinter, ícone e tabelas .mif dentro) em GUI/dist/
    - GUI/install_launcher.sh: atalho "DDS Waveform Generator" no menu de
    aplicativos e na área de trabalho, sem precisar de terminal
    - gui.py: acha o ícone e as tabelas dentro do executável; o rótulo "Δf" virou
    "Resolução", porque o Tk empacotado não tinha o caractere Δ na fonte
    - Captura da interface no README da GUI e no TCC (seção da interface)
2026-10-02 Iguala a pinagem à do código legado e adiciona o clock do DAC no GPIO[1]
    O dac_clk (PIN_AC15) é o clock de 10 MHz invertido, gerado por um registrador DDR
    (dac_clock), com a borda de subida no meio da amostra. O rst_n volta ao padrão
    3.3-V LVTTL do TCCV1. O tb_DDS confere o clock do DAC, e o README, a hierarquia e
    as tabelas do TCC foram atualizados com a nova síntese.
2026-10-05 Adiciona os resultados de bancada da placa analógica e o apêndice com as telas do osciloscópio
    As capturas do TBS1102B na saída da placa (antes do antigo estágio classe AB) e na
    saída do subtrator ficam em analog/resultados, com a tela, os pontos em CSV e a
    configuração de cada medida. O gerar_figuras_tcc.py calcula frequência, SINAD e THD e
    desenha as figuras de bancada. O TCC ganha a seção de ensaios em bancada, o apêndice C
    com as 13 telas e um resumo mais curto; as tabelas do teste dos pesos dos bits vão
    para fpga/lut.
    [ecg_100Hz.csv, fft_10kHz_subamostrado.csv, fft_aliasing.csv, fft_pico_harmonico.csv, rampa_100Hz.csv, seno_100Hz.csv, seno_10Hz.csv, seno_10kHz.csv]
2026-10-05 Adiciona o código legado, explica o acumulador com o relógio de fase e registra R1, R2 e o capacitor do subtrator
    O fpga/legado traz os VHDL que geraram o .sof da bancada (seno de 256 posições a
    1 MHz, frequências pelas chaves) e o TCC ganha a seção do ponto de partida, com a
    comparação com o projeto final. O tópico do acumulador de fase troca o gráfico de
    endereços por uma ilustração do acumulador como relógio de 2^32 marcas. A seção de
    bancada registra o capacitor de 460 pF no R6 e R1 = R2 = 5 kOhm.
2026-10-05 Adiciona o apêndice do modelo SPICE do DAC0800 e tira o gráfico da conversão de frequência
    O apêndice D descreve o modelo comportamental do DAC0800, do repositório
    LTSpice-behavioral-IC-lib: diagrama de blocos, equações de cada bloco, parâmetros,
    uso na simulação, verificações contra o datasheet, limitações e o código completo.
    O tópico da conversão de frequência troca o gráfico do erro de truncamento por uma
    explicação ligada ao relógio de fase.
2026-10-05 Tira as pendências e as hipóteses do TCC e traz o modelo SPICE do DAC0800
    O texto fica só com o que foi medido: saem as notas em vermelho e as conclusões
    ainda não confirmadas sobre a amplitude do subtrator e a origem da distorção em
    10 kHz. A pasta do modelo do DAC0800 (modelo, símbolo, testes e exemplos) vem do
    repositório LTSpice-behavioral-IC-lib para analog/modelos/DAC0800, com a origem
    indicada no README. Entra também o projeto do KiCad atualizado.
2026-10-05 Adiciona os apêndices e as pastas dos instrumentos e dos softwares utilizados
    As pastas instruments/ e softwares/ trazem as imagens e um README de cada ferramenta,
    com o uso no projeto. O TCC ganha os apêndices E e F, com uma figura e uma descrição
    curta de cada item e uma tabela com os demais programas.
2026-10-05 Detalha a pinagem do FPGA e a ligação do barramento até o DAC0800
    A tabela de pinos do TCC passa a ter uma linha por porta, com o padrão de E/S e a
    corrente, e uma tabela nova mostra o caminho de cada bit: pino do FPGA, conector JP5
    da DE2-115, conector J1 da placa e pino do DAC0800. O README da parte digital ganha a
    mesma tabela de ligação.
2026-10-05 Adiciona o Pin Planner e o conector JP5 à pinagem, no TCC e no README
